tallen5431/Temperature_Sensor_V2/flash/README.md

# Browser-based flashing (ESP Web Tools)

This folder is a self-contained web page that flashes the **Setpoint** firmware
onto an **ESP32-C3** straight from a desktop browser — no Arduino IDE, no toolchain.
It's the **lowest-friction on-ramp for hobbyists / kit buyers**: they open a link,
click one button, and the probe is ready to set up.

```
flash/
├── index.html                    the flashing page (ESP Web Tools install button)
├── manifest.json                 firmware descriptor ESP Web Tools reads (chipFamily: ESP32-C3)
├── build_merged_bin.sh           builds the single merged .bin the page flashes
└── setpoint-esp32c3.merged.bin (generated — NOT committed, .gitignored)
```

> **Different board?** `manifest.json` targets the **ESP32-C3** we ship on. To
> support another chip, build its merged image and add a second entry to the
> `builds` array with the matching `chipFamily` (e.g. `"ESP32"`, `"ESP32-S3"`);
> ESP Web Tools auto-selects the build matching the connected chip.

> **"No OTA" is fine for browser flashing.** The firmware is built with the *No OTA
> (2MB APP / 2MB SPIFFS)* partition scheme because it's too large for the default
> layout. That does **not** affect web flashing: ESP Web Tools writes the entire
> image over USB serial, so an over-the-air update slot is irrelevant. The build
> script compiles with that exact scheme so the flashed layout matches your units.

## How it works

`index.html` loads the [ESP Web Tools](https://esphome.github.io/esp-web-tools/)
web component, which uses the browser's **Web Serial** API to talk to the ESP32
over USB. `manifest.json` tells it which binary to flash (a single merged image at
offset `0x0`).

**Browser support:** Web Serial works in **Chrome, Edge, and Opera on desktop**,
over **HTTPS** (or `http://localhost`). Safari, Firefox, and mobile browsers can't
flash — the page shows a note and points those users to manual flashing.

## Publishing it (one-time)

1. **Generate the firmware binary** (you need `arduino-cli` + the esp32 core, and
   `esptool`):
   ```bash
   arduino-cli core install esp32:esp32
   pip install esptool
   ./flash/build_merged_bin.sh          # writes flash/setpoint-esp32c3.merged.bin
   ```
   Bump `manifest.json`'s `version` **and** the `firmware v…` on `index.html`
   to match `FW_VERSION` (`esp32_temp_probe/esp32_temp_probe.ino`).
   `tests/test_version_sync.py` fails if you forget — this drifted twice while
   it was only a note here, and a stale `version` tells ESP Web Tools a probe
   on old firmware is already current.

2. **Host the `flash/` folder over HTTPS.** The easiest free option is **GitHub
   Pages**: enable Pages for this repo (Settings → Pages → deploy from the default
   branch), then the page is served at
   `https://<you>.github.io/<repo>/flash/`. Because the binary is `.gitignored`,
   either commit it to the Pages branch specifically or publish it as a release
   asset and point `manifest.json` at that URL.

3. **Link it** from your product listing, the unit label/QR, and the README.

> Like every firmware step here, the produced binary **must be validated on real
> ESP32-C3 hardware** (build → flash → QC per [`../docs/QC_CHECKLIST.md`](../docs/QC_CHECKLIST.md))
> before you ship it. Nothing in `flash/` has been run on hardware.

## Manual flashing (fallback / power users)

Anyone who can't (or would rather not) use the browser can flash with
`arduino-cli`/`esptool` directly — see [`../firmware/README.md`](../firmware/README.md).
The maker's assembly-line path stays [`../firmware/factory_flash.py`](../firmware/factory_flash.py).
