tallen5431/Temperature_Sensor_V2/PROTOCOL.md

# Setpoint ⇄ Setpoint Protocol

**Protocol version: `proto = 1`**
Product: **Setpoint** (hub) / **Setpoint** (probe). This contract is versioned by
`proto` (above), currently `1`; component software versions are tracked separately
(hub: `core/version.py` → `HUB_VERSION`; firmware: `FW_VERSION`) and are not pinned here.

This is the authoritative, versioned contract between Setpoint firmware and the
Setpoint appliance. It is the single source of truth for the wire format: identity,
discovery, provisioning, and ingest. Firmware and hub MUST both conform to this
document. Where this file and code disagree, that is a bug in one of them — fix it,
don't silently diverge.

Setpoint is a **local-first, no-cloud** appliance. All traffic in this document is
LAN-only (probe ⇄ hub, same subnet). There is no outbound telemetry and no account.

---

## 1. Terminology & versioning

| Term | Meaning |
|---|---|
| **Hub** | Setpoint — Python/Flask+Dash app served by waitress on the `PORT` env var: **8088** natively (`Start.sh`/`app.py` default), **8080** in the Docker image. |
| **Probe** | Setpoint — ESP32 firmware, HTTP server on TCP **80**. |
| **`proto`** | Integer protocol version. This document defines `proto = 1`. |
| **Device token** | One shared secret per hub. Authenticates mutating hub endpoints **and** is provisioned onto probes, which echo it back as `X-Token`. |
| **Provision secret** | **Reserved — not implemented in `proto = 1`.** A per-unit secret, intended to guard the probe's `/provision` endpoint in a future revision. No shipping firmware stores or checks one; see §4.1 and §12. Distinct from the device token. |

**Compatibility rule:** the hub **warns, it does not crash**, on an unknown or
mismatched `proto`. A probe advertising `proto` other than `1` is still listed and
its data still ingested on a best-effort basis; the hub logs a warning so the
mismatch is diagnosable. Firmware must therefore never assume a hub will reject it
purely for a version skew. Breaking wire changes require bumping `proto` to `2` and a
new revision of this document.

---

## 2. Probe identity

The probe identity is derived once, deterministically, from silicon and is the single
source of truth used everywhere (mDNS TXT, HTTP headers, `/whoami`).

```
suffix    = last 3 bytes of the ESP32 eFuse (base) MAC, uppercase hex (6 chars)
probe_id  = "Setpoint-" + suffix          e.g.  Setpoint-9A3F2C
hostname  = probe_id + ".local."          e.g.  Setpoint-9A3F2C.local.
```

- `probe_id` is stable for the life of the hardware.
- `probe_id` MUST match `^[A-Za-z0-9_-]{1,32}$`. The hub does **not** reject a
  value that fails it — a bad label is never a reason to lose a good temperature
  — it sanitizes to that charset and files the reading anyway (see §6.4).
- The **same** `probe_id` string appears in the mDNS TXT `id` key, in the
  `X-Probe-ID` ingest header, and in `/whoami`. These MUST be byte-for-byte equal.

---

## 3. mDNS discovery

The probe **advertises**; the hub **browses** (zeroconf).

| Field | Value |
|---|---|
| Service type | `_temps-probe._tcp.local.` |
| Transport / port | TCP **80** |
| Server (host) | `Setpoint-<HEX6>.local.` (== `probe_id`, verbatim) |

### TXT record keys

| Key | Value | Notes |
|-----|---|---|
| `id` | `<probe_id>` | e.g. `Setpoint-9A3F2C`. **Invariant:** this MUST equal the `X-Probe-ID` header the probe later sends on ingest. |
| `name` | friendly name, else `<probe_id>` | Human label; falls back to `probe_id`. |
| `fw` | firmware semver | e.g. `2.0.0`. |
| `proto` | `1` | Protocol version this firmware speaks. |

**`id == X-Probe-ID` invariant.** The hub keys and reconciles probes on this equality.
On ingest, if both the `X-Probe-ID` header and a body `probe_id` are present and they
disagree, the hub logs a warning (`probe_id mismatch: header=… body=…`) and proceeds
using the header value — it does not reject the reading.

> The hub also advertises *itself* over mDNS as an `_http._tcp.local.` service so a
> browser can find the dashboard. That is a convenience for humans and is **not** part
> of this probe protocol; probes never need to browse for the hub — they are told the
> ingest URL during provisioning (§5).

---

## 4. Probe HTTP endpoints (firmware serves, port 80)

### 4.1 `POST /provision`

Configures the probe with the hub's ingest URL, the device token, and the post
interval. Persisted to NVS so it survives reboots.

**Request headers**

| Header | Required | Value |
|---|---|---|
| `Content-Type` | yes | `application/json` |
| `X-Provision-Secret` | no — **reserved** | Reserved header name for a future per-unit secret. **Not implemented in `proto = 1`:** the shipping firmware accepts `/provision` from any host on the LAN, which is what makes zero-touch auto-provisioning work. A probe MUST NOT reject a request for lacking this header. See §12. |

**Request body**

```json
{
  "server_url": "http://192.168.1.50:8088/api/ingest",
  "token": "s3cr3t-device-token",
  "interval_ms": 5000,
  "resolution_bits": 11,
  "alert_min_c": 1.0,
  "alert_max_c": 5.0,
  "sample_ms": 60000
}
```

- `resolution_bits` is **optional** (DS18B20 resolution, `9`..`12`; 9=0.5 °C/~94 ms,
  10=0.25 °C, 11=0.125 °C/~375 ms default, 12=0.0625 °C/~750 ms). Omitting it leaves
  the probe's current resolution unchanged, so a hub that doesn't manage it (or an
  older one) is unaffected; an older probe simply ignores the unknown field. Note
  that 12-bit's 750 ms conversion exceeds a 500 ms interval and caps the sample rate.
- `alert_min_c`, `alert_max_c`, `sample_ms` are the **threshold watch** (hub ≥ 2.6.2,
  firmware ≥ 2.9.0), and are sent as a set or not at all. They let a probe on a long
  `interval_ms` notice an excursion between reports instead of sitting on it: it wakes
  every `sample_ms`, reads the sensor with the radio **off**, buffers the reading, and
  transmits early only when a reading crosses a limit. See §5.3.
  - The two limits are sent **including explicit `null`s**. A null CLEARS a limit the
    probe is holding — omitting the key instead would leave a probe watching a
    threshold the hub has deleted, waking every `sample_ms` for nobody.
  - A probe MUST ignore `sample_ms` unless it holds at least one limit **and**
    `sample_ms` is shorter than `interval_ms`; below a 5000 ms floor it MUST ignore it
    too. Sampling no faster than you report gains nothing and costs wakes.

**Response** `200 OK`

```json
{ "id": "Setpoint-9A3F2C", "name": "Garage Fridge", "fw": "2.0.0", "accepted": true }
```

The probe persists `server_url`, `token`, `interval_ms`, `resolution_bits` and the
three watch fields to NVS and begins posting (§5). It echoes `resolution_bits` in
`/whoami` and `/status`, and `watch_armed` / `sample_ms` / the limits in `/status`, so
the hub can confirm what was applied — a probe that was asleep when a limit changed
keeps the old one, and that drift is otherwise invisible from both ends.

> **Hub implementation note.** Setpoint's built-in auto-provisioner and the
> `POST /api/provision` endpoint push
> `{server_url, token, interval_ms, resolution_bits, alert_min_c, alert_max_c, sample_ms}`
> to the probe's `/provision` (trying the probe IP first, then its `.local` hostname).
> No provision secret is sent or required — no firmware revision enforces one (§4.1).
> Anything on the LAN that can reach the probe can provision it.

### 4.2 `GET /whoami`

```json
{ "id": "Setpoint-9A3F2C", "name": "Garage Fridge", "fw": "2.0.0", "mac": "24:6F:28:9A:3F:2C" }
```

`id` MUST equal the mDNS TXT `id` and the `X-Probe-ID` ingest header.

### 4.3 `GET /status`

```json
{
  "id": "Setpoint-9A3F2C",
  "wifi_rssi": -57,
  "uptime_s": 43120,
  "last_post_ok": true,
  "last_post_code": 200,
  "server_url": "http://192.168.1.50:8088/api/ingest",
  "temperature_c": 4.2,
  "sensor_ok": true
}
```

`sensor_ok` is `false` when the sensor reports a fault (see §8); in that state the
probe skips posting.

A probe running the threshold watch (§5.3) also reports what it is **actually
holding**, which is not always what the hub last decided — a probe asleep when a
limit changed keeps the old one, and without this the drift is invisible from both
ends. A hub SHOULD compare these before re-provisioning, or it either re-pushes
every cycle or never notices a stale limit:

```json
{ "…": "…", "watch_armed": true, "sample_ms": 60000,
  "alert_min_c": 1.0, "alert_max_c": 5.0, "in_breach": false }
```

`sample_ms`, `watch_armed` and `in_breach` are always present on firmware ≥ 2.9.0;
each limit appears only while it is set, so an absent key means "no limit", matching
the `null` the hub sends to clear one. Firmware that predates the watch omits all of
them, and a hub MUST treat that as "nothing to compare" rather than as a mismatch.

On the humidity build variant (firmware built with `-D SENSOR_SHT4x`, see §8) the
response carries one extra field, `humidity_pct` (0–100):

```json
{ "…": "…", "temperature_c": 24.1, "humidity_pct": 58.3, "sensor_ok": true }
```

Temperature-only builds (DS18B20 / MAX31855) omit `humidity_pct` entirely.

---

## 5. Ingest — probe → hub

Every `interval_ms`, the probe POSTs the latest good reading to the provisioned
`server_url` (which is the hub's `POST /api/ingest`).

**Request headers**

| Header | Required | Value |
|---|---|---|
| `Content-Type` | yes | `application/json` |
| `X-Probe-ID` | yes | `<probe_id>` — MUST equal the mDNS TXT `id`. |
| `X-Token` | yes* | The device token received during provisioning. *Required whenever the hub has a token set (the shipped product always does — see §7). |

**Request body**

```json
{
  "temperature_c": 4.2,
  "probe_id": "Setpoint-9A3F2C",
  "timestamp": "2026-07-06T14:03:11"
}
```

- Send **`temperature_c`** (preferred) **or** `temperature_f`; the hub derives the
  other. (For robustness the hub also accepts the aliases `temp_c`/`t_c`/`c` and
  `temp_f`/`t_f`/`f`, but firmware SHOULD emit `temperature_c`.)
- `probe_id` in the body is optional but SHOULD be sent and MUST match `X-Probe-ID`.
- `timestamp` is optional ISO-8601, and **may carry millisecond precision**
  (`2026-07-06T14:03:11.500Z`), which the hub preserves so a high-rate cadence
  (down to the 500 ms floor) stays distinguishable instead of collapsing onto one
  whole-second stamp. The hub holds the authoritative clock, so if the field is
  omitted **or not a valid ISO datetime** the hub stamps its own receipt time. A
  probe with a synced clock (NTP, or an RTC restored across deep sleep) SHOULD
  send it — the current firmware does, to ms precision. (Alias `ts` also accepted.)
- **`humidity_pct`** is **optional** (0–100 %RH). Only the SHT4x build variant emits
  it; temperature-only probes omit it. The hub validates it (finite, 0–100) and
  silently ignores anything invalid. (Aliases `humidity`/`rh`/`h` also accepted.)
  A reading *with* humidity looks like:

```json
{
  "temperature_c": 24.1,
  "humidity_pct": 58.3,
  "probe_id": "Setpoint-9A3F2C",
  "timestamp": "2026-07-06T14:03:11"
}
```

- **`battery_pct`** is **optional** (0–100 %): a battery-powered probe MAY report its
  remaining charge. Mains-powered probes simply omit it.
- **`battery_v`** is **optional** (volts): as an alternative to `battery_pct`, a probe
  may report its raw single-cell LiPo pack voltage and let the hub do the conversion —
  the hub maps it linearly **3.0 V → 0 %, 4.2 V → 100 %** and clamps to that range. A
  voltage outside the plausible cell band (2.5–5.0 V) is sensor junk, not a nearly
  full/empty cell, and is treated as "no battery reading". When `battery_pct` is
  present it takes precedence and `battery_v` is not consulted.
- **`site`** is **optional** and is sent as the **`X-Site` header**, not a body field —
  it labels a whole batch, not a row. It exists for multi-site roll-up: a store hub
  forwarding its readings to an aggregating hub tags them with its own site name so
  head office can tell six stores apart. A probe posting directly never sends it, and
  every reading on a single-site hub therefore carries `site = ''`. Sanitised to
  `[A-Za-z0-9_-]`, 32 chars, like `probe_id`. Rows that carry a site are **not**
  forwarded onward, which is what stops two hubs pointed at each other from looping.
  See [`docs/MULTI_SITE.md`](docs/MULTI_SITE.md).
- Both battery fields are **ignored when absent or invalid** — like humidity, battery
  is never a reason to reject a good temperature (see §6). The derived percentage is
  stored per reading and surfaced in the hub UI and readings API; adding these
  backward-compatible optional fields required **no `proto` change**.

#### Humidity & VPD

The probe only ever reports **temperature** and (on the SHT4x variant) **humidity**.
**VPD (vapour pressure deficit) is not part of the wire protocol** — the probe never
sends it. The **hub computes VPD** from the temperature + humidity of each reading
using the **Tetens** saturation-vapour-pressure formula, optionally applying a
leaf-temperature offset from hub config `settings.vpd_leaf_offset_c` (default `0.0`;
growers commonly use `~2.0` to model leaf-below-air temperature). VPD is derived,
stored, and displayed entirely hub-side, so adding it required **no `proto` change**:
`humidity_pct` is a backward-compatible optional field and this document remains
`proto = 1`.

**Success** `200 OK`

```json
{
  "ok": true,
  "config": {
    "interval_ms": 300000,
    "resolution_bits": 11,
    "alert_min_c": 1.0,
    "alert_max_c": 5.0,
    "sample_ms": 60000
  }
}
```

**`config` — settings delivery back to the probe (hub ≥ 2.6.2, firmware ≥ 2.8.1).**
The hub returns the settings it wants this probe (identified by `X-Probe-ID` or the
body's `probe_id`) to be running. A probe SHOULD apply them and persist them, and
MUST tolerate the key being absent — an older hub simply omits it.

This exists because pushing to the probe's `POST /provision` (§4.1) is unreliable
for a deep-sleeping probe: it serves its HTTP window for only a few seconds every
Nth wake, so on a long interval the hub can rarely catch it awake and a settings
change may never be delivered. The probe's own ingest POST happens every wake and
always succeeds, so config rides home on the reply at no extra radio cost. The two
paths derive the value from the same source, so they cannot disagree.

Carries the same fields as the `/provision` push (§4.1) **except** `server_url` and
`token`, which remain push-only so a hub reply can never re-point a probe at a
different server: `interval_ms`, `resolution_bits`, and the three threshold-watch
fields `alert_min_c` / `alert_max_c` / `sample_ms`. The limits are sent as explicit
`null`s when the hub holds none, which is what disarms a probe still watching a
deleted threshold.

A probe MUST ignore an `interval_ms` below its own 500 ms floor, a `resolution_bits`
outside 9..12, and a `sample_ms` that is below 5000 ms or not shorter than
`interval_ms` (§4.1).

> The set of fields here is not a judgement call to be re-made per endpoint — both
> paths derive it from one function on the hub, and `tests/test_protocol_doc.py`
> fails if this list and that function disagree. This paragraph read "deliberately
> limited to `interval_ms` and `resolution_bits`" for two releases after the watch
> shipped, which would have led anyone writing a second firmware to drop the three
> fields that make it work.

**Errors**

| Status | Body | Cause |
|---|---|---|
| `400` | `{"ok": false, "error": "<reason>"}` | No temperature value, non-finite, or out of range (§6). |
| `401` | `{"ok": false, "error": "unauthorized"}` | Missing/wrong token when the hub requires one. |
| `413` | `{"ok": false, "error": "payload too large"}` | Body exceeds 64 KiB. |
| `405` | `{"ok": false, "error": "method not allowed; use POST"}` | `GET /api/ingest` — ingest is **POST-only**. |
| `500` | `{"ok": false, "error": "<reason>"}` | Persist failure on the hub. |

### 5.1 Bulk backlog drain — `POST /api/ingest_csv`

Live readings use `POST /api/ingest` (one reading per request). But a probe that
was offline (weak Wi-Fi, hub down) buffers readings to flash and, on reconnect,
must drain a backlog that can be thousands of rows. Sending those one-per-POST is
slow and — on a battery probe — burns radio time. `POST /api/ingest_csv` uploads
a **chunk of buffered readings in a single request**, written to the log in one
transaction.

Same auth (`X-Token`) and the same 64 KiB body cap as `/api/ingest`; **≤ 1000
rows per request**.

**Both limits bind, and the byte one usually binds first.** 1000 rows is not
reachable in practice: 500 temperature-only readings already encode to ~62 KB of
the 64 KB budget, and 500 from a probe reporting humidity and battery encode to
~85 KB and are refused. A sender must size its batch by the encoded body, not by
a row count — see `core.forwarder.fit_batch`, which trims to a prefix that fits
(a prefix, so a sender's cursor can never advance past a record that was not
actually accepted).

Two body formats are accepted:

- **`Content-Type: text/csv`** (preferred; the probe's on-flash buffer format) —
  one reading per line, `timestamp,temperature_c,temperature_f,probe_id`:

  ```
  2026-07-24T10:00:00,4.0,39.2,Setpoint-9A3F2C
  2026-07-24T10:00:05,4.1,39.4,Setpoint-9A3F2C
  ```

- **`Content-Type: application/json`** — `{ "readings": [ {…}, … ] }` or a bare
  array, each element the same object shape as a single `/api/ingest` body.

  The object form may also carry an optional **`events`** array — alert-lifecycle
  records (`{"timestamp", "kind", "probe_id", "temperature_c", "limit_c", "epoch"}`)
  from a **forwarding hub**, never from a probe. Probes have no event log, which
  is why this is JSON-only and absent from the CSV form. See §5.2.

Each reading is validated exactly like `/api/ingest` (§6: finite, `-60..150 °C`,
timestamp normalisation, per-probe calibration). Invalid rows are skipped, not
fatal — one corrupt line never rejects the rest of the chunk.

**Response** `200`: `{ "ok": true, "accepted": <int>, "rejected": <int>, "restamped": <int>, "events": <int> }`.
Errors mirror `/api/ingest` (`401` unauthorized, `413` too large / > 1000 rows,
`400` unparseable body, `503` storage error).

- `accepted` — rows **newly stored**. For rows that CARRY A TIMESTAMP, ingest is
  idempotent (`UNIQUE(probe_id, epoch, site)` + `INSERT OR IGNORE`): a re-sent
  chunk after a dropped ACK is deduped and legitimately reports `accepted: 0`.
  **A probe MUST advance its buffer checkpoint on the `200` itself, not on
  `accepted`** — treating `accepted: 0` as failure would re-send the same chunk
  forever and never drain the backlog.

  > **Replay is only free for stamped rows.** A row with no timestamp is
  > receipt-stamped by the hub on arrival (§6.2), so a replay of it gets *new*
  > stamps, new epochs, and stores as duplicates. Measured on a live hub: five
  > stamped rows sent three times store five; five unstamped rows sent three
  > times store **eight** — partly deduped only where receipt stamps happened to
  > collide, so the surplus is not even predictable.
  >
  > This is reachable in one configuration: firmware ≥ 2.8.2 buffers a reading
  > whose clock has never synced with an empty timestamp field (deliberately —
  > before that the reading was dropped outright, which was worse), and that is
  > the local-first, no-internet deployment where NTP never arrives. It needs the
  > ACK specifically to be lost, so it is narrow, but it is real and it is not
  > what the paragraph above used to promise.
  >
  > Closing it properly needs a stable per-row ordinal in the buffer format —
  > a wire change on both sides, so it is recorded here rather than half-done.
  > Hashing the chunk body is **not** a fix: a freezer holding steady produces
  > byte-identical consecutive chunks legitimately, and suppressing those would
  > discard real readings.
- `rejected` — rows the hub refused: outside the §6 range band, non-finite, or
  structurally unusable (a JSON element that is not an object, a CSV line with
  fewer than four fields — the shape a buffer truncated mid-append leaves
  behind). These will never be accepted, so they must not block the checkpoint
  either. Blank lines are padding, not rows, and are not counted.
- `restamped` — rows whose own timestamp was implausibly far in the future (a
  probe whose clock drifted during the very outage that filled its buffer) and
  which the hub therefore receipt-stamped on arrival, spread 1 ms apart. A
  non-zero value means that chunk's chronology is drain-time, not
  measurement-time — check the probe's clock. The spreading is what stops such a
  chunk collapsing onto a single epoch and being discarded by the unique index.

### 5.2 Forwarded alert events (hub → hub only)

A hub aggregating other hubs receives two records, not one. Readings say what a
sensor measured; **events** say what that store's own alert engine *decided*
about it, against that store's own thresholds. Head office re-evaluating the same
readings against its own limits gives a different answer, and it is the store's
answer that belongs in its audit trail — so the event log travels with the
readings.

Events ride the optional `events` array of a JSON `/api/ingest_csv` body, with
the same `X-Token` and `X-Site` headers as the readings beside them:

```json
{
  "readings": [ … ],
  "events": [
    {"timestamp": "2026-08-04T10:00:00", "epoch": 1785837600, "kind": "high",
     "probe_id": "walkin", "temperature_c": 15.0, "limit_c": 8.0}
  ]
}
```

`kind` is one of `high low recovery offline online rate`; `temperature_c`,
`limit_c` and `epoch` are optional. Rows are stamped with the batch's `X-Site`,
so an event's site names the hub that **recorded** it — `''` for the receiving
hub's own.

**`epoch`** is the POSIX instant the sending hub recorded the event at, and it is
**hub-to-hub only** — nothing else sends events, so nothing else needs it. It
exists because `timestamp` on this array is the sending hub's LOCAL wall clock
with no zone marker, and a receiver in a different timezone re-reading it as its
own shifts a store's audit trail by the offset between them. When `epoch` is
present the receiver uses it verbatim and renders `timestamp` from it in its own
wall clock; when it is absent the stamp is resolved exactly as before, so a
sender that does not know this field is unaffected.

Readings, by contrast, carry their instant IN the timestamp — a forwarding hub
sends them as UTC with a trailing `Z`, which §6's normalisation already
converts and `absolute_epoch` already recovers.

A malformed event is skipped, never fatal: an event must not cost a reading. The
`events` count in the response is informational for the same reason `accepted`
is — a forwarding hub advances its event cursor on the `200`, not on the count.

**Idempotency for events is partial by design.** Event epochs are whole seconds
(readings carry milliseconds), so the unique key
`(kind, probe_id, epoch, site) WHERE site != ''` constrains **forwarded rows
only**. Applying it to locally-recorded events would treat two genuinely distinct
same-second events as a replay and silently drop one; a replay can only arise
from a re-sent batch anyway.

### 5.3 Threshold watch — sample often, transmit rarely

A probe on a long `interval_ms` can sit on a thawing freezer until its next
scheduled POST. The watch decouples **reading** from **reporting**, exploiting the
asymmetry between them: reading the sensor is a conversion and some CPU; associating
and POSTing is seconds of radio at ~100 mA.

While armed — at least one limit held, `sample_ms` ≥ 5000 and `sample_ms` <
`interval_ms` (§4.1) — a probe:

1. wakes every `sample_ms` and reads the sensor **without powering the radio**;
2. appends the reading to a local buffer and sleeps again;
3. transmits immediately when a reading CROSSES a limit — entering a breach is
   judged against the bare limit, leaving it must beat the limit by a deadband, so a
   probe parked exactly on its threshold does not transmit an enter/clear pair every
   sample and flatten its battery;
4. transmits on the `interval_ms` deadline regardless, and flushes the buffer with
   it (§5.1), so the hub also receives the finer history at no extra radio cost.

Sleep duration is `min(sample_ms, time_until_next_report)` — never past the report,
or the report lands late by up to a whole sample gap. A probe MAY report up to half a
sample gap EARLY, taking the last sample before the deadline as the report rather
than spending an extra wake to be punctual; it MUST NOT report late.

The hub decides `sample_ms` per probe, so cadence can differ across a fleet: a
mains-powered walk-in can afford to look every 10 s where a battery probe in a remote
freezer should not. None of this changes the ingest payload — a buffered reading is
an ordinary reading with its own timestamp — so the watch required no `proto` change.

---

## 6. Hub validation rules (`POST /api/ingest`)

The hub validates every reading before it touches the log:

1. **Temperature present:** at least one of the celsius/fahrenheit keys must be
   present and non-empty, else `400`.
2. **Finite:** the resolved celsius value must be a finite number (no `NaN`/`inf`),
   else `400`.
3. **Range:** celsius must satisfy `-60.0 ≤ t_c ≤ 150.0`, else `400`. This band
   rejects the `-127` disconnected fault code and anything else out of band, so it
   cannot poison dashboard statistics or the auto-scaled axis. The `85.0` power-on
   value is **in band and is deliberately accepted here** — it is a physically
   plausible temperature, and a hub that dropped it would silently lose real
   readings from an oven or a steam line. It is suppressed at the probe instead
   (§8), which is the only place that can tell the fault code from the reading.
4. **probe_id:** sanitized against `^[A-Za-z0-9_-]{1,32}$` — disallowed characters
   are stripped and the result truncated to 32. The reading is never rejected for
   its id. If nothing valid remains (or none was sent at all), it is filed under
   the reserved id **`unidentified`**, which appears on the dashboard and the
   Devices page like any other probe, so a sender that is not identifying itself
   is visible rather than silently invisible. It can be renamed or removed there.
   *(Earlier hubs stored such a reading under the empty string, which every UI
   surface skips and "remove device" cannot touch — the row existed, counted
   toward the readings total and appeared in the CSV export, and no screen ever
   showed it. Rows already stored that way are left alone; only new ingest is
   affected.)*
5. **Method:** `GET /api/ingest` returns `405`; only `POST` mutates the log. (A prior
   version accepted `GET`, letting a drive-by `<img>` poison the CSV — closed.)
6. **Size:** bodies over **64 KiB** are rejected `413`.
7. **Humidity (optional):** if `humidity_pct` is present it must be finite and within
   `0 ≤ rh ≤ 100`, else it is dropped (the reading is still accepted — humidity is
   never a reason to reject a good temperature). When a valid humidity is present the
   hub derives **VPD** from it (see §5, *Humidity & VPD*).
8. **Battery (optional):** if `battery_pct` is present it must be finite and within
   `0 ≤ pct ≤ 100`, else it is dropped. Failing that, a present `battery_v` must be
   finite and within `2.5 ≤ v ≤ 5.0`; it is mapped linearly `3.0 V → 0 %`,
   `4.2 V → 100 %` and clamped. An absent or invalid battery value never rejects the
   reading (see §5).

Accepted readings are persisted to the CSV log with columns:

```
timestamp,temperature_c,temperature_f,humidity_pct,vpd_kpa,probe_id
```

`humidity_pct` and `vpd_kpa` are blank for temperature-only probes; older logs are
auto-upgraded to this header on load. Per-probe calibration (`gain` then `offset_c`,
from hub config) is applied to temperature before logging, and fahrenheit is recomputed
from the calibrated celsius.

---

## 7. Token flow (single device token)

There is exactly **one** device token per hub. It authenticates mutating hub endpoints
and is the value probes echo on ingest.

```
        ┌── SERVER_TOKEN env  ─┐
        │   config token       │   (precedence, first non-empty wins)
        │   freshly generated  │   (secrets.token_urlsafe; saved to config.json)
        └──────────┬───────────┘
                   │  held in hub config as  provision_token
                   ▼
   hub  ──POST /provision {server_url, token, interval_ms}──►  probe   (token persisted to NVS)
                   ▲                                                │
                   │                                                │  every interval_ms
                   └──────  POST /api/ingest  X-Token: <token> ◄────┘
```

- **Resolution order at startup:** `SERVER_TOKEN` env → existing config
  `provision_token` → freshly generated (persisted to `config.json`, printed
  once at startup). The shipped product therefore always has a non-empty token and is
  **secure-by-default** while remaining plug-and-play, because the same token is pushed
  to every discovered probe by the auto-provisioner.
- **How the hub reads a token on a request:** `X-Token` header → `?token=` query param
  → JSON body `token` field, compared for equality against the device token.
- **Empty token = open mode.** If the token is empty (tests / air-gapped dev) the hub
  accepts unauthenticated requests. The shipped appliance never runs this way.
- The token is a secret: `GET /api/config` redacts it (and `smtp_password`) to
  `"***set***"`. It is never written to the downloadable CSV.

### Hub REST endpoints (prefix `/api`)

| Endpoint | Auth | Purpose |
|---|---|---|
| `GET /api/health` | none | `{ok, version, protocol, probes, base, time, rows_written, ingest_rejected, write_failures, last_write_age_sec, workers, workers_down, healthy}` |

`workers` is `{name: alive}` for the hub's background threads; `workers_down` lists
only those whose death stops the hub doing its job (currently just `alert_monitor`),
and any entry there forces `healthy: false`. Readings are written on the request
thread, so a dead alert monitor leaves every other field in this payload looking
correct while no alarm can ever be raised — which is why it gets its own term
rather than being inferred. `setpoint_worker_up{worker="…"}` carries the same
per-worker state on `/metrics`.
| `GET /api/config` | token | Redacted config. |
| `POST /api/config` | token | Update config. |
| `GET /api/probes` | none | `[{host, ip, port, name, probe_id, last_seen}]` |
| `POST /api/provision` | token | Hub pushes ingest URL + token to probe `/provision`. |
| `POST /api/ingest` | token | Ingest one reading (§5, §6). |
| `GET  /api/ingest` | — | `405`, POST-only. |
| `POST /api/ingest_csv` | token | Bulk backlog drain (§5.1, ≤ 1000 rows/request). |

`GET /download/temperature_log.csv` is the **only** downloadable file.

---

## 8. Sensor faults

Sensor: **DS18B20** on a GPIO with a 4.7 kΩ pull-up (thermocouple **MAX31855** or
temp+humidity **SHT4x** optional at build time — see firmware `build_flags`
`-D SENSOR_MAX31855` / `-D SENSOR_SHT4x`). Known fault readings — `85.0 °C` (power-on
default), `-127 °C` / `NaN` (disconnected) — MUST cause the probe to set
`sensor_ok = false` and **skip posting** that cycle.

As defence in depth the hub's §6 checks catch `-127` and `NaN` if they reach it
anyway. They do **not** catch `85.0`, which is inside the accepted range and has
to be: it is a real temperature. Suppression at the probe is therefore the sole
defence against the power-on value, which is why it is a MUST above and not a
recommendation.

---

## 9. SoftAP setup flow

A probe with no saved Wi-Fi credentials brings up onboarding:

1. Probe starts an **open SoftAP** (no password) with SSID `Setpoint-<hex>`.
2. The operator joins that AP; a **captive portal** at `http://192.168.4.1` lists
   nearby networks.
3. Operator selects the home SSID and enters its password; the probe **persists the
   credentials to NVS**, leaves AP mode, and joins the home network.
4. On the home network the probe advertises over mDNS (§3) and awaits provisioning
   (§5). No cloud, no account — configuration never leaves the LAN.

---

## 10. Threat model (LAN-scoped)

Setpoint is designed for a trusted home/small-business LAN, not a hostile network. The
protocol nonetheless hardens against realistic local threats:

| Threat | Mitigation |
|---|---|
| Rogue host poisoning the log | Mutating endpoints require the device token (`X-Token`); ingest is POST-only, so a drive-by `GET`/`<img>` cannot write. |
| Sensor faults / bad data corrupting stats | Finite + `-60..150 °C` range validation (§6); firmware also suppresses fault codes at source (§8). |
| Disk-fill / DoS | 64 KiB body cap (`413`); bulk CSV capped at 1000 rows/request. |
| Unauthorized probe reconfiguration | **Not mitigated in `proto = 1`.** `/provision` is deliberately unauthenticated so zero-touch provisioning works, so any LAN host can repoint a probe's ingest URL. Same trust boundary as discovery itself. Keep probes on a trusted LAN; see `SECURITY.md`. |
| Spreadsheet formula injection via CSV export | Fields beginning with `= + - @` etc. are neutralized on write. |
| Secret leakage | Token and SMTP password redacted in `GET /api/config`; the token is never in the CSV; the download route serves **only** `temperature_log.csv`. |
| Identity spoofing / mix-ups | Deterministic MAC-derived `probe_id`; `id == X-Probe-ID` invariant reconciled at the hub. |

**Out of scope for `proto = 1`:** transport encryption (plain HTTP on the LAN),
per-probe mutual auth beyond the shared device token, and defense against an attacker
who already controls the local network. These are documented limits, not oversights,
for a local-first appliance.

---

*This document defines `proto = 1`. Any incompatible change bumps the version and this
file is revised alongside it.*
