tallen5431/Temperature_Sensor_V2/docs/PILOT_OFFER.md

# Cold-Storage Monitoring — 30-Day Pilot Offer

> **Keep this in step with `site/pilot.html`** — the public page carries the same offer and
> the same caveats, and a customer may well read both.
>
> **Maker note (delete before sending):** This is a one-page offer to hand or email a
> restaurant contact to validate demand **before** you spend on FCC or inventory. Fill in the remaining
> per-send fields (`[Restaurant / contact name]`, `[date]`, `[phone]`), keep it to one page, and treat these first units as **loaner /
> evaluation** units (not a sale) so you stay clean on FCC until your SDoC is done. Positioning
> is **loss prevention**, never HACCP/health-code compliance.
>
> **Install the Fixed (USB) version** for pilots (see [`VERSIONS.md`](VERSIONS.md)): a walk-in has power,
> so drop the battery — you get always-on live readings and instant alerts with **no lithium liability**
> and nothing to swap. The battery (Portable) version is for portable/homelab use, not fixed installs.
>
> **Before you leave the install** (Settings → Reliability & access, then Alerts):
> 1. **Login on** — a restaurant's Wi-Fi is shared with staff and often guests.
> 2. **Outside check-in on** (healthchecks.io), alerting *you* as well as the owner — if the
>    back-office PC is switched off or restarts overnight, this is the only thing that notices.
> 3. **Keep-awake on** (default), Windows auto-start ticked, and laptop lid set to *Do nothing*.
> 4. **Alerts to the owner's phone** via ntfy (`USER_MANUAL.md` §11), then press **Send test** with
>    them standing there.

---

## Setpoint, by Datum Labs — free 30-day walk-in & freezer monitoring pilot

**For:** [Restaurant / contact name]
**From:** Thomas Allen, Datum Laboratories LLC — thomas.allen@datumlaboratories.com · [phone]
**Date:** [date]

### The problem we're solving

A walk-in or freezer that fails overnight isn't found until the morning shift opens the door —
and by then the load is gone. A single failure can spoil **$2,000–$10,000+** of product, plus the
lost prep and the scramble to re-stock. Most kitchens still check temps by hand on a clipboard,
which means nobody is watching the hours when failures actually happen.

### What we'll install (monitoring free for the 30 days)

- A small **monitoring hub** (free software) on a back-office computer you already keep on.
- **[N] wireless temperature probes** — one in each unit you want covered (walk-in cooler,
  walk-in freezer, reach-ins, prep line).
- Each unit gets its own **safe high/low range**, pre-set for cooler vs. freezer.

### What you get

- **Alerts in minutes** — email and/or text (via your team's phone or Slack) the moment a unit
  drifts out of range, day or night. A cracked door, a dying compressor, an iced coil — you hear
  about it while the food is still good.
- **One screen** showing every cooler's live temperature and history.
- **A silent-sensor alert** — if a probe loses power or Wi-Fi, that silence is itself an alarm, so
  a dark freezer never passes as "fine."
- **An automatic temperature log** you can export to a spreadsheet any time — less clipboard time
  for your staff.

### What this is — and isn't (so there are no surprises)

- It's an **operational monitoring and loss-prevention tool**. It is **not** a certified,
  NIST-traceable, or HACCP/health-code compliance instrument, and it does **not** replace your
  required manual checks or official records — you and your food-safety plan stay responsible for those.
- Everything runs on power: a **full power outage** stops monitoring (the coolers are off too). We
  can put the hub and router on a small battery backup if that matters to you.
- Alerts that leave the building (**text / email / Slack**) ride your **internet**; if the WAN drops,
  the on-screen dashboard alarm still shows but those remote alerts pause until it's back. Keep the
  alert phone on cellular so a simultaneous internet + cooler failure still reaches someone.

### What we need from you

- A spot for the hub PC (or we bring a small mini-PC) on your Wi-Fi, and access to place probes.
- **~30 minutes** for setup, and a name/number for who should get alerts.
- **Your honest feedback** at the end — did it catch anything, was it easy, what would you pay for it.

### The terms

- **30 days of monitoring, free, no obligation.** No contract. If it's not useful, we pull it out
  and that's that, and you owe nothing for the trial.
- The probes are **loaner equipment on evaluation** — they stay our property for the 30 days and are
  not sold to you. (This is also what keeps the arrangement clean while FCC authorisation for the
  assembled unit is in progress.)
- **Quoted separately, up front, and only if you want them:** a dedicated mini-PC if you'd rather
  not use your own machine, and the install itself if you want the cable routing and probe
  placement done for you rather than doing it yourselves.
- **At the end the probes come back.** They are loaner equipment throughout, and assembled units are
  **not offered for sale** until FCC authorisation is complete — so there is no price to quote you
  yet, and quoting one would undercut the very thing that keeps this arrangement clean. Say the word
  and you'll hear the day that changes; the DIY kit is available now if you'd rather not wait. When
  assembled units do become available the model is **buy once** — no subscription, no monthly fee,
  and the software stays free either way.

### Next step

Reply to **thomas.allen@datumlaboratories.com** or call **[phone]** and we'll schedule a 30-minute install this week.

_— Thomas Allen, Datum Laboratories LLC_
