tallen5431/Temperature_Sensor_V2/docs/EULA.md

# Setpoint End-User License Agreement

_Last updated: 2026_

This End-User License Agreement ("Agreement") is a plain-language summary of the
terms under which you may use the Setpoint hub software (the "Software") that
ships with your Setpoint temperature-monitoring hardware. By installing or
running the Software, you agree to these terms.

## 1. Your right to run the Software

You bought a Setpoint appliance, and the Software that runs it is yours to use.
We grant you a perpetual, non-exclusive right to install and run the Software on
computers you own or control, for as many probes as you like, for your own
monitoring purposes. You may make backup copies. It is always yours to self-host:
it runs on your machine, and nothing we do can take it away from you.

The hub Software itself is **proprietary** — we license it to you under this
agreement rather than releasing it (see the `LICENSE` file). **The probe firmware
is different: it is open source under the MIT License** (`esp32_temp_probe/LICENSE`),
so you are free to read it, build it, modify it, and reflash your probes. That is
the part that guarantees your hardware can never be bricked by us.

## 2. Local-first, no cloud

Setpoint runs entirely on your own computer. Temperature readings, probe names,
and configuration stay on that machine (for example in `temperature_log.db`,
`config.json`). There is no account to create,
no cloud service, and no usage telemetry is sent to us. What you do with your
data is up to you.

## 3. Warranty

The Software is provided **"as is," without any warranty**. Your only warranty is
the **hardware warranty** that came with your Setpoint probes and hub hardware;
nothing in this Agreement adds to or extends that warranty. We do not promise the
Software is error-free or that it will meet every requirement — you are
responsible for validating it for any use where a missed or wrong reading could
cause loss.

## 4. Limitation of liability

To the maximum extent permitted by law, our total liability arising out of or
related to the Software is limited to the amount you paid for the Setpoint
hardware. We are not liable for indirect, incidental, or consequential damages —
including spoiled goods, lost product, downtime, or lost data — even if we were
told such damages were possible. Some jurisdictions do not allow certain
limitations, so parts of this section may not apply to you.

## 5. Third-party components

The Software bundles open-source components, each under its own license. See
`THIRD-PARTY-LICENSES.md` for the list and licenses (generated by
`packaging/gen_third_party_licenses.py` at release time).

## 6. General

If any part of this Agreement is unenforceable, the rest stays in effect. This
Agreement is the entire agreement between you and us regarding the Software and
supersedes any prior understanding on that subject.

**Questions?** Contact **support@datumlaboratories.com**. The Software and the Setpoint
hardware it ships with are supplied by **Datum Laboratories LLC**, 1304 Cottonwood Court Northwest,
Kennesaw, GA 30152, USA.
