tallen5431/Temperature_Sensor_V2/docs/STARTUP_CHECKLIST.md

# Datum Labs / Setpoint — Startup Checklist (LLC · Insurance · FCC · Costs · Order of Operations)

> **Not legal, tax, or financial advice.** A practitioner's checklist with rough 2026 US costs to
> turn hand-built boards into a business you can sell from. Confirm specifics with an accountant,
> an insurance broker, and an FCC test lab. Deep detail on certification lives in
> [`COMPLIANCE.md`](COMPLIANCE.md); market strategy in [`GO_TO_MARKET.md`](GO_TO_MARKET.md).

---

## ⚠️ Read this first — the FCC gotcha that changes everything

**Confirmed for the board you're using** (ESP32-C3 SuperMini, Amazon `B0DFWG87JS`): it's a **bare
`ESP32-C3FH4` chip with a PCB trace antenna — NOT a pre-certified radio module.** That puts you on
the **expensive** FCC path as-is:

- A **pre-certified module** (its own **FCC ID** printed on it, e.g. `ESP32-C3-WROOM-02`,
  FCC ID `2AC7Z-ESPC3WROOM02`) carries the intentional-radiator approval, so you'd only need the cheap
  **Part 15B SDoC** (~$300–1,500).
- A **bare chip + trace antenna** (what the SuperMini is) does **NOT** inherit that approval. Selling
  assembled units would owe **full intentional-radiator FCC testing** (like a full FCC ID:
  **~$5,000–15,000+**) — a non-starter for a small batch.

**Status: DONE.** Rev 2 is built and bench-verified on the shipping firmware. What follows
is kept as the rationale for *why* it was necessary, and as the spec if a future board is laid
out. The remaining gate is the Part 15B SDoC, not the respin.

**Action (completed) — respin rev 2 around a pre-certified module.** The board as built carries the
`ESP32-C3-WROOM-02`. Same
ESP32-C3 chip, **zero firmware change**, and you get the cheap SDoC path **plus** a real
"Contains FCC ID: 2AC7Z-ESPC3WROOM02" label. Note the module is a **surface-mount castellated part**,
not a header-pluggable board — so this is a genuine board redesign (solder the module down instead of
socketing the SuperMini), the biggest change left in your hardware.

**Your current 50 boards still have a job:** they're fine for **loaner pilots, dev, and DIY kits**
(kits sidestep finished-product FCC). They're just not the SKU you sell *assembled* at volume.

---

## The costs, at a glance (rough US ranges)

| Item | When | Rough cost | Notes |
|---|---|---|---|
| **LLC formation** | ✅ Filed 2026-08-03 | **$100** | Georgia Articles of Organization, online. ($110 by mail.) ~7 business days; expedited tiers exist and are not worth it. |
| **Annual registration** | Jan 1 – Apr 1, every year | **$50/yr** | Georgia. Miss it and the LLC is *administratively dissolved*, retroactively voiding the shield. Calendar it. |
| **Registered agent** | ✅ Self | **$0** | Must be a street address **in Georgia** — no PO boxes. Own address = public record; a commercial agent (~$50–150/yr) buys privacy. |
| **EIN (tax ID)** | Now | **Free** | Direct from IRS.gov — never pay a third party for this. |
| **Business bank account** | Now | **$0–15/mo** | Keeps personal/business money separate (protects the LLC shield). |
| **Product-liability insurance** (CGL $1M/occ, $2M agg + products) | Before selling | **~$400–1,200/yr** | Get broker quotes. B2B buyers ask for a Certificate of Insurance (COI). |
| **W-9** | Before B2B sales | **Free** | Restaurants/procurement will request one. |
| **FCC Part 15B SDoC** (finished unit, **assuming a pre-certified module**) | Before selling assembled units | **~$300–1,500** | Simple single-radio build; 2–4 weeks at an accredited lab. See the gotcha above. |
| **FCC labeling** | Before selling assembled units | **~$0** | "Contains FCC ID: [module]" + §15.19(a)(3) statement on each unit. |
| **Per-unit calibration option** (food-service upsell) | Optional / later | **~$140/unit** | Outsourced 3-point accredited cert; only when a buyer asks. |
| **PCB (you've done this)** | — | **~$1/board @ 50** | Bare boards; you hand-solder the 5 parts. |
| **Per-unit material (BOM)** | Per unit | **~$16–22** | Per [`BOM.md`](BOM.md); drops at 10+ qty. |

**Bottom line to get legally sellable (assembled):** roughly **$1,000–3,500 all-in** for LLC +
insurance + FCC SDoC — *if* you're on a pre-certified module. **$0** to start with loaner pilots and
DIY kits.

---

## Order of operations (walk it top to bottom)

### Phase 0 — Set up the shell (this week, ~$100–700, no FCC needed)
- [x] **Form the LLC** — **`Datum Laboratories LLC`**, Georgia, filed **2026-08-03**, certificate pending.
      The house company that umbrellas Setpoint (and future products), and the FCC "US responsible party."
      Trades as **Datum Labs**; invoicing under the short name would need a Cobb County trade-name filing,
      so invoice under the full legal name instead. **This exact string must match the SDoC, the product
      label, the insurance policy and the W-9 character for character.**
- [ ] **Get an EIN** free from IRS.gov — the day the certificate lands, not before (a rejected name would
      leave an EIN attached to an entity that does not exist). Online, Mon–Fri 7am–10pm ET.
- [ ] **Open a business bank account**; run all business money through it (don't pierce the LLC shield).
      Then move the **Tindie payout details and W-9 onto the LLC + EIN** so kit revenue stops landing
      against your SSN.
- [ ] **Get product-liability insurance quotes** (CGL $1M/$2M + products). You may not bind it until
      you sell, but have the number and a COI ready — procurement asks.
- [ ] Keep your warranty's **liability cap** ([`WARRANTY.md`](WARRANTY.md)) intact — LLC + insurance +
      liability cap are your three shields when selling into food service.

### Phase 1 — Validate for ~$0 (loaner pilots, pre-FCC)
- [ ] Hand-build 2–3 units from your first PCB batch; flash + QC with `firmware/factory_flash.py`
      and [`QC_CHECKLIST.md`](QC_CHECKLIST.md).
- [ ] Run **loaner / evaluation pilots** with your restaurant contacts using
      [`PILOT_OFFER.md`](PILOT_OFFER.md). These are evaluations, **not sales** — that keeps you clean
      on FCC while you learn whether they'll pay.
- [ ] In parallel, list a **DIY kit** (bag of parts) on Tindie and post build-in-public to r/homelab
      / Home Assistant forums — kits sidestep finished-product FCC and cost ~$0 to try.
- [ ] **Decision gate:** do pilots convert to "yes, I'd buy this"? Do you have deposits or signed
      intent from a few restaurants? If yes → Phase 2. If no → fix the pitch before spending on FCC.

### Phase 2 — Clear the gate, then sell assembled (once demand is real)
- [x] **Resolve the module question** (see gotcha) — rev 2 respun to the pre-certified
      `ESP32-C3-WROOM-02` (FCC ID `2AC7Z-ESPC3WROOM02`) and bench-verified.
- [ ] **Part 15B SDoC** on the finished rev-2 unit *in its enclosure* — the remaining gate before
      assembled units may be sold. Freeze the case first; the test covers the product as shipped.
- [ ] **FCC Part 15B SDoC** on the finished unit at an accredited lab; keep the signed report.
- [ ] **Label** each unit: "Contains FCC ID: [module ID]" + the §15.19(a)(3) statement.
- [ ] Sell **assembled** units — direct/B2B to restaurants (full margin), homelab assembled on Tindie.
- [ ] Ship with per-unit serial + the audit trail you already have (both help B2B procurement).

### Phase 3 — Scale (only after ~10+ real sales)
- [ ] Larger PCB + parts batch (per-unit cost drops).
- [ ] Add the **calibration option** (~$140/unit) for food-service buyers who ask.
- [ ] Consider **MSP/VAR** channels (recurring monitoring — strong fit for the no-cloud angle).
- [ ] Only now consider a **loan** — for *inventory*, not for certification (which revenue should
      cover by this point). EU/UK is a separate, later decision ([`COMPLIANCE.md`](COMPLIANCE.md) §3).

---

## On taking a loan — sequence it right

- **Do NOT borrow to fund certification before you've validated demand.** The FCC SDoC is small
  ($300–1,500 on the right module); revenue or modest savings should cover it after pilots convert.
- **A loan's job is inventory scaling** once orders are real — an SBA microloan or a business line of
  credit fits then. Borrowing pre-validation is the classic way to end up in debt with a garage full
  of unsold boards.
- The honest sequence is **validate → certify → sell → then finance growth**, not the reverse.
