tallen5431/Temperature_Sensor_V2/docs/TINDIE_LISTING.md

# Tindie Listing — Setpoint (ready to paste)

> _**Maker note (delete before publishing):** Tindie field-by-field copy for the **DIY Kit launch**.
> Brand — product **Setpoint**, store **Datum Labs**. Photos are ready (hero + kit flat-lay +
> dashboard, §7), and the **DIY kit needs no FCC**, so this can go live now: set the **$39** price,
> a **shipping** profile, and your **support link**, then publish. The Assembled option is drafted
> here too, but it needs an **FCC SDoC** first — add it later._

Tindie listing fields, in order:

---

## 1. Product name

```
Setpoint — Local Wi-Fi Temperature Monitor for Homelabs & Server Rooms (No Cloud · Prometheus / Home Assistant)
```

## 2. Summary (one line, keep it under ~140 chars)

```
Wi-Fi temp sensor that reports to a free app on YOUR own PC — no cloud, no account. Prometheus, Home Assistant & MQTT ready.
```

## 3. Category & tags

- **Category:** Electronics → Sensors (or "Internet of Things").
- **Tags** (for search — use as many as apply): `esp32`, `temperature`, `sensor`, `wifi`,
  `homelab`, `home-assistant`, `mqtt`, `prometheus`, `grafana`, `self-hosted`, `no-cloud`,
  `ds18b20`, `server-room`, `iot`.

## 4. Price & options

The **hub software is free**; the probe is the paid item. The DIY kit's landed cost is **≈ $10**
(true ~$10.03; $8.98 tracked — with the bundled data cable, see the *DIY kit COGS* table in
[`BOM.md`](BOM.md)). **Launch at $39**
to seed your first reviews, then raise toward $44–49 once you have traction. Suggested starting points:

| Option (Tindie "product option") | What it is | Suggested price |
|---|---|---|
| **DIY Kit** | Bag of parts + cable + card/QR to the browser-flash page; buyer solders & flashes | **$39 launch** (→ $44–49) |
| **Assembled & Tested** | Pre-built, pre-flashed, QC'd unit (needs FCC SDoC — see below) | **~$69** |
| **4-Probe Pack (Assembled)** | Four units for a whole rack/closet | **~$189** |

> Start with the **DIY Kit** option only if you haven't cleared FCC yet — kits sidestep the
> finished-product rules and get you live fastest. Add the Assembled options once your SDoC is done.

## 5. Description (Tindie supports Markdown — paste this)

```markdown
**Know the instant your rack, closet, or NAS gets too hot — without handing your data to somebody
else's cloud.** Setpoint reports to a small, free app you run on **your own** PC, mini-PC, or NAS,
so your readings never leave the building and your alerts keep working even when the internet doesn't.

### Why it's different
- 🔒 **It can't be shut down.** The probe reports to a hub app you run yourself, and the firmware is
  open. No vendor account to close, no server to sunset — cloud thermometers have bricked overnight
  when their servers went dark. This one won't.
- 🏠 **Your data stays on-prem.** Readings live in a local SQLite database on your machine, exportable
  to CSV anytime. No account, no telemetry, nothing phoning home.
- 🧩 **Drops into the stack you already run:** Prometheus `/metrics`, Home Assistant + MQTT
  auto-discovery, Docker/headless on a NAS, one-click CSV / Excel export.
- 🖥️ **Flash it from your browser.** No Arduino, no drivers, no toolchain — plug in USB-C, click once
  on the web flasher (Chrome/Edge), and it's running the latest firmware. (Assembled units arrive pre-flashed.)
- 🌡️ **One hub, many probes.** Add probes and they self-discover on your LAN — pay for sensors, not a
  per-sensor gateway.
- 🛎️ **Alerts that reach you.** Per-probe high/low thresholds → email or webhook, evaluated on the hub
  so they fire even with no dashboard open.

### Honest specs
| Spec | Setpoint |
|---|---|
| Sensor | Maxim **DS18B20**, waterproof stainless probe (1 m lead) |
| Accuracy | **±0.5 °C typical from −10 °C to +85 °C, uncalibrated; ±2 °C below −10 °C (includes a typical −18 °C freezer)** (add a per-probe offset in the app). Resolution 0.0625 °C is *not* accuracy. |
| Connectivity | **2.4 GHz** Wi-Fi (no 5 GHz) |
| Power | **Portable:** rechargeable 18650 via TP4056 charge/protect, deep-sleeps between reads (**cell not included**). **Fixed:** USB 5 V always-on, no battery. |
| Probes per hub | Dozens — one hub covers a whole rack/site |
| Data | Local SQLite on your PC, one-click CSV / Excel export |
| Hub software | **Free.** Windows 10/11 or Linux; runs headless / in Docker |
| Integrations | Prometheus, MQTT + Home Assistant, CSV, email/webhook alerts |
| Firmware | Open source; on-device Wi-Fi setup |

⚠️ **Needs an always-on computer** (PC, mini-PC, NAS, or home server) on the same network to run the
free hub. If you don't already leave a machine on 24/7, this isn't the right pick.

### What's in the box

**DIY Kit (you solder + flash it):**
- Carrier PCB + **ESP32-C3 SuperMini**, waterproof **DS18B20 probe (JST-PH pre-terminated — no crimping)**,
  4.7 kΩ pull-up, **TP4056** charge/protect board, on/off switch, 18650 holder, and headers
- **USB-C data cable** (for flashing & charging — a real data cable, not charge-only)
- Printed **quick-start card** with the browser-flash QR + link to the full user manual + setup QR
- **Just add a battery:** one reputable **18650** — ~2500–3500 mAh, flat-top or protected (the TP4056
  handles protection); avoid "ultra-high-mAh" counterfeits. Not included (lithium shipping rules), and
  it's the *only* part you supply. (Also no enclosure — this is an open-board kit.)

**Assembled & Tested:** the same build, pre-built, pre-flashed, and QC'd — just add Wi-Fi.

*(The hub app is a free download — no account, and nothing to install on the probe beyond the one-click flash.)*

### FAQ
- **Needs internet/an account?** No — LAN only. Internet is only used if you want email alerts to leave your network.
- **Accuracy?** ±0.5 °C typical from −10 to +85 °C; ±2 °C below that, including a typical freezer. Uncalibrated. Great for "is my rack within range and trending safe," and enough to tell you a freezer failed. Not a certified/NIST/medical instrument.
- **Wi-Fi?** 2.4 GHz only. Setup is on-device (join the probe's temporary network, pick yours) — no phone app.
- **Battery?** Runs on one **18650** (not included — lithium shipping rules). Add any reputable ~2500–3500 mAh flat-top or protected cell; the on-board TP4056 recharges it over USB-C. Or run it always-on from USB with no cell at all.
- **Power loss?** Local alerts keep firing during a *WAN* outage, but nothing survives a full power loss — put your router/hub on a UPS if that's your risk.
- **Open firmware?** Yes — read it, build it, reflash it. You're never locked in.
```

## 6. Shipping

The kit is small and light — PCBs, probe, holder, cable in a 7×5×2 in box, **~5 oz (~0.35 lb)
packed**. Tindie only lets you set a *flat* rate per carrier (no zone pricing), so pick a service
sized to that parcel and set the rate to cover the far-zone case.

**Recommended shipping rate (DIY Kit):**

| Field | Value | Why |
|---|---|---|
| **Shipping Company** | **USPS Ground Advantage** | Cheapest *tracked* option for a small parcel under ~1 lb (replaced First-Class Package); 2–5 days. Priority Mail and UPS/FedEx Ground are overkill for 8 oz. If not in the dropdown, pick generic **USPS** and name the rate "USPS Ground Advantage." |
| **Base rate** | **$6.00** | One order, first unit. An 8 oz Ground Advantage parcel runs ~$5–7 depending on zone; $6 covers most zones near break-even (this is *not* a profit center). |
| **Additional-item (addon) rate** | **$2.00** | A 2nd kit ships in the same box, so it adds a little weight, not another full base rate. |
| **Ships to** | **United States (domestic-only)** | Skips customs forms and — critically — the international **lithium-cell** air-shipping restrictions if you bundle an 18650. Add international later once you've done a few US orders. |
| **Includes Tracking Code** | ☑ **checked** | Ground Advantage includes tracking free; buyers expect it and it protects you in "never arrived" disputes. |
| **Assign to** | **Setpoint DIY Kit** | Attaches the rate to the listing. The 4-pack, if listed, weighs more — give it its own rate. |

> **Measured: ~5 oz / ~0.35 lb packed** (7×5×2 box + foam + parts + cable + card, no cell) — well
> under 8 oz, so **$6 holds**. Put **0.4 lb** in Tindie's weight field (informational under a flat
> rate). Buy the label online (Tindie/Pirate Ship) for commercial Ground Advantage (~$4.50–6). See the
> full packing SOP in [`ASSEMBLY.md`](ASSEMBLY.md#for-the-maker--kit-packing--shipping).
>
> **Alternative — "free shipping":** set base rate to **$0** and raise the price to ~$44. Free
> shipping converts better; for a launch either approach is fine.

- Set a realistic **handling time** (e.g. 3–5 business days for a hand-built batch).

## 7. Photos (upload in this order — first image is the thumbnail)

**Ready now** — from `docs/images/assembly/`:
1. **Hero / thumbnail** — `08-finished-unit.jpg` (probe + board + 18650). *Optional upgrade: reshoot on a dark surface for more pop.*
2. **What's-in-the-kit flat-lay** — `12-kit-contents.jpg`. Lay the USB-C cable in when it arrives, then re-shoot.
3. **Dashboard screenshot** — `11-dashboard.jpg` (live chart).

**Add before/after launch** (worth shooting, not blockers):
4. **In context** — probe tip in a fridge / rack, unit alongside.
5. **Scale shot** — unit in hand.
6. **Macro** — the stainless probe tip.
7. **Label close-up** — serial ID + setup QR (signals traceability).
8. **Multi-probe** — 3–4 units (only if you list a multi-pack).

> **Three good photos (hero + flat-lay + dashboard) is enough to launch** — add the rest as you go.
> A short setup GIF (join probe Wi-Fi → pick network → it appears on the dashboard) converts well if
> Tindie's media supports it.

---

## Before you publish — checklist

- [x] **Real photos of a real unit** — hero (`08-finished-unit`), kit flat-lay (`12-kit-contents`),
      and dashboard (`11-dashboard`) are ready. Enough to launch; add the extras from §7 over time.
- [ ] **Support link** set in Tindie's field (use `support@datumlaboratories.com`). Store name = **Datum Labs**.
- [x] **Prices** set from real costs — **$39 launch** (`docs/BOM.md` DIY-kit COGS ≈ $10 landed).
- [x] **Shipping rate** decided — **USPS Ground Advantage, $6 base / $2 addon, domestic-only, tracking
      on**, assigned to the DIY Kit (see §6). Weigh the packed kit to confirm the flat rate.
- [ ] **Inventory count** from your first batch.
- [ ] **Payout set up** — Tindie revamped payouts in mid-2026; confirm the current method at signup.
- [ ] **Exclusivity:** a product active on Tindie **can't be listed elsewhere on the web** at the same
      time. Use Tindie as your one paid channel for the probe; keep your own site for the *free
      software*, waitlist, and build-in-public — not a competing listing of the same SKU.
- [ ] **FCC:** the **DIY Kit** option sidesteps finished-product rules and can go live now; the
      **Assembled** options legally want an **FCC Part 15B SDoC** first (`docs/COMPLIANCE.md`).
- [ ] Keep the **"honest specs"** framing (accuracy vs resolution; not a certified instrument) — it
      prevents returns and builds trust with technical buyers.

Store approval is typically **under 48 hours** after you submit the listing. Tindie fee is **5% of the
order total**; listing is free.
