tallen5431/Temperature_Sensor_V2/docs/ETSY_EBAY_LISTINGS.md

# Marketplace listing drafts — Etsy & eBay

Ready-to-paste copy for selling custom / replacement 3D-printed parts as **made-to-order**
(no inventory needed — you print each job after it's ordered). Keep prices here in sync with
the `replacement-parts.html` pricing tiers; marketplace prices should run ~10–15 % above the
direct-site prices to cover fees.

> **Etsy fees, precisely** (they are charged on the item **plus** shipping, which is the part most
> calculators miss): $0.20 listing + 6.5 % transaction + 3 % + $0.25 processing — about **12 %** of a
> $39 order shipped at $6. **Offsite Ads** adds **15 %** (dropping to 12 % once your shop passes
> $10k in a 365-day window) but *only* on orders that arrive from an offsite ad click, taking those
> to roughly **27 %**. Below $10k/yr you can opt out of Offsite Ads entirely; at $10k enrolment
> becomes permanent. **eBay** is ≈ 13 % (final value fee + fixed per-order charge).

> **You still need photos.** A listing can't be image-less. Use capability shots: sample
> prints, the printer, close-ups of finished parts, and a before/after of a demo part
> (the wrench + calibration-marker + printed replacement). The same shots seed the site's
> capability-demo section.

---

## Etsy

**Settings:** Who made it → *I did* · When made → *Made to order* · What is it → *A finished
product* · Type → *Physical* · Processing time → *3–7 business days* · Materials → *PLA, PETG,
carbon-fiber PETG*. For custom quotes, have buyers **Message** first, then create a private
custom listing at the agreed price.

**Title** (≤140 chars):

```
Custom 3D Printed Replacement Part From Your Photo, Discontinued Knob Clip Gear Bracket, Reverse-Engineered Obsolete Plastic Part
```

**Tags** (13):

```
replacement part, 3d printed part, discontinued part, obsolete part, custom 3d print, replacement knob, reverse engineer, appliance part, broken clip, spare part, made to order, custom part, repair part
```

**Description:**

```
Broken, cracked, or discontinued? Send a photo — I'll make you a new one.

I'm a hardware engineer who reverse-engineers and 3D prints replacement parts you
can't buy anymore: knobs, clips, gears, brackets, housings, bezels, spacers, and
other small plastic parts. If the original was injection-molded plastic and the
maker stopped selling it, I can probably remake it.

HOW IT WORKS
1. Message me a clear photo of the broken part (a ruler or coin beside it helps).
   Add the equipment make/model and old part number if you have them.
2. I reply with a fixed price and a ship date — usually within one business day.
   Quotes are free.
3. You approve, I model and print it. If the first fit isn't right, I revise and
   reprint.

MATERIALS: durable PLA, PETG, or carbon-fiber PETG depending on heat/strength needs.
TURNAROUND: most parts ship 3–7 business days after you approve the quote.
ALREADY HAVE A 3D FILE? I do print-only pricing too — just send the STL.

What I can't do: load-bearing metal, gas/pressure-holding, or food/skin-contact
parts — I'll tell you honestly when printing isn't the right answer.

Ready to start, or not sure if it's doable? Message me a photo and I'll tell you.
```

---

## eBay

**Category:** Specialty Services → Other Specialty Services (or the 3D Printing Services
category if offered). **Format:** Fixed price + *Best Offer*. **Handling time:** 5 business days.

**Item specifics:** Type → *Replacement Part* · Material → *PLA / PETG* · Brand → *Unbranded* ·
Custom Bundle → *Yes* · MPN → *Does Not Apply* · Country/Region of Manufacture → *United States*.

**Title** (≤80 chars):

```
Custom 3D Printed Replacement Part Made to Order From Your Photo, Obsolete Part
```

**Description:** same body as the Etsy description above (eBay accepts the same text).

---

## Selling made-to-order without inventory — how the mechanics work

- **Etsy:** list a base made-to-order product, or take a **custom order** — the buyer messages,
  you agree a price, and you create a private listing for them. Etsy requires the item to be
  made/designed by you; printed parts you produce qualify.
- **eBay:** list a fixed-price base with **Best Offer**, or send a buyer a **custom offer** after
  they message. There's a dedicated 3D-printing/custom-manufacturing services area.
- Both let you set an honest **handling/processing time** since nothing ships from stock.

## Where to also drive demand (free, high-intent)

- Reddit: r/functionalprint, r/fixit, r/3Dprinting, plus hobby subs — answer "can anyone print
  this?" posts (follow each sub's self-promo rules).
- Facebook groups for vintage appliances, specific car/motorcycle models, RVs, boats.
- Print-job marketplaces: Xometry / Protolabs Network, Craftcloud, Treatstock — inbound RFQs.
- Everything points back to `datumlaboratories.com/replacement-parts` for the quote form.
