tallen5431/Temperature_Sensor_V2/docs/COMMUNITY_POSTS.md

# Community posts — Reddit & Facebook groups

Non-spammy ways to seed demand where "the part is discontinued" is a daily pain. The
highest-converting, lowest-risk move is **replying to existing "can someone make/print this?"
threads** — not blasting promos. Read each community's self-promotion rules first (many subs
require a helpful-comment ratio, a specific flair, or a designated day).

Keep prices in sync with the `replacement-parts.html` tiers and the other go-to-market docs
(see "Keep in sync by hand" in `site/README.md`).

## Where to be

- **Reddit:** r/functionalprint, r/fixit, r/3Dprinting, r/appliancerepair, r/Justrolledintotheshop
  (adjacent), brand/vehicle subs, r/vintageaudio, hobby subs.
- **Facebook:** brand/model owner groups (vintage appliances, classic cars, motorcycles, RVs,
  boats), local repair/maker groups, "3D printing requests" groups.

## 1. Reply template — for "can anyone print/make this?" threads (best channel)

```
I do this — I reverse-engineer and 3D print discontinued plastic parts (I'm a
hardware engineer). Share a clear photo with something for scale (a coin or ruler)
and I'll tell you if it's doable and roughly what it'd cost. Simple parts like this
often run $29–60. Happy to take a look — details / quote form:
datumlaboratories.com/replacement-parts
```

Lead with "I can tell you if it's doable," not a hard sell.

## 2. Service-intro post — only where self-promo is allowed

**Title:** `I remake discontinued plastic parts (knobs, clips, gears) — send a photo`

```
Hardware engineer here. If a repair's stuck because a plastic part is discontinued,
I can usually reverse-engineer and 3D print a replacement — knobs, clips, gears,
brackets, housings, bezels. Send a photo (with a coin/ruler for scale) and I'll
reply with a fixed price and a ship date, usually within a day. Simple parts start
around $29, and the first simple one is free so you can judge the quality. Got your
own 3D file? I print those too.

Quote form / examples: datumlaboratories.com/replacement-parts
```

## 3. Facebook-group intro (friendly, community tone)

```
Hi all — I make replacement parts for exactly the kind of discontinued bits that
come up here. I'm a hardware engineer and I reverse-engineer + 3D print obsolete
plastic parts (knobs, clips, brackets, trim). If you've got something you can't
source anymore, drop a photo with a coin for scale and I'll tell you if it's doable
and what it'd cost. Not here to spam — happy to just answer questions.
```

## Rules of the road

- Follow each community's self-promo policy; when unsure, **help first** and mention the service
  only if asked or clearly allowed.
- Lead with usefulness ("here's whether it's doable") over the link.
- Don't paste identical text everywhere — tailor the first line to the community.
- The link always goes to `datumlaboratories.com/replacement-parts` (the quote form).
