tallen5431/Temperature_Sensor_V2/site/og-image.jpg

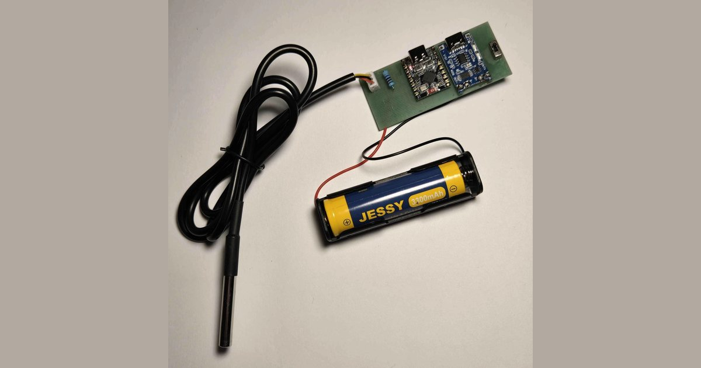
site/og-image.jpg
