tallen5431/Temperature_Sensor_V2/site/product-kit.jpg

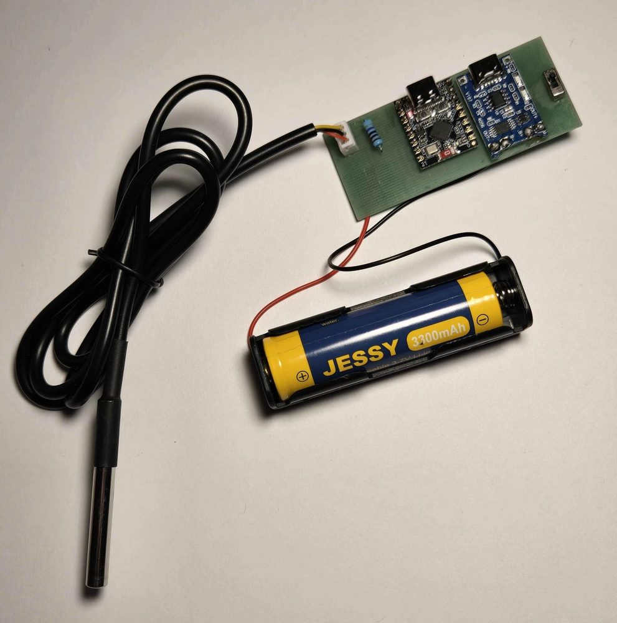
site/product-kit.jpg
