tallen5431/Temperature_Sensor_V2/site/parts/Carabiner-Replica-CAD.jpg

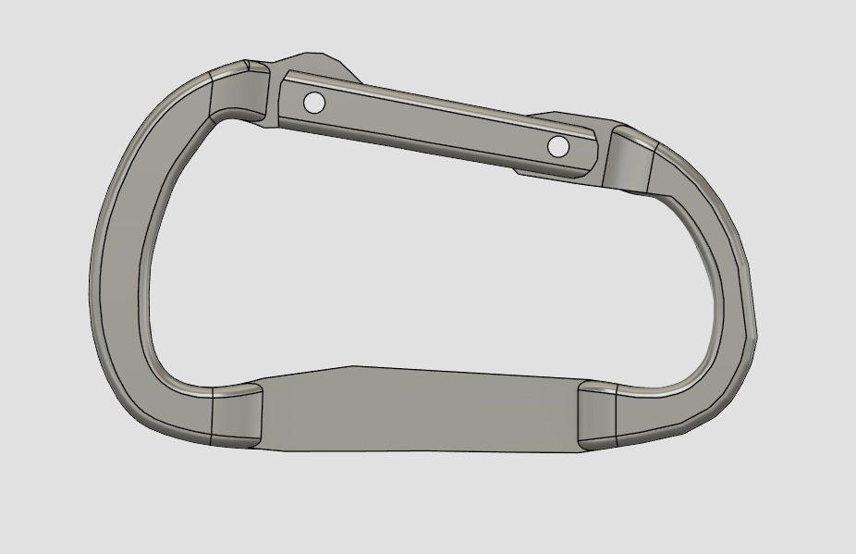
site/parts/Carabiner-Replica-CAD.jpg
