tallen5431/Temperature_Sensor_V2/site/parts/Carabiner-Scan.jpg

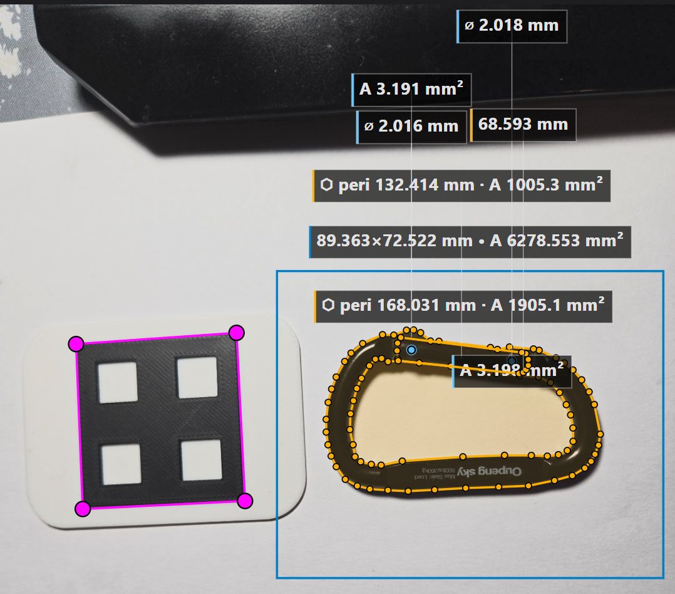
site/parts/Carabiner-Scan.jpg
