tallen5431/Temperature_Sensor_V2/docs/images/assembly/README.md

# Assembly-guide images

These are the photos [ASSEMBLY.md](../../ASSEMBLY.md) embeds. **All committed — the
guide is fully illustrated.** ✅

| File | Step | Shows |
|---|---|---|
| `12-kit-contents.jpg` | intro | Kit-contents flat-lay (USB-C cable not pictured) — also a listing candidate |
| `01-esp32c3-solder.jpg` | 1 | ESP32-C3 header pins soldered (trace side) |
| `02-switch-resistor-probe.jpg` | 2 | Switch + 4.7 kΩ + DS18B20 connector soldered — trace side complete |
| `03-tp4056-solder.jpg` | 3 | TP4056 mounted and soldered on top |
| `04-battery-wires.jpg` | 4 | 18650 holder wires passed through the back |
| `05-complete-module.jpg` | 4 | Completed module — all soldering done, holder wired |
| `06-flash-port-picker.jpg` | 6 | Browser serial-port picker ("USB JTAG/serial debug unit") |
| `07-flash-complete.jpg` | 6 | "Installation complete!" |
| `08-finished-unit.jpg` | 7 | Finished unit: probe + board + 18650 (also a listing hero) |
| `09-wifimanager.jpg` | 8 | WiFiManager page at `192.168.4.1` |
| `10-blue-led-tx.jpg` | 9 | Blue LED flashing on upload |
| `11-dashboard.jpg` | 9 | Live data on the Temperature History dashboard |

> Step 5 ("Verify before you power it" — the multimeter checks) is text-only; the
> `05-complete-module.jpg` shot closes out Step 4 right before it.

Re-crops/replacements: just overwrite the file with the same name and commit.
