tallen5431/Temperature_Sensor_V2/docs/MATERIALS_AND_NEXT_STEPS.md

# Setpoint — Materials, Readiness & What to Consider Next

This is the companion to [docs/ACTION_PLAN.md](ACTION_PLAN.md). The plan says **what to do** and in what order; this page says **what to buy**, **what must be true before money moves or a box ships**, and **what you might be missing**. It does not restate the strategy — for the revenue sequencing, margin math, and FCC gating, go to the plan. Sized for the first batch of **~13 units (10 DIY kits + 3 restaurant loaners)** plus spares, grounded in [BOM.md](BOM.md), [DIY_KIT.md](DIY_KIT.md), [QC_CHECKLIST.md](QC_CHECKLIST.md), [LABEL_TEMPLATE.md](LABEL_TEMPLATE.md), [PILOT_OFFER.md](PILOT_OFFER.md), [REV2_SCHEMATIC.md](REV2_SCHEMATIC.md), [WARRANTY.md](WARRANTY.md), and [STARTUP_CHECKLIST.md](STARTUP_CHECKLIST.md).

> **Heads-up before you order:** [BOM.md](BOM.md) was stale (it named an *ESP32-WROOM-32E DevKitC*) and is **now correct** — item 1 is the **ESP32-C3 SuperMini** (Amazon `B0DFWG87JS`), USB-C native, **4.7 kΩ pull-up on IO5**, **LED active-low on IO8**, firmware target `esp32:esp32:esp32c3`. Trust it. The distinction still matters strategically: a WROOM-32E *is* a pre-certified FCC module, so the old BOM would have contradicted the "rev-1 is a bare chip, can't sell assembled" premise the whole plan rests on — that premise holds because the SuperMini carries a bare `ESP32-C3FH4`.

---

## Do-next, in order

Since this list was written, four of its items are done: the **LLC is filed** (Georgia, 2026-08-03,
certificate pending), **rev-2 is built and bench-verified**, the **warranty and every shipped legal
doc now name Datum Laboratories LLC**, and **BOM.md is corrected to the ESP32-C3 SuperMini**. What is
left, in critical-path order for *this* doc's concerns (buying, gates, repo fixes):

1. ~~**Stand up the `support@datumlaboratories.com` alias.**~~ **DONE 2026-08-03** — added as a Zoho
   Mail alias on the existing mailbox, so the six shipped documents, the label spec and the root
   `LICENSE` all point at a live address. *(Keep it a Zoho alias; Cloudflare Email Routing would seize
   MX and break `thomas.allen@`.)* **Next:** send one test message from an outside address to confirm
   delivery, then set `support@` in Tindie's support field.
2. **Place the slow overseas order today** — DS18B20 probes + TP4056 boards are the 2–4 wk long-lead items. Add a small fast Amazon backup 5-pk of each so a slow shipment never blocks your first build.
3. **Compile the firmware now — no board needed.** Run the full `arduino-cli` install + `arduino-cli compile --fqbn esp32:esp32:esp32c3` on `esp32_temp_probe/`. The FQBN/partition in `factory_flash.py` are documented-not-verified; a clean compile de-risks ~80% of the launch-day "toolchain gate" while boards are still in transit.
4. **Run a free USPTO knockout search** on "Setpoint" (Class 9) and "Datum Labs" before printing brand stock (Consider #3).
5. **Design and freeze the enclosure.** This is now the critical path to assembled sales: the Part 15B SDoC certifies the product *as it ships*, so the case must exist before the lab test ([`PRODUCT_ROADMAP.md`](PRODUCT_ROADMAP.md) Phase 2).
6. **EIN → business bank account** the day the LLC certificate lands, then move the Tindie payout and W-9 onto the LLC/EIN.
7. Then buy the materials below.

---

## Materials & tools to buy now

The **boards are NOT on this list** — the rev-1 carriers + ESP32-C3 SuperMinis are inbound. Confirm the packing slip has **≥15 SuperMinis and ≥15 carriers** (10 kits + 3 loaners + 2 spares); if tight, add spare SuperMinis (`B0DFWG87JS`, ~$3.50 ea). **Check what you already own first** — a solo maker with an R&D background very likely already has an iron, multimeter, cutters, tweezers, IPA, and an always-on PC/Pi.

### 1 · Kit BOM consumables

| Item | Qty | ~Line | Note |
|---|---|---|---|
| DS18B20 waterproof probe (1 m, stainless, 3-wire) | 20 | **$56** | ⚠️ **ORDER FIRST.** #1 return is a dead probe — buy heavy spares; QC every one before bagging. Prefer a reputable distributor (see Consider #9) |
| TP4056 charge/protect board (USB-C, **protected** variant) | 15 | **$15** | ⚠️ **ORDER FIRST.** Kits only — loaners run USB-always-on, no battery |
| Resistor assortment (incl 4.7 kΩ, 330 Ω, 100 Ω, 1/4 W) | 1 box | **$12** | Covers the mandatory 4.7 kΩ IO5 pull-up, LED 330 Ω, and 100 Ω DQ series R for pilots |
| Slide switches (SPDT, 2.54 mm) | 20-pk | **$7** | Kits' on/off; loaners omit |
| 18650 holder (or JST-PH LiPo pigtail) | 15 | **$11** | Ships in the kit; **cell NOT included** (lithium shipping rules) |
| Screw terminals (3-pin, 3.5 mm) | 25-pk | **$8** | Plug-Together tier + loaners (no-iron probe hookup) |
| Female headers (2.54 mm, snap-apart) | 10 strips | **$7** | Plug-Together: pre-soldered so buyer just seats the module |
| Male pin headers (2.54 mm) | 10 strips | **$6** | Maker tier + test rig |
| JST-PH connector kit | 1 kit | **$9** | Only if you offer the LiPo variant |
| 22 AWG hookup wire (solid, 6 colors) | 1 set | **$14** | Probe leads / internal jumps |
| Heatshrink assortment | 1 pk | **$9** | Strain-relief + a premium-feel touch per bag |
| | | **≈ $154** | |

### 2 · Flashing + bench

| Item | Qty | ~Line | Note |
|---|---|---|---|
| USB-C **data** cables (not charge-only) | 5 | **$18** | SuperMini flashes over native USB-C; a charge-only cable is a classic "won't flash" time-sink — test each |
| USB-UART adapter (CP2102/CH340, 3.3/5 V) | 3 | **$24** | Not needed for C3 kits, but required for the rev-2 UART header — buy now |
| Powered USB hub (7-port, per-port power, ≥60 W) | 1 | **$35** | Flash several boards without brownout |
| 2.4 GHz test AP / travel router | 1 | **$30** | QC needs a 2.4 GHz-only SSID (GL.iNet Mango/Beryl) |
| Bench hub (Raspberry Pi 5 8 GB) | 1 | **$110** | Runs the dashboard on `:8088`. **Skip if you already have an always-on PC/Pi** |
| Breadboard + Dupont jumper set | 1 | **$12** | Test rig / probe bring-up |
| Protected 18650 cells + charger (bench only) | 2–4 + 1 | **$22** | Observe deep-sleep wake at QC; cells never ship in kits |
| | | **≈ $251** (**$141** if you already have a Pi/PC) | |

### 3 · Assembly tools — buy only the gaps

| Item | ~Cost | Note |
|---|---|---|
| Temp-controlled soldering station | $40–110 | **Likely own.** Pinecil V2 (~$40) plenty for headers |
| Solder (63/37 rosin, 0.7 mm) | $12 | Leaded flows easiest for hand headers |
| No-clean flux pen/paste | $8 | |
| Helping hands / PCB vise + magnifier | $18 | Real time-saver for batch header soldering |
| ESD wrist strap + mat | $18 | C3 is ESD-sensitive — cheap insurance against mystery dead boards |
| Flush cutters | $10 | **Likely own** (Hakko CHP-170) |
| Multimeter (continuity + DC V) | $25 | **Likely own** — verify 3V3 rail + pull-up continuity |
| ESD fine-tip tweezers | $8 | **May own** |
| Headband magnifier / USB microscope | $25 | Solder-joint inspection at QC |
| IPA + brush + wick + sucker | $14 | **May own** — flux cleanup + rework |
| | **$178 buy-all / ~$85 incremental** | |

### 4 · Packaging + shipping

| Item | Qty | ~Line | Note |
|---|---|---|---|
| Anti-static bags (3×5 / 4×6) | 100-pk | **$11** | Board + SuperMini; premium touch |
| Small parts zip baggies (assorted) | 200+ | **$10** | Labeled baggies = perceived value at $39 |
| Kit boxes / bubble mailers (~4×6×2) | 25–50 | **$22** | |
| Thermal shipping label printer (4×6) | 1 | **$130** | One-time; serves every future batch (Rollo/Munbyn) |
| 4×6 thermal labels | 500–1000 | **$18** | Direct-thermal, no ink |
| Unit label stock (50×25 mm) | 1 roll/pk | **$15** | The `Setpoint-XXXXXX` + QR label; laser Avery sheets work if you skip a 2nd printer |
| Kraft paper / void fill | 1 roll | **$15** | |
| Digital shipping scale (~50 lb) | 1 | **$20** | Accurate postage |
| Brand/"Fragile" stickers (Setpoint by Datum Labs) | 1 run | **$30** | Doubles as the kit sticker nice-touch |
| | | **≈ $271** | |

### 5 · Restaurant pilot loaner gear

Loaners are the **hardened walk-in build**: mains USB power (no battery), DQ line protection, sealed box mounted *outside* the cold zone with only the stainless tip inside.

| Item | Qty | ~Line | Note |
|---|---|---|---|
| Sealed IP-rated box + PG7 cable gland | 5 | **$35** | Strain-relief the probe lead at the gland — the #1 field failure |
| 5 V USB mains adapter + USB-C cable | 5 | **$35** | Loaners run USB-always-on (battery dropped) |
| TVS/ESD diode for DQ (SMAJ5.0A or PESD) | 20-pk | **$8** | DQ→GND at the connector; 100 Ω series R comes from the cat-1 assortment |
| Mounting kit (neodymium magnets + 3M VHB + zip ties) | assorted | **$20** | Box mounts outside, probe routed through the door seal |
| **Mini-PC hub** ($150–250 class, N100) | 2 | **$360** | **Resale inventory, not sunk** — sell at $129–149 install fee (your cost $80–120). Buy 2 for 2–3 pilots |
| Food-safe glycol / buffer + vials | 1 | **$14** | Damp the tip so a 6-min defrost spike doesn't false-alarm |
| Small UPS (hub + router backup) — *optional* | 1 | **$55** | Offered in PILOT_OFFER; optional |
| | | **≈ $527** (**$472** w/o UPS; **$360 recoverable**) | |

### 6 · Photography — the #1 Tindie blocker

DIY_KIT: *"Photos win Tindie."* Cheapest lever with the biggest conversion impact (see Consider #13).

| Item | ~Cost | Note |
|---|---|---|
| Foldable LED lightbox/softbox (~16") | $45 | Flat-lay, hero unit, probe-in-fridge |
| Plain white + grey backdrop | $15 | Clean, honest product shots |
| Phone tripod + BT remote | $18 | Sharp, repeatable framing |
| | **≈ $78** | |

### Rough total to be "build-ready" (10 kits + 3 loaners)

| Category | Buy-all | Realistic (own core tools/PC) |
|---|---|---|
| 1 · Kit consumables | $154 | $154 |
| 2 · Flashing + bench | $251 | $141 *(use your PC, skip Pi)* |
| 3 · Assembly tools | $178 | $85 *(own iron/meter/cutters)* |
| 4 · Packaging + shipping | $271 | $271 |
| 5 · Pilot loaner gear | $527 | $472 *(skip UPS)* |
| 6 · Photography | $78 | $78 |
| **TOTAL** | **≈ $1,459** | **≈ $1,201** |

**How to read the number:** ~$360 is **resale inventory** (2 mini-PCs), recovered on the first paid install. ~$450–500 is **one-time equipment** (label printer, test router, lightbox, iron) that serves every future batch. True per-batch consumable cost is only **~$150–200** — batch two onward is cheap. Net "sunk" to be build-ready is **~$850–1,100**, comfortably inside week-one pre-order/pilot-deposit revenue.

---

## Readiness gates — before you take money / before you ship

> **Not legal, tax, or financial advice** (full one-liner at the bottom). Ordered as a gate ladder — do not skip a gate to move faster; each is cheap and load-bearing. Kits and loaner pilots need **no FCC gate** (see the plan's [legal/FCC gate table](ACTION_PLAN.md#legal--fcc-gate-table)); this is everything *else* that gates money and shipping.

| Gate | Must be true before you… | Blocking items |
|---|---|---|
| **0 — Legal shell** | …collect money into the business | LLC filed · EIN · business bank · processor paying out to that bank |
| **1 — Honest checkout** | …publish a pre-order / deposit link | FTC ship window + refund terms on the page · Returns/Warranty linked · home-state sales tax decided |
| **2 — Box readiness** | …ship a paid kit | Warranty (cap intact) + Returns in every box · serial log started · QC gate validated · handling time posted · packing slip + replacement path ready |
| **3 — Kitchen readiness** | …put hardware in a commercial kitchen | **Product-liability insurance BOUND** · W-9 + COI ready · loaner-not-sale framing · written liability limits handed over |

### Gate 0 — Legal shell (no money into the business before this)

- [x] Form the **Datum Laboratories LLC** — liability shield *and* future FCC responsible party. Georgia
      Articles of Organization filed **2026-08-03**, $100, awaiting the certificate. **Next:** free EIN at
      IRS.gov the day it lands, then the business bank account.
- [ ] Get the **EIN free at IRS.gov** — never pay a third party. Needed before the bank account and processor.
- [ ] Open a **business bank account**; run every dollar through it (mixing funds pierces the shield).
- [ ] Create the **Stripe/Gumroad account** under the LLC + EIN, payouts pointed at the business bank. (You can *collect* into a Stripe balance sooner, but can't withdraw without the bank account.)

### Gate 1 — Honest checkout (pre-order / deposit)

**Lead with a refundable deposit, not full pre-pay** — boards are inbound and the toolchain is documented-not-verified, so a deposit de-risks both sides and keeps you FTC-clean if the build slips. It also lowers **processor-freeze risk** (see Consider #6).

| Model | Price | Use | FTC exposure |
|---|---|---|---|
| **Refundable deposit** ⭐ | $10–25 | Founding batch, before QC is validated | Lower; refund any time before ship |
| Full pre-pay | $39 | Only for buyers happy to wait the honest window | Full FTC 30-day obligation attaches |

- [ ] **Stripe Payment Link:** honest name (`Setpoint Maker Kit — Founding Batch (pre-order, ships ~4 weeks)`), deposit $10–25, **cap payments at 25**, collect email + shipping address, custom field "how many probes (1/2/4)", quantity capped so one buyer can't clear the batch.
- [ ] **Description + thank-you page restate:** the ~4-week window, "deposit fully refundable until your kit ships; if we can't ship in the window we'll notify you and you can cancel for a full refund," and what it is/isn't (kit you assemble · cell not included · ±0.5 °C typical from −10 to +85 °C, ±2 °C outside that band, uncalibrated · 2.4 GHz Wi-Fi only · needs an always-on PC · loss-prevention aid, **NOT** a certified/NIST/HACCP instrument · monitoring stops in a power outage).
- [ ] **FTC Mail-Order Rule:** state an honest window (or the law defaults to 30 days); if you'll miss it, **notify + offer cancel for full refund**; refund promptly to the original method. *(Verify the exact refund wording with a small-business attorney before publishing.)*
- [ ] **Who you are:** Datum Laboratories LLC + `support@datumlaboratories.com`; link the **real** Returns and Warranty (both now carry the entity and address).
- [ ] **Sales tax:** enable Stripe Tax for your home state or track manually. **Tindie remits for you; direct Stripe/Gumroad/in-person sales are yours** — you likely owe only your home state to start.
- [ ] **Landing/waitlist page** separate from the Tindie listing: "Reserve a kit" → deposit link, plus a plain email-capture for the not-ready. **Log every reservation** (email + probe count + deposit y/n) into a CSV.

### Gate 2 — Box readiness (before any paid kit ships)

- [x] **Edit [WARRANTY.md](WARRANTY.md) and [RETURNS.md](RETURNS.md):** ~~insert **Datum Laboratories LLC + address**, swap `https://example.com/support` for the real URL~~ **DONE** — both now name the entity, the Kennesaw address and `support@datumlaboratories.com`. **Still confirm before shipping:** the **liability cap is intact** (total liability limited to hardware price, excludes consequential/spoiled-inventory damages, "monitoring aid, not a certified/HACCP/life-safety device"), and confirm the 30-day return window + who-pays-return-shipping. Ship both in **every kit and every pilot**.
- [ ] **Start the batch serial-log CSV** with the exact [LABEL_TEMPLATE.md](LABEL_TEMPLATE.md) header: `serial,build_date,operator,mac,probe_id,ap_ssid,fw_version,test_wifi_ssid,temperature_c,ingest_ok,qc_result,notes`. One row per unit; `probe_id` unique in the file (a collision = duplicate ROM → quarantine both). **Keep it in a synced/versioned folder** (see Consider #5).
- [ ] **Validate the QC gate:** flash + full [QC_CHECKLIST.md](QC_CHECKLIST.md) on **one** board end-to-end, and flash a **second** from the browser page, **before** unlocking batch mode. Then every unit runs the gate; **any FAIL stops the unit** (note the failing step, fix, re-run).
- [ ] **Test every DS18B20 before bagging** — flash with that kit's probe connected; a dead probe reads **−127 / 85.0 / NaN**. Bag the tested probe **with its board** as a matched set.
- [ ] **Post an honest 3–5 business day handling time** on Tindie and direct checkout.
- [ ] **Packing slip per box:** order # · buyer · probe_id(s) in the box · what's included · "cell not included — use any protected 18650" · real support URL · quick-start card (`docs/kit-quickstart-card.html`) + the edited Warranty & Returns.
- [ ] **Replacement path:** DOA/defective within 30 days → you cover return shipping (prepaid label) + refund/replace, **return authorization first**; after 30 days → the 1-year limited warranty; require proof of purchase + probe_id (maps to the serial-log row).

### Gate 3 — Kitchen readiness (before hardware enters a commercial kitchen)

- [ ] **BIND product-liability insurance** (CGL **$1M/occ, $2M agg, with products-completed-operations**, ~$400–1,200/yr) — a free loaner still puts your device in a food business. Pull 2–3 broker quotes now so you have the number + a COI template.
- [ ] **W-9 ready** (LLC name + EIN) — procurement asks before B2B payment.
- [ ] **Frame the pilot as a loaner/evaluation, not a sale** ([PILOT_OFFER.md](PILOT_OFFER.md) — fill the `[BRACKETED]` fields); hand over the written liability limits.

---

## Things to consider (gaps & risks)

The strategy docs are strong on FCC sequencing, margin, and the loaner motion. These are the things that will actually bite — cheap papercuts that compound, plus a few genuine repo contradictions that would cause a wrong parts order or an indefensible claim. Ranked by "bites soonest."

**Tier 1 — bites this week / before the first box**

1. **~~BOM + firmware targeted the wrong board~~ — FIXED.** The firmware now auto-selects the
   **ESP32-C3 SuperMini** pin map when built for the C3 (status LED **GPIO8, active-low**, kept
   boot-safe; WROOM GPIO2/active-high fallback retained), and [BOM.md](BOM.md) + [VERSIONS.md](VERSIONS.md)
   match. The `#if` branch, pin value, and active-low drive levels were verified for both targets.
   → **Remaining action:** just do one **end-to-end flash of a real board** (FQBN `esp32:esp32:esp32c3`)
   as your launch-day toolchain gate and confirm the on-board LED blinks.
2. **~~Every shipped legal doc still points at `example.com/support`~~ — FIXED.** `datumlaboratories.com`
   is live, the LLC is filed, and WARRANTY, RETURNS, SUPPORT, PRIVACY, SECURITY and the EULA now carry
   **Datum Laboratories LLC**, the Kennesaw address and `support@datumlaboratories.com`.
   `support@datumlaboratories.com` was added as a **Zoho Mail alias** on 2026-08-03, so the address
   resolves. *(Keep it a Zoho alias — Cloudflare Email Routing would seize the domain's MX and break
   `thomas.allen@`.)* → **Remaining action:** set it in **Tindie's support field**, which was left
   pointing at the Ask-a-Question flow while the alias did not exist.
3. **No trademark clearance on "Setpoint"** — a dictionary word almost certainly crowded in USPTO Class 9 (measuring/monitoring instruments). → **First action:** run a free USPTO knockout search on "Setpoint" (Class 9) + "Datum Labs" this week; if crowded, rename before printing brand stock.
4. **The launch is gated on a toolchain never even compiled — and compiling needs no board.** The FQBN/partition are documented-not-verified. → **First action:** run `arduino-cli compile --fqbn esp32:esp32:esp32c3` on `esp32_temp_probe/` today; only the upload step then needs hardware.
5. **The batch serial-log CSV — your entire traceability/warranty spine — is a single unbacked file.** → **First action:** keep it in a git/cloud-synced folder and save after every build session.
6. **A new processor can freeze funds on pre-orders for undelivered hardware.** "$490 frozen 90–180 days" right when you need it for parts. → **First action:** default to small refundable deposits ($10–25) and email Stripe a one-line heads-up describing the pre-order model.

**Tier 2 — bites during the first pilots / first month**

7. **~~PILOT_OFFER omitted the internet-outage caveat~~ — DONE.** Added to [PILOT_OFFER.md](PILOT_OFFER.md):
   remote text/email/Slack alerts ride the building's internet and pause on a WAN drop (the on-screen
   alarm still shows); keep the alert phone on cellular.
8. **~~No per-unit verification SOP for "±0.5 °C, verified"~~ — DONE.** [QC_CHECKLIST.md](QC_CHECKLIST.md)
   now has **step 5.3**: an ice-water slush dip that must read 0 °C ± 0.5 °C, recorded as `ice_c`. Only a
   unit that passes may be advertised "verified at 0 °C to within ±0.5 °C." → **Remaining:** add the
   `ice_c` column to the serial-log header in [LABEL_TEMPLATE.md](LABEL_TEMPLATE.md).
9. **Counterfeit/clone DS18B20s threaten both the accuracy claim and the identity scheme** (fakes are out-of-spec and sometimes share/fake ROM codes, which your `probe_id` derives from). → **First action:** source the first/"verified" batch from Adafruit/DigiKey/Mouser, not the cheapest marketplace listing; the ice-bath step becomes your incoming clone screen.
10. **~~Loaner-hub reliability had no runbook~~ — DONE.** [HUB_RELIABILITY.md](HUB_RELIABILITY.md) is the
    one-page uptime SOP: auto-start per OS (Windows service via NSSM / systemd / launchd / Docker
    `restart: unless-stopped`), firewall + DHCP reservation, weekly export, and a **prove-it** step
    (reboot the PC, confirm it comes back unattended and the offline alert fires) before you leave.
11. **The "inconsistent power stories" are now formalized as two versions** — **Portable** (battery,
    deep-sleep) and **Fixed** (USB, always-on), defined in [VERSIONS.md](VERSIONS.md) (same board + probe
    + firmware; only power + reporting interval differ). → **Remaining action:** add the reachability caveat to
    SUPPORT and QC — *"a Portable (deep-sleep) probe answers its local URL only for a few seconds at each
    wake; tap reset to wake it on demand. A Fixed (USB) probe answers continuously."*

**Tier 3 — erodes focus, margin, and credibility over weeks**

12. **No time budget for a solo founder**, and the separate solar side-project is an unmodeled focus risk — the "this week" list is really a quarter. → **First action:** commit this week to only the revenue-critical chain (parts ordered → toolchain compiled → first pilot booked); park rev-2 KiCad and the solar project on a "not until first dollar" list.
13. **Photography is the #1 Tindie blocker with no plan** — bad phone-on-a-desk photos are why good listings underperform. → **First action:** buy a $15–25 pop-up lightbox (cat 6) and shoot on a phone in daylight. *(The "setup Wi-Fi name & password" listing bug is now fixed — both listings say **open** setup Wi-Fi, no password.)*
14. **~~No reorder point or true-COGS discipline~~ — DONE.** [DIY_KIT.md](DIY_KIT.md) ops now sets a
    reorder trigger (~5 kits of stock, with a fast Amazon backup) and a true-per-kit-cost line
    (packaging + label + card + fees + returns allowance on top of parts).
15. **~~Security posture unaddressed for on-prem B2B~~ — DONE (noted).** [GO_TO_MARKET.md](GO_TO_MARKET.md)
    §6 risks now states the LAN-trust model honestly (open setup AP + unauthenticated LAN provision) and
    puts a **per-unit provision secret / setup-AP password** on the near-term firmware roadmap. Building
    that firmware option remains a future feature, not a doc fix.
16. **~~Review-seeding under-planned~~ — DONE.** [DIY_KIT.md](DIY_KIT.md) adds a "leave a review" card
    (QR to the review page) to the kit contents, with a note to ask your first 3–5 warm buyers first.
    Competitor moat framing (can't-be-bricked / on-prem, not price) is already in GO_TO_MARKET positioning.

> **Cross-cutting:** #1, #7, and #11 are the same disease — doc-drift across partly-inconsistent product definitions. Designate **one** source-of-truth doc (BOM.md, once corrected to the C3) and reconcile DIY_KIT, TINDIE_LISTING, SUPPORT, and PILOT_OFFER to it in one pass, before anything is printed or shipped.

---

## Not legal/tax/insurance advice

This is a practitioner's checklist, not legal, tax, financial, or insurance advice — confirm the FTC refund wording, insurance timing, trademark, and sales-tax specifics with a small-business attorney, an accountant, and an insurance broker before you go live.
