tallen5431/Temperature_Sensor_V2/site/parts/Carabiner_3D_Print_Comparison.jpg

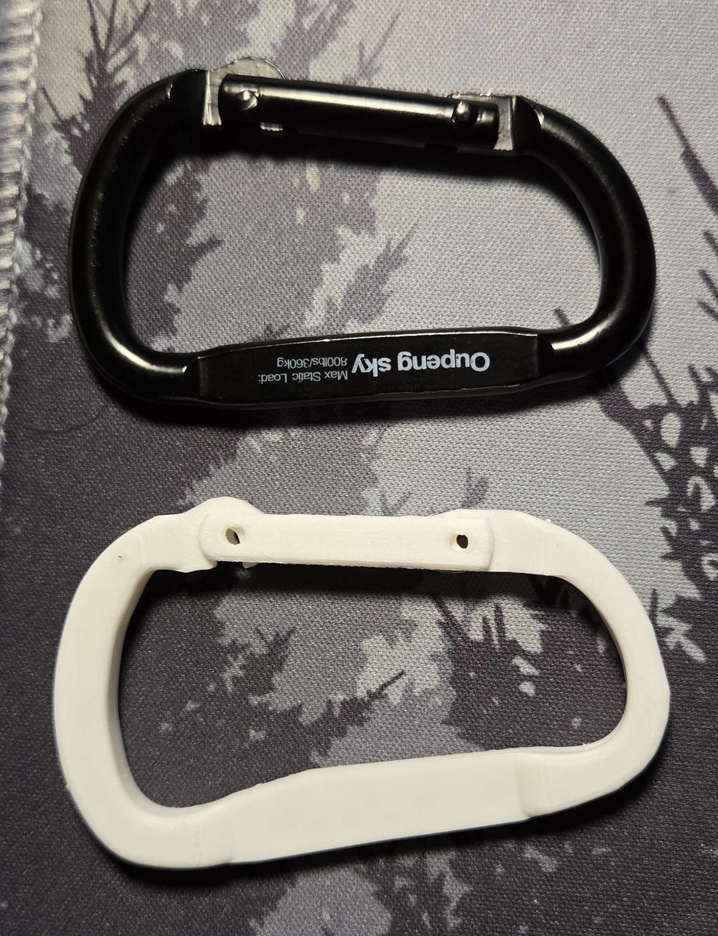
site/parts/Carabiner_3D_Print_Comparison.jpg
