tallen5431/Temperature_Sensor_V2/esp32_temp_probe/esp32_temp_probe.ino

// ESP32 + DS18B20 + WiFiManager + mDNS + OTA + WebServer
// v2.9.5 — JSON buffer sizing, MEASURED this time rather than reasoned about.
//           Compiling the real documents against ArduinoJson 6.21.6 showed
//           /whoami needed 349 B against its declared 320 with the 128-char
//           server_url the captive portal accepts — so it was silently DROPPING
//           members, and /whoami is what the QC checklist has the factory read
//           fw_version from before a unit ships. Raised to 512.
//           applyHubConfig parsed into 320 B while its caller admits replies up
//           to 512; today's five-field config needs 184 B, but an eight-field
//           one would need 327 and be rejected as NoMemory, silently, since the
//           caller discards the bool. Raised to 512.
//           The 2.9.4 sizes for /provision (512) and /status (640) are
//           confirmed adequate: 385 B and 474 B at the same worst case. The
//           comments that justified them cited hand arithmetic that was wrong
//           in both directions, and now cite the measurement.
//           ArduinoJson is pinned to 6.x in CI and in firmware/README: under v7
//           StaticJsonDocument ignores its size parameter, so a v7 build hides
//           exactly the mistakes a v6 build ships.
// v2.9.4 — four fixes, all of them silent.
//           POST /provision parsed four fields and DROPPED the three
//           threshold-watch ones PROTOCOL.md §4.1 requires it to persist, so
//           the hub's push path reported the watch as delivered and only the
//           pull path (the /api/ingest reply) ever armed it. Its parse buffer
//           was also 256 bytes against a ~260-byte body, so under ArduinoJson
//           v6 the whole push could come back "bad json" and the probe would
//           not be provisioned at all. 512 now, and the watch fields are
//           honoured with applyHubConfig's explicit-null-clears semantics.
//           The captive portal shrank its own fields: setValue(v, length)
//           takes the BUFFER size, and three call sites passed the current
//           VALUE's length — so on an unprovisioned probe the Server URL input
//           rendered maxlength="0" and silently discarded whatever the
//           customer typed, on the one screen every customer passes through.
//           Two exits from loop() ignored the threshold watch and slept a full
//           reporting interval: the DS18B20 fault path and the wake after a
//           disturbance burst. On a 15-minute probe that is a quarter of an
//           hour of not watching a freezer, straight after the two events most
//           likely to matter. Both now share one nextSleepMs().
//           And /status could silently omit members — ArduinoJson v6 drops
//           them rather than erroring — once server_url passed 38 characters.
// v2.9.3 — the Wi-Fi setup portal's "Read interval (ms)" field is now
//           "Reporting interval (ms)". It sets cfg_interval, which is how often
//           the probe TRANSMITS; with the threshold watch armed it reads far
//           more often than that. This is the one screen every customer passes
//           through, and it disagreed with the dashboard field it mirrors.
//           Behaviour is unchanged — the bump exists because the flasher
//           rebuilds this source on every push and copies manifest.json
//           verbatim, so leaving the version still would have let 2.9.2 name
//           two different binaries.
// v2.9.2 — deep-sleep clock: the pre-sleep instant is now checkpointed LAST,
//           immediately before the wake timer is armed. It was taken at the top
//           of enterDeepSleep(), so the Serial flush, HTTP/mDNS teardown,
//           WiFi.disconnect() and its 20 ms settle all elapsed after the
//           recorded instant and before the timer started — time the wake-side
//           reconstruction never added back. The clock ran slow by that
//           shutdown tail on every wake, in one direction, so it accumulated.
//           An NTP resync bounds it while the probe is ONLINE; a resync needs a
//           connected wake, so through a router or hub outage — exactly when
//           readings are being buffered and their stamps are the only record of
//           when they were taken — it free-ran. A second uncounted interval
//           remains (the bootloader runs before millis() starts) and is
//           documented at the restore site: measuring it needs the RTC tick
//           counter and belongs on a bench with a reference clock.
// v2.9.1 — threshold-watch sleep: a report is no longer delayed by a short
//           remainder. The sleep clamps the sample gap to whatever is left
//           before the next report, then a guard meant for "the report just
//           fired" (untilReport == 0) tested `gap < WATCH_SAMPLE_MIN_MS`
//           instead — which also fired for any remainder of 1..4999 ms and
//           undid the clamp immediately above it. The probe then slept a whole
//           cfg_sample_ms rather than the short remainder, landing the report
//           up to one sample gap late (60 s on a 60 s sample cadence), on every
//           cycle where cfg_interval %% cfg_sample_ms fell in that band. The
//           sleep arithmetic now has host-side coverage alongside the watch
//           predicates (tests/firmware/watch_logic_test.cpp) -- it decides both
//           battery life and report punctuality and had none.
// v2.9.0 — threshold watch: sample often, transmit rarely. Reading the sensor
//           costs a conversion; associating and POSTing costs seconds of radio,
//           so the two are now decoupled. Given limits by the hub (from
//           alert_thresholds, over the existing provision + ingest-reply
//           channel) plus a sample cadence shorter than the report interval, a
//           deep-sleeping probe wakes every cfg_sample_ms with the RADIO OFF,
//           reads, and buffers — powering the radio only when the report is due
//           or the reading just crossed a limit. A probe reporting every 15
//           minutes therefore notices a thawing freezer within a minute instead
//           of up to fifteen, and because every sample is buffered and flushed
//           on the next report the hub gets the finer history at no extra radio
//           cost. Only the TRANSITIONS transmit early (in and out of the
//           excursion); sitting in breach reports on the normal interval, and
//           WATCH_HYSTERESIS_C stops a probe parked on its limit chattering.
//           This is what the v2.5.0 disturbance burst could not do: that fires
//           on a sudden CHANGE, and a slow thaw has none — and above
//           BURST_MAX_INTERVAL_MS it is off entirely, which is exactly the long
//           interval where a silent excursion costs most. OFF unless the hub
//           sends limits AND a shorter sample cadence, so a probe told nothing
//           behaves exactly as it did in 2.8.2. State reported in /status
//           (watch_armed, alert_min_c, alert_max_c, sample_ms, in_breach) so the
//           probe's copy of the limits can be checked against the hub's.
// v2.8.2 — offline buffering no longer requires a synced clock. A probe whose
//           NTP has never landed (a LAN with no internet — the local-first
//           deployment this product is sold for) previously DROPPED every
//           reading it could not stamp, so the offline buffer never engaged and
//           the data was lost outright. Such readings are now buffered with an
//           empty stamp and receipt-stamped by the hub on drain: the values
//           survive, though that backlog carries drain-time chronology rather
//           than measurement-time. A probe that HAS a clock is unaffected (the
//           RTC checkpoint keeps stamping through an outage as before).
// v2.8.1 — reliability + bulk drain: (a) the offline buffer now drains to the
//           hub in bulk via POST /api/ingest_csv — one HTTP round-trip per
//           ~FLUSH_CHUNK_ROWS readings instead of one per reading — so a
//           several-hundred-KB cold-soak backlog uploads in seconds and the
//           radio spends far less time on. Falls back transparently to the
//           per-reading path on an older hub (404/405) or a non-standard server
//           URL. The hub dedupes by (probe_id, timestamp), so a re-sent chunk
//           (dropped ACK) is ignored — for STAMPED lines. Unstamped ones, which
//           2.8.2 later introduced, are receipt-stamped by the hub and therefore
//           duplicate on replay; see bufferFlush(). (b) cold-boot rejoin —
//           a probe with saved credentials retries its network for a 60 s grace
//           and then continues OFFLINE instead of flipping to its own setup AP
//           on a brief miss (the recharge-hosts-an-AP bug); after
//           COLD_FAIL_PORTAL_AFTER consecutive failed cold boots (a permanent
//           network change, not a passing outage) it opens the setup portal once
//           so the probe can be re-pointed without a USB re-flash.
// v2.7.0 — reliability: (a) power-outage lockout fix — the captive portal now
//           times out after PORTAL_TIMEOUT_S (180 s) instead of blocking
//           forever, so a probe whose router reboots slower than it does after
//           an outage continues into normal operation OFFLINE on its saved
//           credentials (readings buffered, Wi-Fi retried periodically / next
//           wake); a probe with NO saved credentials re-opens the portal in a
//           loop instead of hard-blocking. (b) buffer-flush hardening — the
//           buf_pos checkpoint is zeroed BEFORE the buffer file is deleted
//           (a crash between the two used to leave a stale offset that
//           silently skipped the start of the NEXT buffer file), and a
//           checkpoint beyond EOF is treated as corrupt: flush restarts from 0
//           instead of deleting unsent data. (c) /provision recomputes the
//           deep-sleep/always-on mode live, so an always-on probe provisioned
//           to a >=10 s interval starts deep-sleeping without a power cycle.
//           (d) a disturbance burst is followed by a FULL cfg_interval sleep,
//           not the collapsed 100 ms floor. (e) non-blocking NTP — configTime()
//           starts async SNTP; only a cold boot waits (bounded, <=3 s) and
//           loop() polls validity with a 60 s -> 5 min backoff, so a LAN
//           without internet NTP no longer freezes the loop 8 s per attempt.
//           (f) clock-drift fix — the pre-sleep instant is checkpointed to
//           MILLISECOND precision and restored ms-exact on wake (before the
//           Wi-Fi block), and the drift resync is driven by a wakes-since-
//           successful-sync counter instead of bootCount % 30. (g) flush
//           budget — buf_pos checkpoints every 10 uploaded lines (and always
//           on stop/completion), and a deep-sleep wake caps its flush at
//           ~20 s, resuming the backlog next wake.
// v2.6.0 — provisionable sensor resolution: the DS18B20 resolution (9..12 bit,
//           0.5..0.0625 °C) is now set per-probe from the hub's Devices page,
//           delivered via /provision, persisted to NVS, and applied live. The
//           conversion-wait tracks the resolution automatically (see g_convMs /
//           applyResolution). Reported in /whoami and /status as resolution_bits.
// v2.5.1 — battery: (a) per-wake Wi-Fi reconnect budget cut 15 s -> 8 s with a
//           backoff — after repeated failures a probe that can't associate (deep
//           in a freezer, hub down) only attempts a connect every Nth wake, radio
//           off on the others, instead of burning 15 s every wake; (b) the 3 s
//           HTTP provisioning window is served on the first few wakes and then
//           periodically, not on every wake; (c) the disturbance burst is capped
//           at BURST_MAX_CONSECUTIVE back-to-back fires so a repeatedly-opened
//           door can't hold the probe awake and flatten the battery.
// v2.5.0 — (a) millisecond timestamps: readings are stamped to ms precision so a
//           high-rate cadence (e.g. 0.5 s while a freezer door is open) stays
//           distinguishable instead of collapsing onto one whole-second stamp.
//           (b) disturbance burst: in deep-sleep mode a wake reading that jumps
//           more than BURST_DELTA_C from the previous one (a freezer door
//           opening, a compressor kick) makes the probe stay awake, keep Wi-Fi
//           up, sample fast and flush the offline buffer hard for a short window
//           before sleeping again — so a brief event and the connectivity window
//           it opens aren't slept through. (True wake-on-temperature would need
//           an analog sensor + comparator on a wake pin — a hardware revision.)
// v1.6.0 — stable probe identity: the probe id is derived once (DS18B20 ROM,
//           with retry, else the chip id) and persisted to NVS, so a later
//           failed sensor read can no longer flip the identity and make the hub
//           list a single probe as two devices.
// v1.5.0 — battery sleep: when the read interval is >= DEEP_SLEEP_MIN_MS
//           (default 10 s) the device enters deep sleep between readings,
//           cutting idle current from ~100 mA to <1 mA.  For shorter
//           intervals WiFi modem sleep is used instead, keeping the web
//           server fully responsive.
//
// Requires (Library Manager):
//   - WiFiManager by tzapu
//   - ArduinoJson  (v6 or v7)
//   - DallasTemperature + OneWire
//   - LittleFS (bundled with ESP32 Arduino core ≥ 2.0)
//
// Partition scheme (Arduino IDE → Tools → Partition Scheme):
//   Recommended: "No OTA (2MB APP/2MB SPIFFS)"
//   2 MB LittleFS → ~38 000 readings (~26 h at 2 s, ~65 h at 5 s).

#include <WiFi.h>
#include <HTTPClient.h>
#include <WiFiManager.h>
#include <WebServer.h>
#include <ArduinoJson.h>
#include <Preferences.h>
#include <ESPmDNS.h>
#include <OneWire.h>
#include <DallasTemperature.h>
#include <LittleFS.h>
#include <time.h>
#include <esp_sntp.h>
#include <esp_sleep.h>

// ---------------- Pins & LED ------------------------------------------------
#define ONE_WIRE_BUS 5

// Status LED — auto-selected by build target so one firmware image fits both boards:
//   * ESP32-C3 SuperMini (the rev-1 board): onboard LED on GPIO8, wired ACTIVE-LOW
//     (drive LOW = lit). GPIO8 is also a boot strapping pin and must be HIGH at reset;
//     the SuperMini's onboard pull-up holds it high at boot, and ledInit() drives it
//     HIGH (LED off) once the app is running, so using it as the status LED is boot-safe.
//   * ESP32-WROOM-32/-32E (fallback): onboard LED on GPIO2, ACTIVE-HIGH.
#if defined(CONFIG_IDF_TARGET_ESP32C3)
  #ifndef PIN_STATUS_LED
    #define PIN_STATUS_LED 8
  #endif
  static const bool LED_ACTIVE_LOW = true;
#else
  #ifndef LED_BUILTIN
    #define LED_BUILTIN 2
  #endif
  #define PIN_STATUS_LED LED_BUILTIN
  static const bool LED_ACTIVE_LOW = false;
#endif
static const bool LED_ENABLED    = (PIN_STATUS_LED != ONE_WIRE_BUS);

inline void ledInit()  { if (LED_ENABLED) { pinMode(PIN_STATUS_LED, OUTPUT); digitalWrite(PIN_STATUS_LED, LED_ACTIVE_LOW ? HIGH : LOW); } }
inline void ledOn()    { if (LED_ENABLED) digitalWrite(PIN_STATUS_LED, LED_ACTIVE_LOW ? LOW  : HIGH); }
inline void ledOff()   { if (LED_ENABLED) digitalWrite(PIN_STATUS_LED, LED_ACTIVE_LOW ? HIGH : LOW);  }
inline void ledBlink(uint8_t n, uint16_t onMs = 60, uint16_t offMs = 120) {
  if (!LED_ENABLED) return;
  while (n--) { ledOn(); delay(onMs); ledOff(); delay(offMs); }
}

// ---------------- Identity --------------------------------------------------
static const char* SENSOR_NAME = "Setpoint";
static const char* FW_VERSION  = "2.9.5";

// The setup SoftAP is intentionally OPEN (no password): it only exists during
// first-time Wi-Fi setup and is torn down once the probe joins the home network,
// so an open AP keeps setup one-tap simple. (A per-unit WPA2 key can be
// reintroduced for higher-security deployments — see git history / SECURITY.md.)

// ---------------- Sleep configuration --------------------------------------
// Set DEEP_SLEEP_ENABLED to false to revert to always-on behaviour (the web
// server and mDNS remain continuously reachable, at the cost of higher idle
// current).
//
// DEEP_SLEEP_MIN_MS: deep sleep is only used when the configured interval is
// at or above this threshold.  Below it the WiFi-reconnect overhead (~1–3 s)
// would consume more energy than it saves, so WiFi modem sleep is used
// instead.
//
// WEBSERVER_WINDOW_MS: how long the HTTP server stays alive after each wake
// before the device goes back to sleep.  The hub's auto-provision request
// and any browser visit must arrive within this window.  Increase it if you
// need more time to reach /provision after a config change.
//
// NTP_RESYNC_INTERVAL: once this many deep-sleep wakes have passed since the
// last SUCCESSFUL NTP sync, an async resync is kicked on the next CONNECTED
// wake to correct accumulated RTC drift (see rtc_wakesSinceSync / ntpService).
#define DEEP_SLEEP_ENABLED true
static const uint32_t DEEP_SLEEP_MIN_MS   = 10000UL;  // 10 s
static const uint32_t WEBSERVER_WINDOW_MS =  3000UL;  //  3 s
static const uint32_t NTP_RESYNC_INTERVAL =    30UL;  // wakes since last successful sync
// ...or this much elapsed time, whichever comes first (see ntpResyncDue). The
// wake count alone means a slow interval resyncs almost never — exactly when
// RTC drift is largest. 6 h bounds drift without adding meaningful radio time.
static const uint32_t NTP_RESYNC_MAX_AGE_S = 6UL * 3600UL;

// ---------------- Disturbance burst (freezer door / rapid change) -----------
// In deep-sleep mode the probe is asleep between wakes, so a brief event (a
// freezer door opening) and the short connectivity window it opens can be slept
// through. When a wake reading differs from the previous one by more than
// BURST_DELTA_C, the probe treats it as a disturbance: it stays awake, keeps
// Wi-Fi up, samples every BURST_SAMPLE_MS and flushes the offline buffer hard
// for BURST_WINDOW_MS before returning to deep sleep — so the event and any
// backlog reach the hub while they can. This only CATCHES an event if a
// scheduled wake lands during it, so it helps most at short/moderate intervals;
// true wake-on-temperature needs an analog sensor + comparator on a wake pin
// (a hardware revision — the DS18B20 has no interrupt output). Set to false to
// disable and keep the plain fixed-interval deep-sleep behaviour.
#define BURST_ON_DISTURBANCE  true
static const float    BURST_DELTA_C   = 1.0f;     // °C change vs last wake that counts as a disturbance
// BURST_DELTA_C is calibrated against CLOSE-TOGETHER wakes: at a few seconds
// apart a 1 °C jump really is a door opening. The comparison is against the
// PREVIOUS WAKE, so its meaning drifts as the interval grows — at 15 minutes a
// fridge's normal compressor cycle swings well past 1 °C, and every one of those
// would fire a 20 s radio-on burst, burning battery on routine operation. So
// scale the threshold with the wake spacing, and above BURST_MAX_INTERVAL_MS
// stop bursting altogether: at that cadence the probe has already conceded
// event resolution, and a burst can no longer catch the event that caused it.
static const uint32_t BURST_BASELINE_MS    =   5000UL;  // spacing BURST_DELTA_C assumes
static const uint32_t BURST_MAX_INTERVAL_MS = 300000UL;  // 5 min — above this, burst is off
static const float    BURST_DELTA_MAX_C    =   4.0f;    // never demand more than this
static const uint32_t BURST_WINDOW_MS = 20000UL;  // stay awake/flushing this long after one
static const uint32_t BURST_SAMPLE_MS =  1000UL;  // sample cadence during the burst
// Battery guard: cap back-to-back bursts so a repeatedly-opened door (or a slow
// thaw drifting past the threshold every wake) can't hold the probe awake and
// flatten the battery. After this many bursts in a row the burst is suppressed
// until a settled (non-disturbed) wake re-arms it — normal fixed-interval
// logging continues throughout; only the aggressive stay-awake flush is paused.
static const uint32_t BURST_MAX_CONSECUTIVE = 3;

// ---------------- Threshold watch (sample often, transmit rarely) -----------
// The burst above reacts to a sudden CHANGE. It cannot catch the failure that
// matters most: a freezer thawing slowly. Hours of small per-wake deltas never
// reach BURST_DELTA_C, and above BURST_MAX_INTERVAL_MS bursting is off entirely
// — which is exactly the long-interval configuration where a silent excursion
// costs the most. So watch the ABSOLUTE limits too.
//
// The asymmetry this exploits: reading the sensor is cheap (CPU + a conversion,
// no radio), associating and POSTing is expensive (seconds of radio at ~100 mA).
// So decouple the two. Wake every `cfg_sample_ms` and read; keep the radio OFF
// and buffer the reading unless the report interval is due OR the reading just
// crossed a limit. A probe on a 15-minute report interval can then notice a
// breach within a minute, and — because every sample is buffered and flushed on
// the next report — the hub receives the finer history too, at no extra radio
// cost. Limits come from the hub (alert_thresholds) over the existing
// provision/ingest-reply channel, so the probe never invents them.
//
// OFF unless the hub supplies limits AND a sample interval shorter than the
// report interval: with either unset this file behaves exactly as it did.
static const float    WATCH_UNSET_C       = -999.0f;  // sentinel: no limit configured
// Clearing needs to beat the limit by this much before it counts as recovered,
// so a probe parked exactly on its limit doesn't transmit an enter/clear pair
// every sample and flatten its battery.
static const float    WATCH_HYSTERESIS_C  = 0.5f;
static const uint32_t WATCH_SAMPLE_MIN_MS = 5000UL;   // floor on the sample cadence

// ---------------- Wake-time / radio budget (battery) ------------------------
// A freezer is an RF box, so a probe that can't associate must not hold its
// radio on for the old 15 s every wake. The per-wake reconnect budget is 8 s,
// and after WIFI_FAIL_BACKOFF_AFTER consecutive failures the probe only ATTEMPTS
// a connect every WIFI_FAIL_BACKOFF_EVERY-th wake (radio stays off on the
// others; readings are still taken and buffered). A disturbance burst always
// retries regardless — that's when connectivity is most likely to have returned.
static const uint32_t WIFI_CONNECT_MS         = 8000UL;
static const uint32_t WIFI_FAIL_BACKOFF_AFTER = 3;
static const uint32_t WIFI_FAIL_BACKOFF_EVERY = 4;
// Cold-boot (power-on / recharge) grace to rejoin the SAVED network before the
// probe gives up and continues offline. Longer than a deep-sleep wake attempt:
// after a shared power outage the router is often still booting, and a probe
// that flips to its own setup AP on a brief miss looks broken. Tunable.
static const uint32_t WIFI_COLD_RECONNECT_MS  = 60000UL;

// Captive-portal timeout (power-outage lockout guard). A cold boot whose saved
// Wi-Fi is unreachable (e.g. after a power outage the router reboots slower
// than the probe) used to block in the portal FOREVER (portal timeout 0),
// taking no readings until a human power-cycled it. The portal now gives up
// after PORTAL_TIMEOUT_S: with saved credentials the probe continues into
// normal operation OFFLINE (readings buffered, Wi-Fi retried periodically in
// loop() / on the next wake); with NO saved credentials the portal is simply
// re-opened in a loop — there is nothing useful to run without them.
static const uint32_t PORTAL_TIMEOUT_S = 180;

// Field-recovery escape hatch. Continuing OFFLINE on a saved-network miss is
// right for a transient outage (router still booting), but a PERMANENT change —
// a new router, a changed SSID/password, or moving the probe to another house —
// would otherwise strand it offline forever with no way to re-point it short of
// a USB re-flash. So count consecutive cold boots whose saved network stayed
// unreachable through the full grace window; after this many (a deliberate,
// persistent condition — a healthy network reconnects and clears the count on
// the first cold boot), open the setup portal ONCE so the user can reconfigure.
// A single recharge or brief outage never reaches it, so the probe still won't
// flip to its own AP on a passing miss. Recovery gesture, for the docs: power-
// cycle the probe this many times to force setup mode.
static const uint32_t COLD_FAIL_PORTAL_AFTER = 3;

// The hub's auto-provisioner only needs to reach the probe occasionally, so the
// 3 s HTTP window isn't held on every deep-sleep wake: it's served for the first
// WEBSERVER_WARMUP_WAKES (initial provisioning) and then every
// WEBSERVER_WINDOW_EVERY-th wake, reclaiming awake-time on all the others.
static const uint32_t WEBSERVER_WARMUP_WAKES = 5;
static const uint32_t WEBSERVER_WINDOW_EVERY = 6;

// ---------------- DS18B20 ---------------------------------------------------
OneWire           oneWire(ONE_WIRE_BUS);
DallasTemperature sensors(&oneWire);

// 11-bit resolution → 0.125 °C steps, ~375 ms conversion. This is 4x finer than
// 9-bit (which quantised gradual changes into visible 0.5 °C stair-steps) while
// STILL fitting the 500 ms minimum interval — 12-bit's 750 ms conversion would
// exceed it and silently cap the fastest sample rate. Resolution changes the
// quantisation step, not the sensor's ±0.5 °C absolute accuracy (worse below
// -10 °C); use the per-probe calibration offset for absolute correction.
// setWaitForConversion(false) means requestTemperatures() returns instantly and
// the loop never blocks; g_convMs (set by applyResolution) is how long Phase 2
// waits before reading. 11-bit is the DEFAULT; the resolution is provisionable
// per-probe (9..12) from the hub's Devices page and persisted to NVS.
static const uint8_t  DS_RESOLUTION_DEFAULT_BITS = 11;
// Retry a failed (DEVICE_DISCONNECTED_C) read this many times within the wake
// before treating it as a real fault, so a transient 1-Wire glitch (marginal
// pull-up, long lead, EMI) doesn't punch a gap in the log.
static const uint8_t  DS_READ_RETRIES    = 2;

// ---------------- Config (NVS) ----------------------------------------------
Preferences prefs;   // namespace: "tscfg"
String   cfg_server_url = "";
String   cfg_token      = "";
uint32_t cfg_interval   = 5000;   // ms between readings (= how often we REPORT)
uint8_t  cfg_res_bits   = DS_RESOLUTION_DEFAULT_BITS;  // DS18B20 resolution (9..12), provisionable
// Threshold watch, all hub-supplied. cfg_sample_ms is how often to READ; it is
// only honoured when shorter than cfg_interval and at least one limit is set.
float    cfg_alert_min_c = WATCH_UNSET_C;
float    cfg_alert_max_c = WATCH_UNSET_C;
uint32_t cfg_sample_ms   = 0;     // 0 = no separate sample cadence (read == report)

// ---------------- WiFiManager parameters ------------------------------------
WiFiManager wm;
// BUFFER lengths, not value lengths. WiFiManagerParameter::setValue(v, length)
// takes the parameter's buffer size -- it reallocs to `length`, strncpy's into
// it, renders it as the input's maxlength=, and truncates the SUBMITTED value
// to it on save. Passing the current value's length instead (which two call
// sites did) shrinks the field: an unprovisioned probe has an empty
// server_url, so the portal rendered maxlength="0" and silently discarded
// whatever the customer typed -- on the one screen every customer passes
// through. Named here so the declarations and the three setValue call sites
// cannot drift apart again.
static const int P_SERVER_LEN   = 128;
static const int P_TOKEN_LEN    = 64;
static const int P_INTERVAL_LEN = 10;    // max uint32 is 4294967295 -> 10 digits
WiFiManagerParameter p_server  ("server",   "Server URL",             "",     P_SERVER_LEN);
WiFiManagerParameter p_token   ("token",    "Ingest token (optional)","",      P_TOKEN_LEN);
// "Read interval" was the wrong name: this sets cfg_interval, which is how often
// the probe TRANSMITS. With the threshold watch armed it reads far more often than
// this. The dashboard field it mirrors is called "Reporting Interval", and a
// customer who reads one screen and then the other has to see the same words --
// this is the captive portal, the one screen every customer passes through.
WiFiManagerParameter p_interval("interval", "Reporting interval (ms)", "5000",  P_INTERVAL_LEN);

// ---------------- HTTP server -----------------------------------------------
WebServer http(80);

// ---------------- Cached identity (computed once per boot) ------------------
static String g_chipId;
static String g_romHex;
static String g_probeId;
static String g_instanceName;

// ---------------- Offline buffer (LittleFS) ---------------------------------
// Each line in the buffer file: "TIMESTAMP,TEMP_C,TEMP_F,PROBE_ID\n"
// ~50 bytes/line.
static const char*    BUFFER_FILE      = "/buf.csv";
static const uint32_t BUFFER_MAX_BYTES = 1900UL * 1024UL;  // 1.9 MB cap
static const uint32_t BUFFER_MIN_FREE  =    8UL * 1024UL;  // 8 KB FS headroom
static const char*    BUF_POS_KEY = "buf_pos";
// Consecutive cold boots whose saved Wi-Fi stayed unreachable (see
// COLD_FAIL_PORTAL_AFTER). NVS-backed, not RTC, so it survives the full power
// loss of a dead battery / recharge — the exact event this guards.
static const char*    COLD_FAIL_KEY = "coldfail";
// Flush checkpoint/budget: persist buf_pos every N successful uploads (plus
// always when a flush stops or completes) instead of after every line — the
// same resume guarantee at ~1/10th the NVS write wear. In deep-sleep mode one
// wake spends at most FLUSH_BUDGET_MS flushing backlog and resumes from the
// checkpoint on the next wake, so a large backlog can't pin the probe awake
// for minutes; always-on mode has no cap (it can afford to finish the job).
static const uint16_t FLUSH_CHECKPOINT_EVERY = 10;
static const uint32_t FLUSH_BUDGET_MS        = 20000UL;
// Readings per POST /api/ingest_csv chunk when draining the backlog in bulk
// (one HTTP round-trip per chunk instead of one per reading). 100 lines is
// ~5 KB — well under the hub's 64 KB body cap and its <=1000-row limit.
static const uint16_t FLUSH_CHUNK_ROWS       = 100;

// ---------------- RTC memory (survives deep sleep) --------------------------
// These variables live in the ESP32 RTC slow-memory SRAM and retain their
// values across deep-sleep cycles.  They are reset only on a power-cycle or
// hard chip reset.
RTC_DATA_ATTR static uint32_t rtc_bootCount    = 0;    // wake counter
RTC_DATA_ATTR static bool     rtc_timeValid    = false; // true once NTP has synced
RTC_DATA_ATTR static int64_t  rtc_epochMsAtSleep = 0;  // unix epoch in MILLISECONDS saved before sleep
RTC_DATA_ATTR static uint32_t rtc_sleepMs      = 0;    // intended sleep duration
RTC_DATA_ATTR static uint32_t rtc_wakesSinceSync = 0;  // deep-sleep wakes since last SUCCESSFUL NTP sync
RTC_DATA_ATTR static float    rtc_lastReadingC   = -999.0f; // last temp (across sleep) for disturbance detection; -999 = unset
RTC_DATA_ATTR static uint32_t rtc_burstStreak    = 0;       // consecutive wakes that fired a burst (cap guard)
RTC_DATA_ATTR static uint32_t rtc_wifiFailStreak = 0;       // consecutive deep-sleep reconnect failures (backoff)
// Threshold watch, carried across deep sleep.
RTC_DATA_ATTR static uint32_t rtc_msSinceReport  = 0;       // ms slept+worked since the last successful report
RTC_DATA_ATTR static bool     rtc_inBreach       = false;   // was the last evaluated reading outside its limits?

// ---------------- State -----------------------------------------------------
static bool          g_timeValid     = false;
static unsigned long g_lastSend      = 0;
static unsigned long g_convReqAt     = 0;
static bool          g_convPending   = false;
static float         g_lastC         = NAN;
static unsigned long g_lastAtMs      = 0;
static bool          g_wasConnected  = false;
static unsigned long g_lastFlushAt   = 0;
static unsigned long g_wakeStart     = 0;   // millis() at top of setup()
static bool          g_deepSleepMode = false;
// Set in setup(): this wake exists only to read the sensor, so the radio was
// never powered. loop() may still power it up if the reading crossed a limit.
static bool          g_sampleOnlyWake = false;
static uint16_t      g_convMs        = 375;  // DS18B20 conversion wait; tracks cfg_res_bits (applyResolution)

// ============================================================================
// Time helpers
// ============================================================================

// SNTP is used ASYNCHRONOUSLY: configTime() only starts the background query
// and returns immediately. Only a cold boot waits for the first sync — briefly
// and bounded (NTP_COLDBOOT_WAIT_MS) — so first-boot readings can carry real
// stamps when NTP answers quickly. Everywhere else validity is polled
// opportunistically from ntpService() with a growing backoff, so a LAN without
// internet NTP can never freeze the loop (the old syncTime() blocked 8 s per
// attempt, retried every 60 s, forever).
static const time_t   NTP_SANE_EPOCH       = 1672531200;  // 2023-01-01 — clock is "set" past this
static const uint32_t NTP_COLDBOOT_WAIT_MS = 3000UL;      // bounded first-sync wait, cold boot only
static const uint32_t NTP_BACKOFF_MIN_MS   = 60000UL;     // first async retry after 60 s...
static const uint32_t NTP_BACKOFF_MAX_MS   = 300000UL;    // ...doubling up to a 5 min cap

static bool          g_sntpStarted   = false;
static uint32_t      g_ntpBackoffMs  = NTP_BACKOFF_MIN_MS;
static unsigned long g_ntpLastKickAt = 0;

// True once the system clock holds real time — set by SNTP in the background,
// or restored from the RTC after deep sleep.
bool clockLooksValid() { return time(nullptr) >= NTP_SANE_EPOCH; }

// Start (or restart) the asynchronous SNTP query. Returns immediately; lwip
// sets the system clock in the background whenever a server answers.
void ntpKick() {
  configTime(0, 0, "pool.ntp.org", "time.nist.gov");
  g_sntpStarted   = true;
  g_ntpLastKickAt = millis();
}

// Returns current UTC time as an ISO 8601 string WITH milliseconds
// ("2026-07-21T00:42:04.500Z"), or "" if time is unknown. Sub-second precision
// keeps a high-rate cadence (down to the 500 ms floor) distinguishable instead
// of collapsing multiple readings onto one whole-second stamp. Seconds and
// milliseconds are taken from the same gettimeofday() call so they can't skew.
String nowIso() {
  if (!g_timeValid) return "";
  struct timeval tv;
  if (gettimeofday(&tv, nullptr) != 0 || tv.tv_sec < 1000000000L) return "";
  struct tm ti;
  gmtime_r(&tv.tv_sec, &ti);  // configTime(0,0,...) runs the clock in UTC
  char buf[32];
  size_t n = strftime(buf, sizeof(buf), "%Y-%m-%dT%H:%M:%S", &ti);
  snprintf(buf + n, sizeof(buf) - n, ".%03ldZ", (long)(tv.tv_usec / 1000));
  return String(buf);
}

// Non-blocking NTP service — safe to call every loop() iteration; never blocks.
//  1. Promotes g_timeValid (and the RTC copy) once the async SNTP query lands,
//     zeroing the drift-resync wake counter.
//  2. While the clock is still unset and Wi-Fi is up, re-kicks the query with
//     a growing backoff (60 s doubling to a 5 min cap), so a LAN with no
//     internet NTP costs a cheap periodic retry instead of a frozen loop.
void ntpService(bool connected) {
  // A completed SNTP round — initial sync OR a drift resync of an already-valid
  // clock — resets the wakes-since-sync counter. (sntp_get_sync_status()
  // returns COMPLETED once per finished round, then resets itself.)
  if (g_sntpStarted && sntp_get_sync_status() == SNTP_SYNC_STATUS_COMPLETED) {
    bool first = !g_timeValid;
    g_timeValid = rtc_timeValid = true;
    rtc_wakesSinceSync = 0;
    Serial.printf("[NTP] %s: %s\n", first ? "Synced" : "Drift resync done",
                  nowIso().c_str());
    return;
  }
  // The clock can also turn valid without us catching COMPLETED (status already
  // consumed elsewhere) — a sane epoch is proof enough to start stamping and
  // buffering readings.
  if (!g_timeValid && clockLooksValid()) {
    g_timeValid = rtc_timeValid = true;
    rtc_wakesSinceSync = 0;
    Serial.printf("[NTP] Clock valid: %s\n", nowIso().c_str());
    return;
  }
  // Still no clock: retry the async query with backoff while connected.
  if (!g_timeValid && connected &&
      (!g_sntpStarted || millis() - g_ntpLastKickAt >= g_ntpBackoffMs)) {
    Serial.printf("[NTP] Async retry (next in %lus).\n",
                  (unsigned long)(g_ntpBackoffMs / 1000UL));
    ntpKick();
    g_ntpBackoffMs = (g_ntpBackoffMs >= NTP_BACKOFF_MAX_MS / 2)
                     ? NTP_BACKOFF_MAX_MS : g_ntpBackoffMs * 2;
  }
}

// ============================================================================
// NVS helpers
// ============================================================================
void loadConfig() {
  if (!prefs.begin("tscfg", true)) return;
  cfg_server_url = prefs.getString("server_url", cfg_server_url);
  cfg_token      = prefs.getString("token",      cfg_token);
  cfg_interval   = prefs.getUInt  ("interval",   cfg_interval);
  cfg_res_bits   = prefs.getUChar ("res_bits",   cfg_res_bits);
  cfg_alert_min_c = prefs.getFloat("al_min",     cfg_alert_min_c);
  cfg_alert_max_c = prefs.getFloat("al_max",     cfg_alert_max_c);
  cfg_sample_ms   = prefs.getUInt ("sample_ms",  cfg_sample_ms);
  prefs.end();
}

// ---------------- Threshold watch helpers -----------------------------------

// True when the hub has given this probe at least one limit AND a sample
// cadence shorter than its report interval. Everything the watch does is gated
// on this, so a probe the hub has said nothing to behaves exactly as before.
static bool watchArmed();

// How long to deep-sleep at the end of a wake, given how long this wake took.
//
// One definition, because there are three exits from the loop that need it and
// two of them used to answer `cfg_interval` unconditionally -- so with the watch
// armed, a transient sensor fault or a disturbance burst blinded the probe for a
// whole REPORT interval when it should have been back in cfg_sample_ms. On a
// 15-minute reporting probe watching a freezer that is a quarter of an hour of
// not looking, immediately after the two events most likely to matter.
//
// `floorMs` is the shortest sleep this exit may take. 100 ms is the generic
// anti-reboot floor for a wake that merely overran its own deadline; a caller
// that has just spent twenty seconds with the radio on needs a real one.
// `reportCadenceWhenOverdue` is for the exit that cannot report at all -- see
// the untilReport == 0 branch.
static uint32_t nextSleepMs(unsigned long elapsed, uint32_t floorMs,
                            bool reportCadenceWhenOverdue) {
  if (watchArmed()) {
    // To the next SAMPLE, not the next report -- but never past the report
    // itself, so a report is not delayed by up to one sample gap.
    uint32_t untilReport = rtc_msSinceReport < cfg_interval
                           ? cfg_interval - rtc_msSinceReport : 0UL;
    uint32_t gap = cfg_sample_ms < untilReport ? cfg_sample_ms : untilReport;
    if (untilReport == 0UL) {
      // The report deadline has passed. Normally that means one just fired and
      // the next sample is the right target -- but rtc_msSinceReport is only
      // reset by a SUCCESSFUL post, so on a persistent sensor fault it sits
      // past cfg_interval forever. Every wake then looks report-due, which
      // means the radio comes up for a full association, every sample gap, on
      // a probe whose DS18B20 is simply dead. The fault exit asks for the
      // report cadence here instead; a dead sensor costs one wake per
      // reporting interval, exactly as it did before the watch was involved.
      if (reportCadenceWhenOverdue) {
        return cfg_interval > (uint32_t)elapsed
               ? (uint32_t)(cfg_interval - elapsed) : floorMs;
      }
      gap = cfg_sample_ms;                          // report just fired
    }
    // Only when the report is ALREADY DUE. This used to read
    // `gap < WATCH_SAMPLE_MIN_MS`, which also fired for any remainder of
    // 1..4999 ms -- undoing the clamp on the line above, which exists precisely
    // so a report is not delayed. The probe then slept a whole sample gap
    // instead of the short remainder and the report landed up to cfg_sample_ms
    // late, every cycle, whenever cfg_interval % cfg_sample_ms fell in that band.
    return gap > (uint32_t)elapsed ? (uint32_t)(gap - elapsed) : floorMs;
  }
  // Unsigned arithmetic: if elapsed > cfg_interval, sleep a 100 ms minimum
  // rather than wrapping into a tight reboot loop.
  return cfg_interval > (uint32_t)elapsed
         ? (uint32_t)(cfg_interval - elapsed) : 100UL;
}

static bool watchArmed() {
  bool haveLimit = (cfg_alert_min_c > WATCH_UNSET_C) || (cfg_alert_max_c > WATCH_UNSET_C);
  return haveLimit && cfg_sample_ms >= WATCH_SAMPLE_MIN_MS && cfg_sample_ms < cfg_interval;
}

// Is this reading outside its limits? Hysteresis is applied only on the way
// OUT: entering breach is judged against the bare limit (report the excursion
// the moment it happens), leaving it must beat the limit by WATCH_HYSTERESIS_C.
static bool outsideLimits(float tC) {
  const float slack = rtc_inBreach ? WATCH_HYSTERESIS_C : 0.0f;
  if (cfg_alert_max_c > WATCH_UNSET_C && tC > cfg_alert_max_c - slack) return true;
  if (cfg_alert_min_c > WATCH_UNSET_C && tC < cfg_alert_min_c + slack) return true;
  return false;
}

void saveConfig() {
  if (!prefs.begin("tscfg", false)) return;
  prefs.putString("server_url", cfg_server_url);
  prefs.putString("token",      cfg_token);
  prefs.putUInt  ("interval",   cfg_interval);
  prefs.putUChar ("res_bits",   cfg_res_bits);
  prefs.putFloat ("al_min",     cfg_alert_min_c);
  prefs.putFloat ("al_max",     cfg_alert_max_c);
  prefs.putUInt  ("sample_ms",  cfg_sample_ms);
  prefs.end();
}

// DS18B20 conversion time doubles per resolution bit: 12b≈750, 11≈375, 10≈188,
// 9≈94 ms. applyResolution() sets the sensor AND the matching Phase-2 wait in one
// place so they can never drift apart (a too-short wait reads a stale value).
static uint16_t convMsFor(uint8_t bits) {
  if (bits < 9)  bits = 9;
  if (bits > 12) bits = 12;
  return (uint16_t)(750UL >> (12 - bits));
}
void applyResolution(uint8_t bits) {
  if (bits < 9)  bits = 9;
  if (bits > 12) bits = 12;
  cfg_res_bits = bits;
  sensors.setResolution(bits);
  g_convMs = convMsFor(bits);
}

// True when an NTP drift resync should be kicked on this connected wake.
//
// Counting WAKES alone scales exactly the wrong way: at a 5 s interval 30 wakes
// is 2.5 minutes, but at 15 minutes it is 7.5 hours and at an hourly interval
// 30 hours — so the longer we sleep (and the more the RTC drifts, especially on
// a board with no 32.768 kHz crystal running its RC oscillator cold in a
// freezer) the LESS often we would correct it. Trigger on whichever comes
// first: the wake count, or roughly NTP_RESYNC_MAX_AGE_S of elapsed time,
// derived from wakes x interval so it needs no extra RTC state.
bool ntpResyncDue() {
  if (rtc_wakesSinceSync >= NTP_RESYNC_INTERVAL) return true;
  uint64_t elapsedMs = (uint64_t)rtc_wakesSinceSync * (uint64_t)cfg_interval;
  return elapsedMs >= (uint64_t)NTP_RESYNC_MAX_AGE_S * 1000ULL;
}

// The disturbance threshold for the CURRENT wake spacing, or -1 when bursting is
// disabled at this interval (see BURST_MAX_INTERVAL_MS). BURST_DELTA_C assumes
// wakes ~BURST_BASELINE_MS apart; the further apart they are, the more the
// temperature legitimately moves between them, so the bar rises with the square
// root of the spacing (drift grows sub-linearly) and is capped so it stays
// reachable by a real event.
float burstDeltaC() {
  if (cfg_interval > BURST_MAX_INTERVAL_MS) return -1.0f;      // off at long sleeps
  float scale = sqrtf((float)cfg_interval / (float)BURST_BASELINE_MS);
  if (scale < 1.0f) scale = 1.0f;
  float d = BURST_DELTA_C * scale;
  return d > BURST_DELTA_MAX_C ? BURST_DELTA_MAX_C : d;
}

uint32_t loadBufPos() {
  if (!prefs.begin("tscfg", true)) return 0;
  uint32_t pos = prefs.getUInt(BUF_POS_KEY, 0);
  prefs.end();
  return pos;
}

void saveBufPos(uint32_t pos) {
  if (!prefs.begin("tscfg", false)) return;
  prefs.putUInt(BUF_POS_KEY, pos);
  prefs.end();
}

uint32_t loadColdFail() {
  if (!prefs.begin("tscfg", true)) return 0;
  uint32_t n = prefs.getUInt(COLD_FAIL_KEY, 0);
  prefs.end();
  return n;
}

void saveColdFail(uint32_t n) {
  if (!prefs.begin("tscfg", false)) return;
  prefs.putUInt(COLD_FAIL_KEY, n);
  prefs.end();
}

// ============================================================================
// Offline buffer
// ============================================================================

// ``ts`` MAY be empty. A probe whose clock has never synced (nowIso() returns ""
// until g_timeValid) used to have its reading DROPPED here — which meant that on
// a LAN with no internet access, where NTP never lands, the offline buffer never
// engaged at all and every reading taken while the hub was unreachable was lost.
// That is precisely the local-first / no-cloud deployment this product is sold
// for, so it is the worst place to lose data.
//
// An empty stamp is written through as an empty leading CSV field; the hub
// receipt-stamps such rows on arrival (spread 1 ms apart, exactly as it already
// does for timestamp-less live posts), so the readings survive. The trade-off is
// that a backlog drained this way carries DRAIN-time chronology rather than
// measurement-time — values are correct, spacing is not. Preserving the values
// beats discarding them; carrying a relative uptime offset so the spacing
// survives too would need a buffer-format change on both sides.
void bufferAppend(const String& ts, float tC, float tF) {

  if (LittleFS.exists(BUFFER_FILE)) {
    File f = LittleFS.open(BUFFER_FILE, "r");
    uint32_t sz = f ? f.size() : 0;
    if (f) f.close();
    if (sz >= BUFFER_MAX_BYTES) {
      Serial.printf("[Buffer] Cap reached (%u KB) — reading dropped."
                    " Connect to hub to flush.\n", sz / 1024);
      return;
    }
  }

  uint32_t freeBytes = LittleFS.totalBytes() - LittleFS.usedBytes();
  if (freeBytes < BUFFER_MIN_FREE) {
    Serial.printf("[Buffer] Filesystem full (%u bytes free) — reading dropped."
                  " Connect to hub to flush.\n", freeBytes);
    return;
  }

  File f = LittleFS.open(BUFFER_FILE, "a");
  if (!f) { Serial.println("[Buffer] Could not open buffer file."); return; }
  f.printf("%s,%.3f,%.3f,%s\n", ts.c_str(), tC, tF, g_probeId.c_str());
  f.close();
  Serial.printf("[Buffer] Saved (ts=%s tC=%.2f)  free=%u KB\n",
                ts.c_str(), tC, freeBytes / 1024);
}

// Apply the hub's desired settings carried on an /api/ingest reply
// (``{"ok":true,"config":{"interval_ms":…,"resolution_bits":…}}``).
//
// This is the PULL half of config delivery. The hub also pushes to our
// /provision, but that only works if it catches us awake — and a deep-sleeping
// probe serves HTTP for ~3 s every Nth wake, so on a long interval the push
// almost never lands and a dashboard change would sit undelivered. Our own
// ingest POST happens every wake and always succeeds, so we take the settings
// from its reply instead. Deliberately limited to interval and resolution: the
// server URL and token stay push-only, so a hub reply can never re-point a probe
// at a different server.
//
// Only writes NVS when a value actually changes (flash wear), and re-evaluates
// the deep-sleep mode with the same expression setup() uses so a probe switched
// across the DEEP_SLEEP_MIN_MS boundary starts sleeping without a power cycle.
bool applyHubConfig(const String& payload) {
  // 512, to agree with the caller's own guard. postReading only calls this for
  // a reply under 512 bytes, but the pool was sized at 320 -- and a pool needs
  // MORE than the body it parses, not less (a slot per member plus a copy of
  // every key and string value). Measured against ArduinoJson 6.21.6: today's
  // five-field config reply needs 184 B, but the eight-field one a hub would
  // send if desired_probe_config ever carried server_url/token needs 327 B and
  // would have been rejected here as NoMemory -- silently, since the caller
  // discards the bool. See tests/test_firmware_json_capacity.py.
  StaticJsonDocument<512> doc;
  if (deserializeJson(doc, payload)) return false;
  JsonVariantConst c = doc["config"];
  if (c.isNull()) return false;          // older hub — nothing to apply

  bool changed = false;

  uint32_t wantInterval = (uint32_t)(c["interval_ms"] | 0UL);
  if (wantInterval >= 500UL && wantInterval != cfg_interval) {
    cfg_interval = wantInterval;
    changed = true;
  }

  uint8_t wantRes = (uint8_t)(c["resolution_bits"] | 0);
  if (wantRes >= 9 && wantRes <= 12 && wantRes != cfg_res_bits) {
    cfg_res_bits = wantRes;
    applyResolution(cfg_res_bits);       // sensor + matching conversion wait
    changed = true;
  }

  // Threshold watch. Limits arrive as JSON null when the hub has none for this
  // probe, which must CLEAR a previously-set limit rather than be ignored —
  // otherwise deleting a threshold on the dashboard leaves the probe still
  // waking every minute to check a limit nobody holds any more. `| WATCH_UNSET_C`
  // supplies exactly that: an absent or null key reads back as unset.
  if (c.containsKey("alert_min_c")) {
    float v = c["alert_min_c"] | WATCH_UNSET_C;
    if (v != cfg_alert_min_c) { cfg_alert_min_c = v; changed = true; }
  }
  if (c.containsKey("alert_max_c")) {
    float v = c["alert_max_c"] | WATCH_UNSET_C;
    if (v != cfg_alert_max_c) { cfg_alert_max_c = v; changed = true; }
  }
  if (c.containsKey("sample_ms")) {
    uint32_t v = (uint32_t)(c["sample_ms"] | 0UL);
    if (v != cfg_sample_ms) { cfg_sample_ms = v; changed = true; }
  }

  if (changed) {
    saveConfig();
    g_deepSleepMode = DEEP_SLEEP_ENABLED && (cfg_interval >= DEEP_SLEEP_MIN_MS);
    Serial.printf("[Config] Applied from hub: interval=%lu ms, resolution=%u-bit, sleep=%s\n",
                  (unsigned long)cfg_interval, cfg_res_bits,
                  g_deepSleepMode ? "deep" : "modem");
    if (watchArmed()) {
      Serial.printf("[Watch] Armed: limits %.1f..%.1f C, sampling every %lu ms "
                    "(reporting every %lu ms).\n",
                    cfg_alert_min_c, cfg_alert_max_c,
                    (unsigned long)cfg_sample_ms, (unsigned long)cfg_interval);
    } else {
      Serial.println("[Watch] Off (no limits, or sample interval not shorter than report interval).");
    }
  }
  return changed;
}

// POST a single reading with an explicit timestamp.  Returns true on HTTP 2xx.
bool postWithTimestamp(const String& ts, float tC, float tF,
                       const String& pid) {
  if (WiFi.status() != WL_CONNECTED || cfg_server_url.length() == 0)
    return false;

  StaticJsonDocument<256> doc;
  if (ts.length()) doc["timestamp"]     = ts;
  doc["temperature_c"] = tC;
  doc["temperature_f"] = tF;
  doc["probe_id"]      = pid;

  String body;
  serializeJson(doc, body);

  HTTPClient httpc;
  httpc.begin(cfg_server_url);
  httpc.setTimeout(3000);
  httpc.addHeader("Content-Type", "application/json");
  if (cfg_token.length()) httpc.addHeader("X-Token",    cfg_token);
  httpc.addHeader("X-Probe-ID", pid);

  int code = httpc.POST((uint8_t*)body.c_str(), body.length());
  bool ok = (code >= 200 && code < 300);
  // Pull any config the hub wants us to run BEFORE closing the connection.
  // This is the reliable direction: the hub's push to our /provision only lands
  // if it catches us awake, and in deep sleep we serve HTTP for ~3 s every Nth
  // wake — so on a long interval a settings change could never reach us. This
  // reply arrives on every successful post, at no extra radio cost.
  if (ok) {
    String reply = httpc.getString();
    httpc.end();
    if (reply.length() && reply.length() < 512) applyHubConfig(reply);
    return true;
  }
  httpc.end();
  return false;
}

// The bulk-ingest URL derived from the single-reading server URL, or "" when it
// can't be (a non-standard URL → the caller uses the per-reading path). The
// hub's bulk route is the ingest URL + "_csv" (PROTOCOL.md §5.1).
String batchUrl() {
  return cfg_server_url.endsWith("ingest") ? cfg_server_url + "_csv" : String("");
}

// POST a chunk of raw buffer CSV lines ("ts,tC,tF,pid\n" each) to
// /api/ingest_csv. Returns +1 on HTTP 2xx (chunk stored), -1 when the endpoint
// is missing (404/405 — an older hub; the caller falls back to per-reading), and
// 0 on any other/transient failure (leave the offset put and retry later).
int postChunk(const String& url, const String& body) {
  if (WiFi.status() != WL_CONNECTED || url.length() == 0) return 0;
  HTTPClient httpc;
  httpc.begin(url);
  httpc.setTimeout(6000);
  httpc.addHeader("Content-Type", "text/csv");
  if (cfg_token.length())  httpc.addHeader("X-Token",    cfg_token);
  if (g_probeId.length())  httpc.addHeader("X-Probe-ID", g_probeId);
  int code = httpc.POST((uint8_t*)body.c_str(), body.length());
  httpc.end();
  if (code == 404 || code == 405) return -1;
  return (code >= 200 && code < 300) ? 1 : 0;
}

// Upload every reading stored in the buffer file, then delete it.
// Byte-offset of the next line is persisted in NVS on the batch path once per
// chunk (~FLUSH_CHUNK_ROWS readings) and on the per-reading fallback every
// FLUSH_CHECKPOINT_EVERY POSTs — and ALWAYS when the flush stops or completes —
// so a mid-flush drop resumes from the last checkpoint. A resume may re-send the
// last un-checkpointed chunk (a dropped ACK, or power lost before the checkpoint
// commits).
//
// Whether that replay is free depends on whether the line carries a stamp:
//
//   * STAMPED lines dedupe exactly. The hub's UNIQUE(probe_id, epoch, site) plus
//     INSERT OR IGNORE means a re-sent chunk stores nothing the second time.
//     Measured: five rows sent three times store five.
//   * UNSTAMPED lines DO NOT. Since v2.8.2 bufferAppend deliberately writes a
//     reading whose clock never synced with an empty leading field, and the hub
//     receipt-stamps such rows on arrival — so a replay gets NEW stamps, new
//     epochs, and lands as duplicate rows. Measured: five rows sent three times
//     stored eight (partly deduped only by receipt stamps colliding by chance,
//     so the count is not even predictable).
//
// This comment used to claim the opposite — "bufferAppend refuses an empty one"
// — which was true before 2.8.2 and has been wrong since. The exposure is
// narrow (it needs the ACK specifically to be lost) but it lands on the
// deployment this product is sold for: local-first, no internet, NTP never
// arrives. Closing it needs a stable per-row ordinal in the buffer format, which
// is a wire change on both sides; recorded in PROTOCOL.md §7 rather than papered
// over here. A content hash is NOT a fix: a freezer holding steady produces
// byte-identical consecutive chunks legitimately.
//
// In deep-sleep mode a single wake's flush is capped at FLUSH_BUDGET_MS and
// resumes from the checkpoint next wake.
void bufferFlush() {
  if (!LittleFS.exists(BUFFER_FILE)) return;

  File f = LittleFS.open(BUFFER_FILE, "r");
  if (!f) return;

  uint32_t fileSize = f.size();
  uint32_t pos      = loadBufPos();

  if (pos > fileSize) {
    // Checkpoint beyond EOF: the buffer file was replaced or truncated behind
    // the saved offset (e.g. a crash between delete and checkpoint on older
    // firmware). Corrupt state — reset and flush from the start rather than
    // deleting a file full of unsent readings.
    Serial.printf("[Buffer] Checkpoint %u > file size %u — corrupt; flushing from 0.\n",
                  pos, fileSize);
    pos = 0;
    saveBufPos(0);
  }

  if (pos == fileSize) {
    f.close();
    // Order matters: zero the checkpoint BEFORE removing the file. A crash
    // between the two then leaves pos=0 (worst case a harmless re-upload)
    // instead of a stale offset that would silently skip the start of the
    // NEXT buffer file.
    saveBufPos(0);
    LittleFS.remove(BUFFER_FILE);
    return;
  }

  Serial.printf("[Buffer] Flushing from offset %u / %u bytes...\n",
                pos, fileSize);
  f.seek(pos);

  int  uploaded  = 0, failed = 0;
  bool budgetHit = false;
  unsigned long flushStart = millis();

  // Prefer the bulk endpoint: one HTTP round-trip per ~100 readings instead of
  // one per reading, so a cold-soak backlog drains in seconds and the radio
  // spends far less time on. Fall back transparently to the per-reading path if
  // the URL isn't the standard /api/ingest, or if the hub is too old to have the
  // /api/ingest_csv route (a 404/405 on the first chunk this flush).
  const String burl = batchUrl();
  bool useBatch = (burl.length() > 0);

  while (f.available()) {
    http.handleClient();

    // Deep-sleep flush budget: a big backlog must not pin the probe awake for
    // minutes. Stop after ~FLUSH_BUDGET_MS; the checkpoint below means the
    // next wake resumes right here. Always-on mode has no cap.
    if (g_deepSleepMode && millis() - flushStart >= FLUSH_BUDGET_MS) {
      budgetHit = true;
      Serial.printf("[Buffer] Wake flush budget (%lus) spent after %d uploads — resuming next wake.\n",
                    (unsigned long)(FLUSH_BUDGET_MS / 1000UL), uploaded);
      break;
    }

    if (useBatch) {
      // Accumulate up to FLUSH_CHUNK_ROWS raw buffer lines into one CSV body and
      // POST the whole chunk. The hub parses/validates each line exactly like
      // /api/ingest (skips malformed, rejects out-of-range), so we forward lines
      // verbatim and only track the byte offset to resume from.
      String   body;
      int      rows     = 0;
      uint32_t chunkEnd = pos;               // offset after the last line taken
      while (rows < FLUSH_CHUNK_ROWS && f.available()) {
        String line = f.readStringUntil('\n');
        chunkEnd = f.position();
        line.trim();
        if (line.length() == 0) continue;    // skip blank; offset already advanced
        body += line;
        body += '\n';
        rows++;
      }
      if (rows == 0) { pos = chunkEnd; break; }   // only blanks remained to EOF

      int r = postChunk(burl, body);
      if (r > 0) {                    // 2xx — chunk stored
        pos = chunkEnd;
        uploaded += rows;
        saveBufPos(pos);             // one checkpoint per chunk (~100 readings)
        Serial.printf("[Buffer] Batch uploaded %d  (total %d)\n", rows, uploaded);
      } else if (r < 0) {            // hub has no /api/ingest_csv (404/405)
        Serial.println("[Buffer] Hub lacks /api/ingest_csv — using per-reading path.");
        useBatch = false;
        f.seek(pos);                 // reprocess this chunk one reading at a time
      } else {                        // transient failure — stop, resume from pos
        failed++;
        Serial.printf("[Buffer] Batch POST failed at offset %u — will retry later.\n", pos);
        break;
      }
      continue;
    }

    // ── Per-reading fallback (older hub, or non-standard server URL) ──────────
    String line = f.readStringUntil('\n');
    line.trim();
    if (line.length() == 0) { pos = f.position(); continue; }

    int c1 = line.indexOf(',');
    int c2 = (c1 >= 0) ? line.indexOf(',', c1 + 1) : -1;
    int c3 = (c2 >= 0) ? line.indexOf(',', c2 + 1) : -1;
    if (c1 < 0 || c2 < 0 || c3 < 0) {
      pos = f.position();   // skip malformed line; persisted at the next checkpoint/exit
      continue;
    }

    String ts  = line.substring(0, c1);
    float  tC  = line.substring(c1 + 1, c2).toFloat();
    float  tF  = line.substring(c2 + 1, c3).toFloat();
    String pid = line.substring(c3 + 1);

    if (postWithTimestamp(ts, tC, tF, pid)) {
      pos = f.position();
      uploaded++;
      // Checkpoint every FLUSH_CHECKPOINT_EVERY uploads, not after each one:
      // the same resume guarantee at a fraction of the NVS write wear.
      if (uploaded % FLUSH_CHECKPOINT_EVERY == 0) saveBufPos(pos);
      Serial.printf("[Buffer] Uploaded %d  (ts=%s tC=%.1f)\n",
                    uploaded, ts.c_str(), tC);
    } else {
      failed++;
      Serial.printf("[Buffer] POST failed at offset %u — will retry later.\n", pos);
      break;
    }
  }

  f.close();

  if (failed == 0 && !budgetHit) {
    // Complete flush. Zero the checkpoint BEFORE removing the file (see the
    // ordering note above).
    saveBufPos(0);
    LittleFS.remove(BUFFER_FILE);
    Serial.printf("[Buffer] Flush complete — %d readings uploaded.\n", uploaded);
  } else {
    saveBufPos(pos);   // always checkpoint the exact stop position
    Serial.printf("[Buffer] Partial flush: %d uploaded, stopped at offset %u. "
                  "Will resume later.\n", uploaded, pos);
  }
}

// ============================================================================
// HTTP helpers
// ============================================================================
void addCORS() {
  http.sendHeader("Access-Control-Allow-Origin",  "*");
  http.sendHeader("Access-Control-Allow-Methods", "GET,POST,OPTIONS");
  http.sendHeader("Access-Control-Allow-Headers", "Content-Type");
}

void sendJSON(int code, const JsonDocument& doc) {
  String out;
  serializeJson(doc, out);
  addCORS();
  http.send(code, "application/json", out);
}

void handleOptions() { addCORS(); http.send(204); }

// ============================================================================
// mDNS
// ============================================================================
void mdnsAdvertise() {
  MDNS.end();
  String host = g_instanceName;
  host.replace(".", "-");
  if (!MDNS.begin(host.c_str())) { Serial.println("[mDNS] init failed"); return; }
  MDNS.addService("_temps-probe", "_tcp", 80);
  MDNS.addServiceTxt("_temps-probe", "_tcp", "id",   g_probeId);
  MDNS.addServiceTxt("_temps-probe", "_tcp", "name", g_instanceName);
  Serial.printf("[mDNS] advertising %s as _temps-probe._tcp\n",
                g_instanceName.c_str());
}

// ============================================================================
// Web server handlers
// ============================================================================
void handleRoot() {
  String tempBlock;
  if (!isnan(g_lastC)) {
    float tF = DallasTemperature::toFahrenheit(g_lastC);
    unsigned long ageSec = (millis() - g_lastAtMs) / 1000UL;
    char ageStr[32];
    if (ageSec < 60)
      snprintf(ageStr, sizeof(ageStr), "%lus ago", ageSec);
    else
      snprintf(ageStr, sizeof(ageStr), "%lum %lus ago", ageSec / 60, ageSec % 60);

    char tBuf[64];
    snprintf(tBuf, sizeof(tBuf), "%.2f &deg;C &nbsp;/&nbsp; %.2f &deg;F", g_lastC, tF);

    tempBlock = String("<div style='margin:16px 0;padding:14px 20px;"
                       "background:#f0f4ff;border-left:4px solid #3a7bd5;"
                       "border-radius:4px;font-family:monospace'>")
      + "<span style='font-size:2rem;font-weight:bold'>" + tBuf + "</span><br>"
      + "<small style='color:#555'>Last reading: " + String(nowIso()) + "  (" + ageStr + ")</small>"
      + "</div>";
  } else {
    tempBlock = "<p style='color:#c00'><b>&#9888; No temperature reading yet.</b> "
                "Check DS18B20 wiring on GPIO " + String(ONE_WIRE_BUS) + ".</p>";
  }

  String sleepRow;
  if (g_deepSleepMode) {
    sleepRow = "<tr><td>Sleep mode</td><td>Deep sleep ("
               + String(WEBSERVER_WINDOW_MS / 1000) + " s window)</td></tr>";
  } else {
    sleepRow = "<tr><td>Sleep mode</td><td>WiFi modem sleep</td></tr>";
  }

  String html = String("<!doctype html><meta charset='utf-8'>"
                        "<meta http-equiv='refresh' content='5'>")
    + "<style>body{font-family:sans-serif;max-width:520px;margin:32px auto;padding:0 16px}"
      "table{border-collapse:collapse;width:100%}td{padding:5px 8px}"
      "tr:nth-child(even){background:#f7f7f7}</style>"
    + "<h3>" + SENSOR_NAME + " " + FW_VERSION + "</h3>"
    + tempBlock
    + "<table>"
    + "<tr><td>ID</td><td><b>"       + g_probeId                          + "</b></td></tr>"
    + "<tr><td>Server</td><td>"      + cfg_server_url                     + "</td></tr>"
    + "<tr><td>Interval</td><td>"    + String(cfg_interval)               + " ms</td></tr>"
    + "<tr><td>Time valid</td><td>"  + (g_timeValid ? "yes" : "no")       + "</td></tr>"
    + "<tr><td>WiFi RSSI</td><td>"   + String(WiFi.RSSI())                + " dBm</td></tr>"
    + "<tr><td>Uptime</td><td>"      + String(millis() / 1000UL)          + " s</td></tr>"
    + sleepRow
    + "<tr><td>Wake #</td><td>"      + String(rtc_bootCount)              + "</td></tr>"
    + "</table>";

  if (LittleFS.exists(BUFFER_FILE)) {
    File f = LittleFS.open(BUFFER_FILE, "r");
    uint32_t sz = f ? f.size() : 0;
    if (f) f.close();
    uint32_t pos = loadBufPos();
    html += "<p><b>Buffered: " + String((sz - pos) / 50) +
            " est. readings (" + String((sz - pos) / 1024) + " KB pending)</b></p>";
  }

  html += "<p style='color:#aaa;font-size:0.8rem'>Page auto-refreshes every 5 s</p>";
  http.send(200, "text/html", html);
}

void handleWhoAmI() {
  // 512. Measured against ArduinoJson 6.21.6: nine members need 256 B with a
  // typical hub URL and 349 B with the 128-character one the captive portal
  // accepts (P_SERVER_LEN) -- so at 320 this silently DROPPED members on a
  // long-URL deployment. v6 does not error on overflow, it just omits, and the
  // field most likely to go is whichever is added last. This is the endpoint
  // docs/QC_CHECKLIST.md has the factory read `fw_version` from before a unit
  // ships, so a silently missing key there fails a good unit or passes a bad
  // one. See tests/test_firmware_json_capacity.py.
  StaticJsonDocument<512> doc;
  doc["id"]          = g_probeId;
  doc["name"]        = g_instanceName;
  doc["mac"]         = g_chipId;
  doc["ds18b20_rom"] = g_romHex;
  doc["fw_version"]  = FW_VERSION;
  doc["interval_ms"] = cfg_interval;
  doc["resolution_bits"] = cfg_res_bits;
  doc["server_url"]  = cfg_server_url;
  doc["time_valid"]  = g_timeValid;
  sendJSON(200, doc);
}

void handleStatus() {
  // 640. Measured against ArduinoJson 6.21.6, not estimated: the 19 members
  // that can be set at once need 381 B with a typical hub URL and 474 B with
  // the 128-character one the captive portal accepts. At 384 that means a
  // TYPICAL deployment was already within three bytes of the cap and a
  // long-URL one was well over it -- and v6 does not error on overflow, it
  // silently OMITS members, so /status just stopped reporting whichever field
  // did not fit. See tests/test_firmware_json_capacity.py.
  StaticJsonDocument<640> doc;
  doc["id"]          = g_probeId;
  doc["interval_ms"] = cfg_interval;
  doc["resolution_bits"] = cfg_res_bits;
  doc["server_url"]  = cfg_server_url;
  doc["time_valid"]  = g_timeValid;
  if (!isnan(g_lastC)) {
    doc["last_c"]  = g_lastC;
    doc["last_ms"] = g_lastAtMs;
    doc["last_ts"] = nowIso();
  }
  if (LittleFS.exists(BUFFER_FILE)) {
    File f = LittleFS.open(BUFFER_FILE, "r");
    uint32_t sz = f ? f.size() : 0;
    if (f) f.close();
    uint32_t pos = loadBufPos();
    doc["buffered_bytes"]    = sz - pos;
    doc["buffered_est_rows"] = (sz - pos) / 50;
  } else {
    doc["buffered_bytes"]    = 0;
    doc["buffered_est_rows"] = 0;
  }
  doc["fs_total_kb"] = LittleFS.totalBytes() / 1024;
  doc["fs_free_kb"]  = (LittleFS.totalBytes() - LittleFS.usedBytes()) / 1024;
  doc["sleep_mode"]  = g_deepSleepMode ? "deep" : "modem";
  doc["wake_count"]  = rtc_bootCount;
  // Report the limits this probe is actually holding. They are a COPY of the
  // hub's, pushed over provisioning, and a probe that was asleep when they
  // changed keeps the old ones — so the copy has to be inspectable or the drift
  // is invisible from both ends.
  doc["watch_armed"] = watchArmed();
  doc["sample_ms"]   = cfg_sample_ms;
  if (cfg_alert_min_c > WATCH_UNSET_C) doc["alert_min_c"] = cfg_alert_min_c;
  if (cfg_alert_max_c > WATCH_UNSET_C) doc["alert_max_c"] = cfg_alert_max_c;
  doc["in_breach"]   = rtc_inBreach;
  sendJSON(200, doc);
}

void handleProvision() {
  if (http.method() == HTTP_OPTIONS) return handleOptions();
  if (http.method() != HTTP_POST) {
    StaticJsonDocument<64> e; e["ok"] = false; e["error"] = "POST required";
    return sendJSON(405, e);
  }

  // 512, not 256. Under ArduinoJson v6 (the .ino header and firmware/README
  // both say v6 or v7, so v6 has to fit) a StaticJsonDocument is a hard pool
  // cap, and deserializeJson parses the WHOLE body regardless of which keys are
  // read afterwards. Measured against 6.21.6: the documented 7-field body needs
  // 260 B with a typical hub URL and the 32-character token app.py generates --
  // four bytes over the old 256 -- and 385 B at the portal's maximum URL and
  // token. Over the cap deserializeJson returns NoMemory, the handler answers
  // 400 "bad json", and the probe is never provisioned at all.
  // See tests/test_firmware_json_capacity.py.
  StaticJsonDocument<512> doc;
  DeserializationError err = deserializeJson(doc, http.arg("plain"));
  if (err) {
    StaticJsonDocument<64> e; e["ok"] = false; e["error"] = "bad json";
    return sendJSON(400, e);
  }

  String   url      = doc["server_url"] | "";
  String   tok      = doc["token"]      | "";
  uint32_t interval = (uint32_t)(doc["interval_ms"] | cfg_interval);
  // resolution_bits is optional — a hub that doesn't send it leaves ours as-is.
  uint8_t  resBits  = (uint8_t)(doc["resolution_bits"] | cfg_res_bits);

  if (url.length() == 0) {
    StaticJsonDocument<64> e; e["ok"] = false; e["error"] = "server_url required";
    return sendJSON(400, e);
  }

  cfg_server_url = url;
  cfg_token      = tok;
  cfg_interval   = interval < 500 ? 500 : interval;
  if (resBits < 9)  resBits = 9;
  if (resBits > 12) resBits = 12;
  cfg_res_bits   = resBits;

  // The threshold watch, with the same explicit-null-clears semantics
  // applyHubConfig uses (PROTOCOL.md §4.1 requires all three to be persisted
  // here). This handler read four keys and silently dropped these three -- so
  // the hub's PUSH path sent them, the auto-provisioner recorded them as
  // delivered, and the Devices dialog reported the watch as armed, while only
  // the PULL path (the /api/ingest reply) ever actually armed it. A setting
  // that reads as applied and is not is worse than one plainly unavailable.
  if (doc.containsKey("alert_min_c")) cfg_alert_min_c = doc["alert_min_c"] | WATCH_UNSET_C;
  if (doc.containsKey("alert_max_c")) cfg_alert_max_c = doc["alert_max_c"] | WATCH_UNSET_C;
  if (doc.containsKey("sample_ms"))   cfg_sample_ms   = (uint32_t)(doc["sample_ms"] | 0UL);

  saveConfig();
  applyResolution(cfg_res_bits);   // apply the new resolution live
  // Both depend on cfg_interval, which may just have changed.
  g_deepSleepMode = DEEP_SLEEP_ENABLED && (cfg_interval >= DEEP_SLEEP_MIN_MS);
  if (watchArmed()) {
    Serial.printf("[Watch] Armed: min=%.1f max=%.1f every %lu ms\n",
                  cfg_alert_min_c, cfg_alert_max_c, (unsigned long)cfg_sample_ms);
  }

  StaticJsonDocument<160> out;
  out["ok"]          = true;
  out["server_url"]  = cfg_server_url;
  out["interval_ms"] = cfg_interval;
  out["resolution_bits"] = cfg_res_bits;
  sendJSON(200, out);

  // Re-evaluate the sleep mode with the SAME expression setup() uses, so an
  // always-on probe provisioned to an interval >= DEEP_SLEEP_MIN_MS starts
  // deep-sleeping after its next reading — without needing a power cycle. The
  // reverse direction (a deep-sleep probe provisioned to a short interval)
  // resolves naturally on the next wake: setup() recomputes the mode from the
  // freshly persisted config.
  g_deepSleepMode = DEEP_SLEEP_ENABLED && (cfg_interval >= DEEP_SLEEP_MIN_MS);
}

// ============================================================================
// WiFi portal
// ============================================================================
void startConfigPortal() {
  // The setup AP is the per-unit probe id (unique SSID) and is OPEN (no password).
  String apName = g_probeId;

  wm.setClass("invert");
  wm.setTitle(String(SENSOR_NAME) + " (" + FW_VERSION + ")");
  wm.setConfigPortalBlocking(true);
  // Finite portal (power-outage lockout guard): the blocking portal returns
  // after PORTAL_TIMEOUT_S instead of holding the probe hostage forever. The
  // caller decides what happens next — continue offline on saved credentials,
  // or re-open the portal when there are none.
  wm.setConfigPortalTimeout(PORTAL_TIMEOUT_S);
  wm.setParamsPage(true);

  p_server.setValue(cfg_server_url.c_str(), P_SERVER_LEN);
  p_token.setValue (cfg_token.c_str(),      P_TOKEN_LEN);
  char ibuf[12];
  snprintf(ibuf, sizeof(ibuf), "%lu", (unsigned long)cfg_interval);
  p_interval.setValue(ibuf, P_INTERVAL_LEN);

  // Parameters were registered once in setup() — do NOT re-add here.

  Serial.println("[WiFi] Starting config portal...");
  ledBlink(2, 50, 100);

  if (wm.startConfigPortal(apName.c_str())) {   // open AP (no password)
    cfg_server_url = String(p_server.getValue());
    cfg_token      = String(p_token.getValue());
    cfg_interval   = strtoul(p_interval.getValue(), nullptr, 10);
    if (cfg_interval < 500) cfg_interval = 500;
    saveConfig();
    Serial.println("[WiFi] Portal saved & connected.");
    Serial.print("[WiFi] IP: "); Serial.println(WiFi.localIP());
    ledBlink(3, 120, 120);
  } else {
    Serial.printf("[WiFi] Portal closed without connection (timeout %lus).\n",
                  (unsigned long)PORTAL_TIMEOUT_S);
  }
}

// ============================================================================
// Identity helpers
// ============================================================================
String chipIdHex() {
  uint32_t lo = (uint32_t)(ESP.getEfuseMac() & 0xFFFFFFFFULL);
  char buf[9]; snprintf(buf, sizeof(buf), "%08X", lo);
  return String(buf);
}

String ds18b20RomHex() {
  DeviceAddress addr;
  if (!sensors.getAddress(addr, 0)) return "";
  char buf[17];
  for (int i = 0; i < 8; i++) sprintf(buf + i * 2, "%02X", addr[i]);
  buf[16] = '\0';
  return String(buf);
}

String buildProbeId(const String& rom, const String& chip) {
  // "Setpoint-<HEX6>": 6 uppercase hex, wide enough that a manufacturing
  // batch won't collide. Derived from the DS18B20 ROM (globally unique) when the
  // sensor reads, else from the chip's efuse MAC. Persisted by stableProbeId().
  String hex;
  if (rom.length() >= 6)  hex = rom.substring(rom.length() - 6);
  else if (chip.length() >= 6) hex = chip.substring(chip.length() - 6);
  else hex = (rom.length() ? rom : chip);
  hex.toUpperCase();
  return "Setpoint-" + hex;
}

// Read the DS18B20 ROM with a few retries.  On a cold boot the 1-Wire bus can
// need a moment to settle; without this the first read sometimes fails and the
// probe id would fall back to the (different) chip-based name.
String ds18b20RomHexRetry() {
  for (uint8_t i = 0; i < 5; i++) {
    String rom = ds18b20RomHex();
    if (rom.length()) return rom;
    sensors.begin();          // re-enumerate the bus, then retry
    delay(50);
  }
  return "";
}

// Return a STABLE probe id that never changes for the life of the device.
// The first id we ever derive (ROM-based when the sensor reads, else chip-based)
// is persisted to NVS and reused on every subsequent boot, so a later failed
// ROM read cannot flip the identity and make the hub show one probe as two.
String stableProbeId(const String& rom, const String& chip) {
  String saved;
  if (prefs.begin("tscfg", true)) {
    saved = prefs.getString("probe_id", "");
    prefs.end();
  }
  if (saved.length()) return saved;          // identity already established

  String id = buildProbeId(rom, chip);
  if (prefs.begin("tscfg", false)) {
    prefs.putString("probe_id", id);
    prefs.end();
  }
  return id;
}

// ============================================================================
// Deep sleep
// ============================================================================

// Stay awake, keep Wi-Fi up, sample fast and flush the offline buffer for
// BURST_WINDOW_MS, then return so the caller can deep-sleep. Called from the
// deep-sleep path when a wake reading shows a rapid change (e.g. a freezer door
// opened) so the event AND any buffered backlog reach the hub during the
// connectivity window the disturbance opened. A closed freezer is an RF box, so
// this also retries the Wi-Fi association: the door opening may be the first
// real chance to connect.
void runDisturbanceBurst() {
  Serial.printf("[Burst] Disturbance detected — staying awake %lus to flush.\n",
                (unsigned long)(BURST_WINDOW_MS / 1000UL));
  ledBlink(1, 40, 0);
  unsigned long burstEnd   = millis() + BURST_WINDOW_MS;
  unsigned long lastSample = 0;

  while (millis() < burstEnd) {
    http.handleClient();

    if (WiFi.status() != WL_CONNECTED) {
      WiFi.begin();
      unsigned long t0 = millis();
      while (WiFi.status() != WL_CONNECTED && millis() - t0 < 4000UL) {
        http.handleClient();
        delay(50);
      }
      if (WiFi.status() == WL_CONNECTED) { rtc_wifiFailStreak = 0; mdnsAdvertise(); }
    }
    if (WiFi.status() == WL_CONNECTED) bufferFlush();

    if (millis() - lastSample >= BURST_SAMPLE_MS) {
      lastSample = millis();
      sensors.requestTemperatures();
      delay(g_convMs + 5);
      float tC = sensors.getTempCByIndex(0);
      if (tC != DEVICE_DISCONNECTED_C) {
        float  tF = DallasTemperature::toFahrenheit(tC);
        String ts = nowIso();
        g_lastC          = tC;
        g_lastAtMs       = millis();
        rtc_lastReadingC = tC;   // keep the across-sleep baseline current
        if (WiFi.status() == WL_CONNECTED) {
          if (!postWithTimestamp(ts, tC, tF, g_probeId)) bufferAppend(ts, tC, tF);
        } else {
          bufferAppend(ts, tC, tF);
        }
      }
    }
    delay(10);
  }
  Serial.println("[Burst] Window elapsed — returning to deep sleep.");
}

// Persist time, power down WiFi and mDNS, then deep-sleep for durationMs ms.
// On wakeup the ESP32 runs setup() again from the top; the wakeup cause will
// be ESP_SLEEP_WAKEUP_TIMER so setup() takes the fast-reconnect path.
void enterDeepSleep(uint32_t durationMs) {
  // Last-chance NTP poll: an async SNTP answer that landed during this wake
  // must promote g_timeValid / rtc_timeValid (and zero the drift-resync
  // counter) BEFORE the clock is checkpointed below.
  ntpService(WiFi.status() == WL_CONNECTED);

  rtc_sleepMs = durationMs;

  Serial.printf("[Sleep] Deep sleep %.1f s  (next wake #%u)\n",
                durationMs / 1000.0f, rtc_bootCount + 1);
  Serial.flush();

  http.stop();
  MDNS.end();
  WiFi.disconnect(true);
  delay(20);

  // Checkpoint the pre-sleep instant to MILLISECOND precision so setup() can
  // restore system time on wake without an NTP round-trip. The old
  // whole-second time(nullptr) checkpoint truncated up to ~1 s per cycle,
  // and that drift compounded across the hundreds of wakes between resyncs.
  //
  // Taken LAST, immediately before the timer is armed. It used to be taken at
  // the top of this function, so everything below it — the Serial.flush(), the
  // HTTP/mDNS teardown, WiFi.disconnect() and its 20 ms settle — elapsed after
  // the recorded instant but before the sleep timer started, and setup()'s
  // `rtc_epochMsAtSleep + rtc_sleepMs + millis()` never accounted for it. The
  // clock therefore ran SLOW by that shutdown tail every single wake, in one
  // direction, so it accumulated rather than averaging out.
  //
  // Bounded to ~30 wakes while the probe is online (NTP_RESYNC_INTERVAL), but a
  // resync needs a CONNECTED wake — so through a router outage or a hub that is
  // down, which is exactly when readings are being buffered and their stamps are
  // the only record of when they were taken, it free-ran.
  struct timeval tv;
  gettimeofday(&tv, nullptr);
  rtc_epochMsAtSleep = (int64_t)tv.tv_sec * 1000LL + (int64_t)(tv.tv_usec / 1000L);

  esp_sleep_enable_timer_wakeup((uint64_t)durationMs * 1000ULL);
  esp_deep_sleep_start();
  // never reached
}

// ============================================================================
void setup() {
  g_wakeStart = millis();
  ledInit();
  Serial.begin(115200);
  delay(150);

  // ── Detect wakeup source ──────────────────────────────────────────────────
  esp_sleep_wakeup_cause_t wakeupCause = esp_sleep_get_wakeup_cause();
  bool fromDeepSleep = (wakeupCause == ESP_SLEEP_WAKEUP_TIMER);
  rtc_bootCount++;
  // Drift-resync accounting: count wakes since the last SUCCESSFUL NTP sync
  // (ntpService() zeroes this when a sync completes). Once it reaches
  // NTP_RESYNC_INTERVAL, the next CONNECTED wake kicks an async resync.
  if (fromDeepSleep) rtc_wakesSinceSync++;

  Serial.printf("\n%s FW %s  wake #%u (%s)\n",
                SENSOR_NAME, FW_VERSION, rtc_bootCount,
                fromDeepSleep ? "deep-sleep timer" : "cold boot / reset");

  loadConfig();

  // DS18B20: 9-bit, non-blocking
  sensors.begin();
  applyResolution(cfg_res_bits);   // sets sensor resolution + matching g_convMs
  sensors.setWaitForConversion(false);
  Serial.printf("DS18B20 sensors found: %d (res %u-bit)\n",
                sensors.getDeviceCount(), cfg_res_bits);

  // Cache identity strings.  The probe id is derived once and persisted, so it
  // stays stable across reboots even if a later DS18B20 ROM read fails.
  g_chipId       = chipIdHex();
  g_romHex       = ds18b20RomHexRetry();
  g_probeId      = stableProbeId(g_romHex, g_chipId);
  g_instanceName = g_probeId;                 // mDNS / setup-AP SSID == probe id
  Serial.printf("Probe ID:  %s\n", g_probeId.c_str());
  // Machine-readable line for factory_flash.py: id + setup-AP SSID (== id). The
  // setup AP is open (no password), so there is no key to record.
  Serial.printf("[label] probe_id=%s ap_ssid=%s ap_pass=none\n",
                g_probeId.c_str(), g_probeId.c_str());

  // Mount LittleFS — format on first use (takes ~2 s, one-time only)
  if (!LittleFS.begin(true)) {
    Serial.println("[LittleFS] Mount failed — offline buffer disabled.");
  } else {
    Serial.printf("[LittleFS] Mounted. Total: %u KB  Used: %u KB\n",
                  LittleFS.totalBytes() / 1024, LittleFS.usedBytes() / 1024);
    if (LittleFS.exists(BUFFER_FILE)) {
      File f = LittleFS.open(BUFFER_FILE, "r");
      uint32_t sz = f ? f.size() : 0;
      if (f) f.close();
      uint32_t pos = loadBufPos();
      Serial.printf("[Buffer] Pending: ~%u readings (%u KB)\n",
                    (sz - pos) / 50, (sz - pos) / 1024);
    }
  }

  // ── Clock restore (BEFORE Wi-Fi — timestamps must not depend on the radio) ─
  // Restore the clock from the RTC checkpoint FIRST. The ESP32 RTC timer keeps
  // running through deep sleep, so a probe that wakes during a Wi-Fi / router
  // outage still carries a valid timestamp — so its buffered readings keep
  // measurement-time chronology rather than falling back to the hub's
  // receipt-stamping (which bufferAppend now relies on only when the clock has
  // never synced at all). The pre-sleep instant was saved to
  // MILLISECOND precision; adding the programmed sleep length plus the
  // milliseconds since this boot started reconstructs "now" without the old
  // whole-second truncation that drifted the clock by up to ~1 s per wake.
  //
  // One interval is still unaccounted: the ROM and second-stage bootloader run
  // before millis() starts counting, so each wake loses that (~100-300 ms on an
  // ESP32-C3) and the clock runs slow by it. Like the shutdown tail that
  // enterDeepSleep() used to lose, it is one-directional and accumulates.
  // Measuring it needs the continuously-running RTC tick counter rather than
  // millis(), which is a change worth making on a bench where the result can be
  // checked against a reference clock — not blind. While the probe is online an
  // NTP resync every NTP_RESYNC_INTERVAL wakes bounds it; through an outage it
  // does not, which is the case that matters, so it is written down here rather
  // than left as folklore.
  if (fromDeepSleep && rtc_timeValid && rtc_epochMsAtSleep > 0) {
    int64_t nowMs = rtc_epochMsAtSleep + (int64_t)rtc_sleepMs + (int64_t)millis();
    struct timeval tv;
    tv.tv_sec  = (time_t)(nowMs / 1000);
    tv.tv_usec = (suseconds_t)((nowMs % 1000) * 1000);
    settimeofday(&tv, nullptr);
    g_timeValid = true;
    Serial.printf("[Time] Restored from RTC: %s\n", nowIso().c_str());
  }

  // ── WiFi ──────────────────────────────────────────────────────────────────
  if (fromDeepSleep) {
    // Fast reconnect path: skip the WiFiManager portal.  WiFiManager saves
    // credentials into the ESP32 WiFi NVS so WiFi.begin() (no args) reconnects
    // to the same network as before.
    //
    // Backoff: a probe that keeps failing to associate (deep in a freezer, hub
    // down) must not power its radio for a full connect attempt every single
    // wake. Once the failure streak passes WIFI_FAIL_BACKOFF_AFTER, only attempt
    // a connect every WIFI_FAIL_BACKOFF_EVERY-th wake — the rest read+buffer with
    // the radio off. (A disturbance burst in loop() still forces a reconnect
    // regardless, since a door-open is exactly when the network may return.)
    bool skipConnect = (rtc_wifiFailStreak >= WIFI_FAIL_BACKOFF_AFTER) &&
                       (rtc_bootCount % WIFI_FAIL_BACKOFF_EVERY != 0);
    // Threshold watch: this is a SAMPLE-only wake — read the sensor with the
    // radio off and go back to sleep, unless the reading turns out to have
    // crossed a limit, in which case loop() powers the radio up then. Skipping
    // the association is the entire saving; the read itself was never the cost.
    g_sampleOnlyWake = watchArmed() && (rtc_msSinceReport + cfg_sample_ms / 2 < cfg_interval);
    if (g_sampleOnlyWake) {
      skipConnect = true;
      Serial.printf("[Watch] Sample wake (%lu/%lu ms into the report interval) — radio off.\n",
                    (unsigned long)rtc_msSinceReport, (unsigned long)cfg_interval);
    }
    if (skipConnect) {
      if (!g_sampleOnlyWake) {
        Serial.printf("[WiFi] Backoff (%u consecutive fails) — radio stays off this wake.\n",
                      rtc_wifiFailStreak);
      }
    } else {
      WiFi.mode(WIFI_STA);
      WiFi.begin();
      Serial.print("[WiFi] Reconnecting (deep-sleep wake)...");
      uint32_t t0 = millis();
      while (WiFi.status() != WL_CONNECTED && millis() - t0 < WIFI_CONNECT_MS) {
        delay(100);
      }
      if (WiFi.status() == WL_CONNECTED) {
        Serial.printf(" OK (%lu ms)  IP: %s\n",
                      millis() - t0, WiFi.localIP().toString().c_str());
        g_wasConnected = true;
        rtc_wifiFailStreak = 0;
      } else {
        rtc_wifiFailStreak++;
        Serial.printf(" FAILED (streak %u) — reading will be buffered.\n", rtc_wifiFailStreak);
      }
    }
  } else {
    // Cold boot (power-on / recharge). WiFiManager parameters are registered so
    // the setup portal — opened ONLY when there are no saved credentials —
    // carries the current values.
    WiFi.mode(WIFI_STA);
    wm.setConfigPortalTimeout(PORTAL_TIMEOUT_S);
    wm.setHostname(SENSOR_NAME);
    wm.addParameter(&p_server);
    wm.addParameter(&p_token);
    wm.addParameter(&p_interval);

    if (wm.getWiFiIsSaved()) {
      // A deployed probe with saved credentials must REJOIN its network, not flip
      // to its own setup AP on a brief miss. After a shared power outage the
      // router is often still booting when the probe wakes, so retry the saved
      // network hard for a grace window before giving up — the old single 20 s
      // autoConnect attempt was too short and left the probe hosting an AP
      // instead of reconnecting.
      Serial.printf("[WiFi] Cold boot, saved network — reconnecting (up to %lus)...\n",
                    (unsigned long)(WIFI_COLD_RECONNECT_MS / 1000UL));
      WiFi.setHostname(SENSOR_NAME);
      WiFi.begin();
      uint32_t t0 = millis();
      while (WiFi.status() != WL_CONNECTED && millis() - t0 < WIFI_COLD_RECONNECT_MS) {
        // (No http.handleClient() here: the web server isn't begun until after
        // this block, and the probe has no IP while still associating, so there
        // is nothing to serve — just wait for the association to complete.)
        delay(250);
      }
      if (WiFi.status() == WL_CONNECTED) {
        Serial.printf("[WiFi] Reconnected in %lu ms. IP: %s\n",
                      millis() - t0, WiFi.localIP().toString().c_str());
        g_wasConnected = true;
        saveColdFail(0);   // network reachable — clear the consecutive-fail count
      } else {
        // Still unreachable after the grace. A transient miss (router still
        // booting after a shared outage) must NOT flip the probe to its own setup
        // AP, so the default is to continue OFFLINE and keep retrying: readings
        // are buffered and Wi-Fi reconnects in loop()'s watchdog (always-on) or on
        // the next wake (deep sleep), exactly like a mid-run outage. The STA is
        // already retrying in the background from the WiFi.begin() above.
        uint32_t coldFails = loadColdFail() + 1;
        saveColdFail(coldFails);
        if (coldFails >= COLD_FAIL_PORTAL_AFTER) {
          // The saved network has been unreachable across this many consecutive
          // cold boots — a persistent change (new router / SSID / relocation),
          // not a passing outage. Open the setup portal ONCE so the probe can be
          // re-pointed instead of being stranded offline until a USB re-flash.
          // Bounded by PORTAL_TIMEOUT_S; returns whether or not anyone connects.
          Serial.printf("[WiFi] Saved network unreachable on %u consecutive cold boots — "
                        "opening setup portal for reconfiguration.\n", coldFails);
          startConfigPortal();
          if (WiFi.status() == WL_CONNECTED) {
            g_wasConnected = true;
            saveColdFail(0);        // reconfigured/reconnected — clear the count
          } else {
            // No one reconfigured it; resume the background STA retry (the portal
            // took the radio into AP mode) and leave the count set so the next
            // cold boot offers setup again.
            WiFi.mode(WIFI_STA);
            WiFi.begin();
          }
        } else {
          Serial.printf("[WiFi] Saved network still unreachable (cold-boot streak %u/%u) — "
                        "continuing OFFLINE, will keep retrying.\n",
                        coldFails, (unsigned)COLD_FAIL_PORTAL_AFTER);
        }
      }
    } else {
      // No saved credentials: genuine first-time setup. Open the per-unit OPEN
      // setup AP (SSID == the probe id, e.g. Setpoint-9A3F2C) in a LOOP, each
      // round bounded by PORTAL_TIMEOUT_S, until configured — never a single
      // infinite hard-block.
      while (WiFi.status() != WL_CONNECTED && !wm.getWiFiIsSaved()) {
        Serial.println("[WiFi] No known network; opening setup portal.");
        p_server.setValue(cfg_server_url.c_str(), P_SERVER_LEN);
        p_token.setValue (cfg_token.c_str(),      P_TOKEN_LEN);
        char ibuf[12];
        snprintf(ibuf, sizeof(ibuf), "%lu", (unsigned long)cfg_interval);
        p_interval.setValue(ibuf, P_INTERVAL_LEN);
        startConfigPortal();
      }
      if (WiFi.status() == WL_CONNECTED) {
        Serial.print("[WiFi] Connected. IP: ");
        Serial.println(WiFi.localIP());
        g_wasConnected = true;
      }
    }
  }

  // ── Decide sleep mode for this cycle ──────────────────────────────────────
  g_deepSleepMode = DEEP_SLEEP_ENABLED && (cfg_interval >= DEEP_SLEEP_MIN_MS);

  // In always-on (non-deep-sleep) mode enable WiFi modem sleep so the radio
  // powers down between DTIM beacons, saving ~100–150 mA during idle without
  // affecting HTTP responsiveness.
  if (!g_deepSleepMode) {
    WiFi.setSleep(true);
  }

  // ── NTP / time ────────────────────────────────────────────────────────────
  // (The RTC clock restore already ran, before the Wi-Fi block above.)
  if (WiFi.status() == WL_CONNECTED) {
    // Online housekeeping: start/refresh NTP, advertise, flush the buffer.
    if (!g_timeValid) {
      // Never synced (cold boot, or RTC state lost): start the ASYNC SNTP
      // query. Only a cold boot waits — briefly and bounded — so the very
      // first readings can carry real stamps when NTP answers quickly; a
      // deep-sleep wake never blocks (ntpService() polls validity instead).
      ntpKick();
      if (!fromDeepSleep) {
        Serial.print("[NTP] Cold boot — bounded wait for first sync...");
        uint32_t t0 = millis();
        while (!clockLooksValid() && millis() - t0 < NTP_COLDBOOT_WAIT_MS) delay(50);
        Serial.println(clockLooksValid() ? " OK" : " pending (async retries continue).");
      }
      ntpService(true);   // promote immediately if the sync already landed
    } else if (ntpResyncDue()) {
      // Clock is RTC-carried and a drift resync is due — kick it ASYNC. The
      // wake never waits on it; ntpService() zeroes the counter once the sync
      // completes (polled in loop() and again just before deep sleep).
      Serial.printf("[NTP] Drift resync due (%u wakes / ~%lu s since last sync).\n",
                    (unsigned)rtc_wakesSinceSync,
                    (unsigned long)((uint64_t)rtc_wakesSinceSync * cfg_interval / 1000ULL));
      ntpKick();
    }
    ledBlink(3, 120, 120);
    mdnsAdvertise();
    bufferFlush();
  }

  http.on("/",          HTTP_GET,     handleRoot);
  http.on("/whoami",    HTTP_GET,     handleWhoAmI);
  http.on("/status",    HTTP_GET,     handleStatus);
  http.on("/provision", HTTP_POST,    handleProvision);
  http.on("/provision", HTTP_OPTIONS, handleOptions);
  // NOTE: this must stay AFTER the WiFiManager config portal (autoConnect/
  // startConfigPortal above). During setup WiFiManager owns port 80 (its captive
  // portal) and port 53 (the DNS redirector that makes phones auto-pop the setup
  // page). Starting our own server here before the portal closes would clash on
  // port 80 and break the captive-portal auto-redirect.
  http.begin();

  // In deep-sleep mode take the reading on the very first loop() iteration.
  // Standard unsigned-arithmetic trick: (millis() - g_lastSend) will equal
  // cfg_interval on the first call even if millis() < cfg_interval.
  if (g_deepSleepMode) {
    g_lastSend = millis() - cfg_interval;
  }

  Serial.printf("[Setup] Ready. Mode: %s  Interval: %u ms\n",
                g_deepSleepMode ? "deep-sleep" : "always-on", cfg_interval);
}

// True when the deep-sleep HTTP window should be served this wake: always for the
// first few wakes (so the hub can auto-provision a freshly-appeared probe), then
// only periodically — reclaiming ~3 s of awake-time on every other wake.
bool webserverWindowDue() {
  return rtc_bootCount <= WEBSERVER_WARMUP_WAKES
      || (rtc_bootCount % WEBSERVER_WINDOW_EVERY == 0);
}

// ============================================================================
void loop() {
  http.handleClient();

  unsigned long now       = millis();
  bool          connected = (WiFi.status() == WL_CONNECTED);

  // ── Non-blocking NTP upkeep (both modes) ─────────────────────────────────
  // Promotes time-validity the moment the async SNTP answer lands, accounts a
  // completed drift resync, and re-kicks the query with backoff (60 s -> 5 min
  // cap) while the clock is unset. Never blocks.
  ntpService(connected);

  // ── WiFi watchdog & buffer retry (always-on mode only) ───────────────────
  // In deep-sleep mode we reconnect fresh in setup() every cycle, so these
  // continuous watchdog tasks are not needed.
  if (!g_deepSleepMode) {
    if (!connected) {
      if (g_wasConnected) {
        Serial.println("[WiFi] Connection lost — readings will be buffered.");
        g_wasConnected = false;
      }
      static unsigned long lastReconnAt = 0;
      if (now - lastReconnAt >= 5000) {
        Serial.println("[WiFi] Attempting reconnect...");
        WiFi.reconnect();
        lastReconnAt = now;
      }
      // Fall through — still take readings and buffer them while offline
    }

    if (connected && !g_wasConnected) {
      Serial.print("[WiFi] Reconnected. IP: ");
      Serial.println(WiFi.localIP());
      g_wasConnected = true;
      if (!g_timeValid) {
        // Fresh network — kick SNTP immediately and restart the retry backoff
        // (ntpService() above handles promotion + subsequent retries).
        g_ntpBackoffMs = NTP_BACKOFF_MIN_MS;
        ntpKick();
      }
      mdnsAdvertise();
      g_lastFlushAt = now;
      bufferFlush();
    }

    // Periodic buffer retry (stops on first failed POST, retries here every 30 s)
    if (connected && LittleFS.exists(BUFFER_FILE) &&
        (now - g_lastFlushAt >= 30000UL)) {
      g_lastFlushAt = now;
      bufferFlush();
    }
  }

  // ── Phase 1: kick off a non-blocking DS18B20 conversion ───────────────────
  if (!g_convPending && (now - g_lastSend >= cfg_interval)) {
    sensors.requestTemperatures();
    g_convReqAt   = now;
    g_convPending = true;
    g_lastSend    = now;
  }

  // ── Phase 2: read result once the conversion window has elapsed ───────────
  if (g_convPending && (now - g_convReqAt >= g_convMs)) {
    g_convPending = false;
    float tC = sensors.getTempCByIndex(0);

    // Retry a bad read a couple of times before declaring a fault: a transient
    // 1-Wire glitch reads as DEVICE_DISCONNECTED_C, and dropping the whole
    // reading over one blip leaves a gap in the log. Only the error path blocks
    // (the normal successful read never enters this loop).
    for (uint8_t attempt = 0; tC == DEVICE_DISCONNECTED_C && attempt < DS_READ_RETRIES; attempt++) {
      sensors.requestTemperatures();
      delay(g_convMs + 5);
      tC = sensors.getTempCByIndex(0);
    }

    if (tC == DEVICE_DISCONNECTED_C) {
      Serial.println("[Temp] Sensor disconnected — reinitialising bus...");
      sensors.begin();
      sensors.setResolution(cfg_res_bits);
      sensors.setWaitForConversion(false);
      ledBlink(2, 60, 160);

      if (g_deepSleepMode) {
        // Sleep even on error; the sensor will be retried on next wake. Keep
        // charging the report interval, or a spell of bad reads would leave the
        // clock stopped and the first good reading would look overdue by
        // however long the fault lasted.
        //
        // nextSleepMs, not a flat cfg_interval: with the watch armed the retry
        // belongs at the SAMPLE cadence. DS_READ_RETRIES spans about 800 ms, so
        // any 1-Wire glitch lasting a second -- the marginal pull-up, the long
        // lead, the EMI this branch exists for -- fell through to here and
        // stopped the probe looking at a freezer for a full report interval.
        // The flat value also over-charged rtc_msSinceReport on top of progress
        // already accrued, pushing the next report up to an interval late.
        unsigned long elapsed = millis() - g_wakeStart;
        uint32_t sleepMs = nextSleepMs(elapsed, 1000UL, true);
        rtc_msSinceReport += (uint32_t)elapsed + sleepMs;
        enterDeepSleep(sleepMs);
      }
      return;
    }

    float  tF = DallasTemperature::toFahrenheit(tC);
    String ts = nowIso();
    g_lastC    = tC;
    g_lastAtMs = now;

    // Disturbance detection for the deep-sleep burst: compare this reading to the
    // previous one carried across sleep in RTC memory. An abrupt change in either
    // direction (freezer door open = rise, compressor kick = fall) counts.
    const float burstDelta = burstDeltaC();
    bool disturbance = BURST_ON_DISTURBANCE && burstDelta > 0.0f
                       && rtc_lastReadingC > -900.0f
                       && fabsf(tC - rtc_lastReadingC) >= burstDelta;
    rtc_lastReadingC = tC;

    // ── Threshold watch: does this reading justify the radio? ──────────────
    // Only the TRANSITIONS are worth an unscheduled transmission. Entering an
    // excursion is the alert; leaving it is the all-clear, and is worth just as
    // much because until it arrives the hub is still telling someone their
    // freezer is warm. Sitting in breach reports on the normal interval — the
    // hub's own re-alert cooldown handles repetition, and a probe parked past
    // its limit must not transmit every sample.
    bool watchReport = false;
    if (watchArmed()) {
      const bool breach = outsideLimits(tC);
      if (breach != rtc_inBreach) {
        watchReport = true;
        Serial.printf("[Watch] %s at %.2f C (limits %.1f..%.1f) — reporting now.\n",
                      breach ? "BREACH" : "Recovered", tC,
                      cfg_alert_min_c, cfg_alert_max_c);
      }
      rtc_inBreach = breach;
    }
    // A sample wake reports only on a transition; a scheduled wake always does.
    const bool doReport = watchReport || !g_sampleOnlyWake;

    // The radio was left off for this wake, but the reading turned out to
    // matter. Power it up now — this is the whole point of sampling cheaply.
    if (doReport && g_sampleOnlyWake && WiFi.status() != WL_CONNECTED) {
      WiFi.mode(WIFI_STA);
      WiFi.begin();
      uint32_t t0 = millis();
      while (WiFi.status() != WL_CONNECTED && millis() - t0 < WIFI_CONNECT_MS) delay(50);
      if (WiFi.status() == WL_CONNECTED) {
        rtc_wifiFailStreak = 0;
        Serial.printf("[Watch] Radio up in %lu ms to deliver the excursion.\n", millis() - t0);
      } else {
        rtc_wifiFailStreak++;
        Serial.println("[Watch] Could not associate — excursion buffered, goes with the next report.");
      }
      connected = (WiFi.status() == WL_CONNECTED);
    }

    if (!doReport) {
      // Cheap path: keep the reading on flash and sleep again. It is not lost —
      // the next report flushes the buffer, so the hub gets the fine-grained
      // history too, at no extra radio cost.
      bufferAppend(ts, tC, tF);
    } else if (connected) {
      if (postWithTimestamp(ts, tC, tF, g_probeId)) {
        ledOn(); delay(20); ledOff();
        // Report delivered: restart the interval, and push up the samples taken
        // with the radio off since the last one so the hub has the fine history
        // too. This is the flush that makes cheap sampling free to the hub.
        rtc_msSinceReport = 0;
        if (watchArmed() && LittleFS.exists(BUFFER_FILE)) bufferFlush();
      } else {
        // POST failed (hub unreachable?) — fall through to buffer
        Serial.println("[POST] Failed — buffering reading.");
        bufferAppend(ts, tC, tF);
        ledBlink(2, 80, 120);
      }
    } else {
      // Offline: store to flash
      bufferAppend(ts, tC, tF);
      ledBlink(2, 80, 120);
    }

    // ── Deep sleep ────────────────────────────────────────────────────────
    if (g_deepSleepMode) {
      // A disturbance (e.g. the freezer door just opened) means an event worth
      // capturing AND a likely connectivity window — stay awake to flush it all
      // before sleeping. But cap consecutive bursts (battery guard): once the
      // streak hits BURST_MAX_CONSECUTIVE the burst is suppressed until a settled
      // wake re-arms it, so a door held open (or a slow thaw) can't keep the
      // probe awake indefinitely. Otherwise keep the HTTP server live for the
      // short provisioning window — but only when it's due (first wakes + every
      // Nth), not on every wake, reclaiming that awake-time the rest of the time.
      bool doBurst = disturbance && rtc_burstStreak < BURST_MAX_CONSECUTIVE;
      if (doBurst) {
        rtc_burstStreak++;
        runDisturbanceBurst();
      } else {
        if (disturbance) {
          Serial.printf("[Burst] Suppressed — %u consecutive bursts hit the cap (battery guard).\n",
                        rtc_burstStreak);
        } else {
          rtc_burstStreak = 0;   // a settled wake re-arms the burst
        }
        if (connected && webserverWindowDue()) {
          unsigned long windowEnd = millis() + WEBSERVER_WINDOW_MS;
          while (millis() < windowEnd) {
            http.handleClient();
            delay(5);
          }
        }
      }

      // Sleep for the remainder of the interval.
      // After a burst the whole interval (and more) has usually elapsed — sleep
      // a FULL cfg_interval then: the burst already logged the event at high
      // rate, and the old collapsed 100 ms floor doubled the wake rate exactly
      // when the battery was being hit hardest.
      // Otherwise, unsigned arithmetic: if elapsed > cfg_interval we sleep
      // 100 ms minimum to avoid a tight reboot loop.
      unsigned long elapsed = millis() - g_wakeStart;
      uint32_t sleepMs;
      if (doBurst && !watchArmed()) {
        // v2.7.0 battery guard, for the UNARMED case only. After a burst the
        // whole interval has usually elapsed, and the old collapsed 100 ms
        // floor doubled the wake rate exactly when the battery was being hit
        // hardest. With the watch armed it must not win: the operator asked for
        // a check every cfg_sample_ms, and a burst is when that matters most --
        // the probe was going quiet for a full report interval immediately
        // after detecting a disturbance. A sample wake keeps the radio off, so
        // the cost is a conversion, not an association, and
        // BURST_MAX_CONSECUTIVE still caps repeats.
        sleepMs = cfg_interval;
      } else {
        // floorMs = cfg_sample_ms on the burst exit. runDisturbanceBurst runs
        // for BURST_WINDOW_MS (20 s), so `elapsed` already exceeds any ordinary
        // sample cadence and the generic 100 ms floor would fire -- waking the
        // probe a tenth of a second after twenty seconds of radio, which is the
        // collapsed floor the v2.7.0 guard exists to prevent, arrived at from
        // the other side.
        sleepMs = nextSleepMs(elapsed,
                              doBurst ? cfg_sample_ms : 100UL, false);
      }
      // Charge this whole wake — the sleep AND the time spent awake — against
      // the report interval. Counting only the sleep would let the interval
      // drift longer by however long each wake took, and a 15-minute report
      // would quietly become 16.
      rtc_msSinceReport += (uint32_t)elapsed + sleepMs;
      enterDeepSleep(sleepMs);
      // never reached
    }
  }
}
