tallen5431/Temperature_Sensor_V2/tests/firmware/watch_logic_test.cpp

// Extracts the pure decision logic added to esp32_temp_probe.ino and exercises
// it on the host. This is the part of a firmware change that can be verified
// without a probe: the arithmetic and the state machine. Radio behaviour, power
// draw and NVS wear still need the bench.
#include <cstdio>
#include <cstdint>
#include <cassert>
#include <initializer_list>

// ---- verbatim from the .ino -------------------------------------------------
static const float    WATCH_UNSET_C       = -999.0f;
static const float    WATCH_HYSTERESIS_C  = 0.5f;
static const uint32_t WATCH_SAMPLE_MIN_MS = 5000UL;

float    cfg_alert_min_c = WATCH_UNSET_C;
float    cfg_alert_max_c = WATCH_UNSET_C;
uint32_t cfg_sample_ms   = 0;
uint32_t cfg_interval    = 5000;
bool     rtc_inBreach    = false;
uint32_t rtc_msSinceReport = 0;

static bool watchArmed() {
  bool haveLimit = (cfg_alert_min_c > WATCH_UNSET_C) || (cfg_alert_max_c > WATCH_UNSET_C);
  return haveLimit && cfg_sample_ms >= WATCH_SAMPLE_MIN_MS && cfg_sample_ms < cfg_interval;
}

static bool outsideLimits(float tC) {
  const float slack = rtc_inBreach ? WATCH_HYSTERESIS_C : 0.0f;
  if (cfg_alert_max_c > WATCH_UNSET_C && tC > cfg_alert_max_c - slack) return true;
  if (cfg_alert_min_c > WATCH_UNSET_C && tC < cfg_alert_min_c + slack) return true;
  return false;
}

// The watchArmed() branch of the deep-sleep duration, from the bottom of loop().
// This decides how often the probe wakes, which is battery life, and how late a
// report lands. It had no test at all.
static uint32_t watchSleepMs(uint32_t elapsed) {
  uint32_t untilReport = rtc_msSinceReport < cfg_interval
                         ? cfg_interval - rtc_msSinceReport : 0UL;
  uint32_t gap = cfg_sample_ms < untilReport ? cfg_sample_ms : untilReport;
  if (untilReport == 0UL) gap = cfg_sample_ms;   // report just fired
  return gap > elapsed ? (gap - elapsed) : 100UL;
}

// The whole sleep decision, not just the armed branch. Every exit from loop()
// goes through this in the firmware -- including the two that used to answer a
// flat cfg_interval and so blinded an armed watch for a full report interval:
// the DS18B20 fault path, and the wake after a disturbance burst.
static uint32_t nextSleepMs(unsigned long elapsed, uint32_t floorMs,
                            bool reportCadenceWhenOverdue) {
  if (watchArmed()) {
    uint32_t untilReport = rtc_msSinceReport < cfg_interval
                           ? cfg_interval - rtc_msSinceReport : 0UL;
    uint32_t gap = cfg_sample_ms < untilReport ? cfg_sample_ms : untilReport;
    if (untilReport == 0UL) {
      if (reportCadenceWhenOverdue) {
        return cfg_interval > (uint32_t)elapsed
               ? (uint32_t)(cfg_interval - elapsed) : floorMs;
      }
      gap = cfg_sample_ms;                          // report just fired
    }
    return gap > (uint32_t)elapsed ? (uint32_t)(gap - elapsed) : floorMs;
  }
  // Unsigned arithmetic: if elapsed > cfg_interval, sleep a 100 ms minimum
  // rather than wrapping into a tight reboot loop.
  return cfg_interval > (uint32_t)elapsed
         ? (uint32_t)(cfg_interval - elapsed) : 100UL;
}

// From setup(): whether this wake reads the sensor with the radio off, or is the
// scheduled report. The half-sample bias makes the LAST sample before a deadline
// report instead of sampling and then waking again a few hundred ms later.
static bool sampleOnlyWake() {
  return watchArmed() && (rtc_msSinceReport + cfg_sample_ms / 2 < cfg_interval);
}
// ---- end verbatim -----------------------------------------------------------

static int failures = 0;
#define CHECK(cond, msg) do { if(!(cond)) { printf("  FAIL: %s\n", msg); failures++; } } while(0)

// Feed a temperature through the same transition test loop() uses.
// Returns true when this reading would trigger an unscheduled transmission.
static bool step(float tC) {
  bool breach = outsideLimits(tC);
  bool transition = (breach != rtc_inBreach);
  rtc_inBreach = breach;
  return transition;
}

int main() {
  printf("arming\n");
  cfg_interval = 900000; cfg_sample_ms = 0;
  cfg_alert_min_c = WATCH_UNSET_C; cfg_alert_max_c = WATCH_UNSET_C;
  CHECK(!watchArmed(), "no limits must not arm");
  cfg_alert_max_c = -15.0f;
  CHECK(!watchArmed(), "limit but no sample cadence must not arm");
  cfg_sample_ms = 60000;
  CHECK(watchArmed(), "limit + shorter sample cadence must arm");
  cfg_sample_ms = 900000;
  CHECK(!watchArmed(), "sample cadence == report interval is pointless, must not arm");
  cfg_sample_ms = 1000;
  CHECK(!watchArmed(), "sample cadence below the floor must not arm");
  cfg_sample_ms = 60000;

  printf("a freezer thawing slowly (limit -15)\n");
  rtc_inBreach = false;
  cfg_alert_min_c = WATCH_UNSET_C; cfg_alert_max_c = -15.0f;
  float slow[] = {-18.0f, -17.6f, -17.1f, -16.5f, -15.9f, -15.2f, -14.8f, -14.0f, -12.0f};
  int fired = 0, firedAt = -1;
  for (int i = 0; i < 9; i++) if (step(slow[i])) { fired++; firedAt = i; }
  CHECK(fired == 1, "a slow thaw must transmit exactly once, on crossing");
  CHECK(firedAt == 6, "must fire at the first reading past -15.0 (-14.8)");
  printf("  fired once at reading %d (%.1f C)\n", firedAt, slow[firedAt]);

  printf("parked on the limit must not chatter\n");
  rtc_inBreach = false;
  int chatter = 0;
  float jitter[] = {-14.9f, -15.05f, -14.95f, -15.1f, -14.9f, -15.02f};
  for (int i = 0; i < 6; i++) if (step(jitter[i])) chatter++;
  CHECK(chatter == 1, "hysteresis must swallow jitter around the limit");
  printf("  transmissions across 6 jittering samples: %d\n", chatter);

  printf("recovery needs to beat the limit by the deadband\n");
  rtc_inBreach = false;
  CHECK(step(-14.0f), "entering breach fires");
  CHECK(!step(-15.2f), "back inside but within the deadband must NOT clear yet");
  CHECK(step(-15.6f), "clearly recovered must fire the all-clear");
  CHECK(!rtc_inBreach, "state must be clear after recovery");

  printf("a cooler with both limits (0..8)\n");
  rtc_inBreach = false;
  cfg_alert_min_c = 0.0f; cfg_alert_max_c = 8.0f;
  CHECK(!step(4.0f), "in spec, no transmission");
  CHECK(step(8.4f),  "over the top limit fires");
  CHECK(!step(7.7f), "inside the deadband does not clear");
  CHECK(step(7.2f),  "clear of the deadband clears");
  CHECK(step(-0.4f), "under the bottom limit fires");
  CHECK(step(0.8f),  "back above the bottom limit clears");

  printf("a one-sided limit ignores the other end\n");
  rtc_inBreach = false;
  cfg_alert_min_c = WATCH_UNSET_C; cfg_alert_max_c = 8.0f;
  CHECK(!step(-40.0f), "no min limit means arbitrarily cold is not a breach");
  CHECK(step(9.0f), "the max limit still applies");

  // --- how long to sleep, which is battery life and report punctuality ------
  printf("sleeping to the next sample, but never past the report\n");
  cfg_interval = 900000; cfg_sample_ms = 60000;
  const uint32_t awake = 300;

  rtc_msSinceReport = 0;
  CHECK(watchSleepMs(awake) == 60000 - awake, "a full sample gap when the report is far off");

  rtc_msSinceReport = 840000;                     // exactly one sample to go
  CHECK(watchSleepMs(awake) == 60000 - awake, "one sample left sleeps one sample");

  rtc_msSinceReport = 890000;                     // 10 s to the report
  CHECK(watchSleepMs(awake) == 10000 - awake, "a short remainder is honoured");

  // The regression. `if (gap < WATCH_SAMPLE_MIN_MS)` also fired for any
  // remainder of 1..4999 ms, undoing the clamp above it: the probe slept a
  // whole sample gap and the report landed up to cfg_sample_ms late, every
  // cycle, whenever cfg_interval % cfg_sample_ms fell in that band.
  printf("a remainder under the sample floor must not delay the report\n");
  // The property is that the probe never sleeps a WHOLE SAMPLE GAP when only a
  // short remainder is left — not that it hits the deadline exactly, which it
  // cannot: a remainder shorter than the wake itself floors at 100 ms, and no
  // probe can report sooner than it takes to wake and read the sensor.
  for (uint32_t left : {1u, 100u, 3000u, 4999u}) {
    rtc_msSinceReport = cfg_interval - left;
    uint32_t s = watchSleepMs(awake);
    uint32_t bound = left > 100UL ? left : 100UL;
    CHECK(s <= bound, "slept past the report when a shorter remainder was left");
    if (s > bound)
      printf("    left=%u ms -> slept %u ms (report %u ms late)\n",
             left, s, s + awake - left);
  }

  printf("a report that is already due sleeps a sample, not zero\n");
  rtc_msSinceReport = cfg_interval;               // due now
  CHECK(watchSleepMs(awake) == 60000 - awake, "report due must sleep one sample gap");
  rtc_msSinceReport = cfg_interval + 5000;        // overshot
  CHECK(watchSleepMs(awake) == 60000 - awake, "an overshoot must not underflow");

  printf("the sleep never collapses to zero\n");
  rtc_msSinceReport = 0;
  CHECK(watchSleepMs(999999) == 100UL, "a wake longer than the gap floors at 100 ms");

  // --- the two exits that used to ignore the watch entirely -----------------
  // A sensor fault and a disturbance burst are the two moments the watch most
  // needs to keep looking, and both answered a flat cfg_interval: on a
  // 15-minute reporting probe that is a quarter of an hour of not watching a
  // freezer, immediately after the two events most likely to matter.
  printf("a sensor fault retries at the sample cadence, not the report cadence\n");
  cfg_interval = 900000; cfg_sample_ms = 60000;
  rtc_msSinceReport = 300000;                     // mid-interval
  CHECK(nextSleepMs(awake, 1000UL, true) == 60000 - awake,
        "a fault must not blind an armed watch for a whole report interval");
  CHECK(nextSleepMs(awake, 1000UL, true) <= cfg_sample_ms,
        "fault sleep exceeded one sample gap");

  printf("...but a PERSISTENT fault falls back to the report cadence\n");
  // rtc_msSinceReport is only reset by a SUCCESSFUL post, so on a dead sensor
  // it sits past cfg_interval forever. Every wake then looks report-due, and a
  // report-due wake brings the radio up for a full association -- every sample
  // gap, on a probe whose DS18B20 is simply unplugged.
  rtc_msSinceReport = cfg_interval + 120000;
  CHECK(nextSleepMs(awake, 1000UL, true) == cfg_interval - awake,
        "a dead sensor woke the radio once per sample gap instead of per report");

  printf("...and the normal exit still targets the next sample when due\n");
  CHECK(nextSleepMs(awake, 100UL, false) == 60000 - awake,
        "a report that just fired must still sleep one sample gap");

  printf("...and so does the wake after a disturbance burst\n");
  rtc_msSinceReport = 120000;
  {
    uint32_t untilReport = cfg_interval - rtc_msSinceReport;
    uint32_t bound = cfg_sample_ms < untilReport ? cfg_sample_ms : untilReport;
    CHECK(nextSleepMs(awake, cfg_sample_ms, false) <= bound,
          "post-burst sleep exceeded min(sample, remainder)");
  }
  {
    // A burst runs for BURST_WINDOW_MS (20 s), so on any cadence shorter than
    // that `elapsed` outruns the whole gap and the floor decides the answer.
    // The generic 100 ms anti-reboot floor would wake the probe a tenth of a
    // second after twenty seconds of radio -- the collapsed floor the v2.7.0
    // guard exists to prevent, arrived at from the other side.
    uint32_t saved = cfg_sample_ms;
    cfg_sample_ms = 5000;                       // WATCH_SAMPLE_MIN_MS
    rtc_msSinceReport = 120000;
    CHECK(nextSleepMs(20000UL, 100UL, false) == 100UL,
          "precondition: the generic floor is what would fire here");
    CHECK(nextSleepMs(20000UL, cfg_sample_ms, false) == cfg_sample_ms,
          "post-burst sleep collapsed to the anti-reboot floor");
    cfg_sample_ms = saved;
  }

  printf("an UNARMED probe still sleeps the full reporting interval\n");
  cfg_alert_min_c = WATCH_UNSET_C; cfg_alert_max_c = WATCH_UNSET_C;
  rtc_msSinceReport = 0;
  CHECK(!watchArmed(), "the unarmed case must actually be unarmed");
  CHECK(nextSleepMs(awake, 100UL, false) == cfg_interval - awake,
        "an unarmed probe must keep its v2.7.0 battery behaviour");
  cfg_alert_max_c = -12.0f;                       // re-arm for what follows

  // --- an hour of wakes, which is the test that needs a bench ----------------
  // Every check above is one decision in isolation. What the single-step form
  // cannot show is DRIFT: a per-cycle error of a few seconds looks like nothing
  // and is 40 s by the end of an hour. Running the loop is the only way to see
  // it, and on hardware that costs an hour per configuration.
  //
  // The pairs below are chosen to NOT divide evenly, because that is where the
  // arithmetic is interesting -- 900000 % 7000 = 4000, which lands inside the
  // 1..4999 ms band the old `gap < WATCH_SAMPLE_MIN_MS` test swallowed, making
  // every report 3 s late, every cycle, on exactly this configuration.
  printf("an hour of wakes: reports land on the interval, not a sample late\n");
  struct Case { uint32_t interval; uint32_t sample; const char* what; };
  for (Case c : {Case{900000, 7000,  "15 min report / 7 s check (remainder 4 s)"},
                 Case{900000, 60000, "15 min report / 1 min check (divides)"},
                 Case{900000, 11000, "15 min report / 11 s check (remainder 9 s)"},
                 Case{600000, 45000, "10 min report / 45 s check (remainder 15 s)"},
                 Case{300000, 10000, "5 min report / 10 s check (mains probe)"},
                 Case{900000, 300000,"15 min report / 5 min check (battery probe)"}}) {
    cfg_interval = c.interval; cfg_sample_ms = c.sample;
    cfg_alert_min_c = 1.0f; cfg_alert_max_c = 5.0f;
    CHECK(watchArmed(), "case should arm");

    // A sample wake is a sensor read; a report wake also powers the radio and
    // POSTs. Both are charged against the interval by the firmware, so both have
    // to be charged here or the simulation would be easier than reality.
    const uint32_t AWAKE_SAMPLE = 300, AWAKE_REPORT = 4000;
    rtc_msSinceReport = 0;
    uint64_t now = 0, lastReport = 0;
    uint32_t reports = 0, wakes = 0;
    int64_t worstLate = 0, worstEarly = 0;
    // One hour of wall clock, plus a guard so a bug that stops advancing time
    // fails the test instead of hanging it.
    while (now < 3600000ULL && wakes < 100000) {
      wakes++;
      bool sampleOnly = sampleOnlyWake();
      uint32_t awake = sampleOnly ? AWAKE_SAMPLE : AWAKE_REPORT;
      if (!sampleOnly) {
        uint64_t at = now + awake;
        if (reports++) {
          int64_t err = (int64_t)(at - lastReport) - (int64_t)c.interval;
          if (err > worstLate)  worstLate = err;
          if (err < worstEarly) worstEarly = err;
        }
        lastReport = at;
        rtc_msSinceReport = 0;          // as loop() does on a delivered POST
      }
      uint32_t sleepMs = watchSleepMs(awake);
      rtc_msSinceReport += awake + sleepMs;
      now += awake + sleepMs;
    }
    // The two directions are NOT symmetric, and conflating them hides the bug.
    //
    // LATE is the failure. A report can only happen on a wake, and the sleep is
    // clamped to the remainder precisely so a wake lands on the deadline — so a
    // late report means the clamp did not hold. That is what the old
    // `gap < WATCH_SAMPLE_MIN_MS` test broke, and it was late by a whole sample
    // gap minus the remainder, every cycle.
    //
    // EARLY is the design. sampleOnlyWake()'s half-sample bias reports at the
    // last sample before the deadline rather than sampling and waking again a
    // moment later: 600000 % 45000 = 15000, less than half a 45 s gap, so the
    // probe reports 15 s early and saves a whole wake instead of spending one to
    // be punctual. Bounded by half a sample gap, which is what makes it a bias
    // and not drift — it does not accumulate, because each report resets the
    // interval.
    CHECK(worstLate <= 0, c.what);
    CHECK(worstEarly >= -(int64_t)(c.sample / 2), "early by more than the bias allows");
    uint32_t want = (uint32_t)(3600000ULL / c.interval) - 1;
    CHECK(reports >= want, "fewer reports than the hour should contain");
    printf("  %-44s %u reports, %lld ms late / %lld ms early at worst\n",
           c.what, reports, (long long)worstLate, (long long)-worstEarly);
  }

  printf("\n%s\n", failures ? "FAILURES ABOVE" : "all watch-logic checks passed");
  return failures ? 1 : 0;
}
