tallen5431/Temperature_Sensor_V2/(commit log)

2026-02-28 Initial commit for Temperature_Sensor_V2
2026-02-28 Fix bugs: thread safety, probe tracking, path traversal, CSV performance
    - probe_discovery: Replace global setdefaulttimeout() with thread-based
    DNS resolution to avoid a race condition affecting all sockets in the
    process. Add update_last_seen() so ingest can register unknown probes
    directly inside _probes under the lock (fixes lost-probe-on-ingest bug).
    - api/routes.py: Use discovery.update_last_seen() instead of mutating
    the shallow-copy returned by list_probes() — new probes were silently
    discarded because they were written to the copy, not _probes.
    - app.py: Restrict /download/<filename> to .csv files only; previously
    any file under BASE_DIR (including config.json with aut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
2026-02-28 Improve end-user install experience
    - requirements.txt: pin all packages with compatible-release (~=) to
    prevent silent breakage when upstream releases a major version bump.
    - Start.sh: add Python 3.9+ detection with a friendly error box if
    Python is missing; default PORT to 8088 (was 8080, inconsistent with
    README); suppress pip noise with -q; auto-open the browser as soon as
    the server begins accepting connections.
    - Start.bat: try py / python3 / python in order so it works regardless
    of how Python was installed on Windows; add the same version check and
    friendly error; fix PORT default to 8088; auto-open browser via a
    detached helper that polls the port before launching the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
2026-02-28 Fix browser auto-open and reduce venv compile overhead
    - app.py: open browser 2 s after server starts using Python's built-in
    webbrowser module (triggered by OPEN_BROWSER=1 env var set by start
    scripts). Fix stale 8080 default port to 8088 in both _public_base()
    and the __main__ block.
    - Start.bat / Start.sh: set OPEN_BROWSER=1 and remove the fragile
    cmd-polling / socket-polling browser-open blocks — Python's webbrowser
    module is more reliable and works on every platform.
    - Start.bat / Start.sh: add --no-compile to pip install so bytecode is
    only generated for modules actually imported at runtime, reducing the
    initial venv size.
    https://claude.ai/code/session_018mqx69cmceTDg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
2026-03-01 Add fixed ESP32 Arduino sketch (v1.3.0)
    Fixes all issues found in code review:
    Bugs:
    - temperature_f was computed but never added to the POST JSON payload;
    hub now receives both temperature_c and temperature_f from the probe.
    - WiFiManager parameters (p_server, p_token, p_interval) were registered
    twice — once in setup() and again in startConfigPortal() — causing
    duplicate form fields in the WiFi captive portal. Parameters are now
    registered exactly once in setup().
    - lastAtMs now uses the already-captured `now` variable instead of a
    second millis() call.
    Performance / reliability:
    - DS18B20 conversion is now fully non-blocking. setWaitForConversion(false)
    + 9-bit resolutio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
    [esp32_temp_probe.ino]
2026-03-01 Add offline buffer with NTP timestamps (v1.4.0)
    When WiFi is unavailable, temperature readings are stored to LittleFS
    flash with accurate UTC timestamps. When the connection is restored, all
    buffered readings are uploaded to the hub in chronological order using
    their original recording times — no data is lost and timestamps are
    correct even after hours offline (e.g. freezer door closed).
    How it works:
    - NTP sync (pool.ntp.org) runs on every WiFi connect. The ESP32 internal
    RTC holds the time through disconnections with <2 s drift per hour.
    - Every POST now includes a "timestamp" field. The hub's normalize_payload
    already accepts this field and uses it instead of the receipt time.
    - Of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
    [esp32_temp_probe.ino]
2026-03-02 Add per-probe read interval editing to Devices tab
    The edit modal (✏️) now includes a Read Interval field so each probe's
    logging frequency can be tuned independently from the global default.
    Changes:
    - devices_panel.py: adds numeric interval input (seconds, min 0.5) to
    the edit modal; populates it from cfg['probe_intervals'][probe_id]
    (falling back to the global interval_sec setting); on Save, persists
    the new interval and immediately calls provision_probe() to push it
    to the probe over HTTP — so the change takes effect at once if the
    probe is reachable, or on the next auto-provision cycle otherwise.
    Probe cards also show the per-probe interval when one is set.
    - auto_pro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
2026-03-03 Fix timestamp parsing to handle UTC 'Z' suffix from probe firmware
    Probe firmware v1.4.0 generates UTC timestamps with a trailing 'Z'
    (e.g. 2026-03-03T00:06:33Z). This broke the dashboard in two ways:
    1. datetime.datetime.fromisoformat('...Z') raises ValueError on Python
    < 3.11, crashing the entire dashboard callback.
    2. pd.to_datetime('...Z', errors='coerce') returns NaT on older pandas,
    silently dropping all probe readings from the graph.
    Fixes applied:
    - core/storage.py normalize_payload(): strip trailing 'Z' and any
    '+/-HH:MM' offset before writing to CSV, so all newly stored rows use
    plain naive ISO 8601 — consistent with hub-generated timestamps.
    - components/dashboard_vi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
2026-03-03 Show probe ID as default device name in Devices tab
    Previously the card title used the mDNS instance name (TempSensor-XXXX,
    chip-based) and buried the probe ID in a small subtitle. Now the probe
    ID (TempProbe-XXXX, ROM-based) is always the primary display name,
    matching the identifier used everywhere else in the system.
    When a friendly name is set it remains the title, with the probe ID
    shown as the subtitle beneath it.
    https://claude.ai/code/session_018mqx69cmceTDg8nAzpwprC
2026-03-03 Fix three bugs found in codebase review
    1. devices_panel.py — fromisoformat crash on 'Z' timestamps
    The last_seen string-parsing branch called fromisoformat() without
    stripping the 'Z' suffix. Crashes on Python < 3.11 if last_seen ever
    arrives as a UTC ISO string rather than a Unix float.
    2. dashboard_view.py — DataFrame mutated before copy in filter function
    filter_dataframe_by_time_range() added a 'dt' column directly to the
    caller's DataFrame before taking a .copy() of the filtered result.
    In pandas 2.0+ this triggers SettingWithCopyWarning and is scheduled
    to become an error. Fixed by calling df.copy() at the top of the
    function before any mutation.
    3. auto_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
2026-03-03 Fix out-of-order CSV rows caused by concurrent writes without a lock
    Two write paths share the same CSV file concurrently:
    - PullLogger._loop() on a background thread calling append_row()
    - /api/ingest Flask endpoint handled on multiple worker threads
    Without serialisation, a push request that arrives at T=:46 can be
    queued behind a slower T=:50 request, so the :50 row lands in the file
    first and timestamps appear to go backwards.
    Fix: add a module-level threading.Lock (_write_lock) in core/storage.py
    and acquire it for the entire duration of append_row() (including the
    _ensure_column read-modify-write). Export the same lock and use it in
    the _append_csv fallback path in api/routes.py so e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
2026-03-03 Fix offline buffer silently dropping readings on 190 KB SPIFFS partition
    BUFFER_MAX_BYTES was set to 290 KB, which exceeds the total filesystem
    size of the "Minimal SPIFFS (1.9MB APP with OTA/190KB SPIFFS)" partition
    scheme. The cap check (sz >= BUFFER_MAX_BYTES) could therefore never
    trigger; instead the filesystem silently filled up and LittleFS.open()
    returned a null File, causing every subsequent offline reading to be
    dropped with only a Serial message. This produced the observed gap in
    the CSV log when the probe was taken out of WiFi range.
    - Reduce BUFFER_MAX_BYTES from 290 KB to 160 KB so the cap fires before
    the 190 KB "Minimal SPIFFS" partition is exhausted.
    - Add BUFFER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
    [esp32_temp_probe.ino]
2026-03-03 Update firmware for Default 4MB with spiffs partition scheme
    Switch recommended partition from "Minimal SPIFFS (190 KB)" to
    "Default 4MB with spiffs (1.2MB APP/1.5MB SPIFFS)". This keeps OTA
    support while increasing offline buffer capacity from ~4.5 h to ~38 h
    at a 5-second reading interval.
    - BUFFER_MAX_BYTES: 160 KB → 1400 KB (sized for 1.5 MB LittleFS partition)
    - BUFFER_MIN_FREE: 4 KB → 8 KB (extra headroom for FS metadata on larger FS)
    - Update header comment to document recommended partition and capacity
    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
2026-03-03 Switch to No OTA (2MB APP/2MB SPIFFS) partition; remove ArduinoOTA
    The sketch (1.36 MB) exceeds the 1.25 MB app partition of "Default 4MB
    with spiffs", causing a compile error. The "No OTA (2MB APP/2MB SPIFFS)"
    scheme gives 2 MB for the app (65% used) and 2 MB for LittleFS, which
    is a better fit for a probe that may be in a physically inaccessible
    location (e.g. inside a freezer).
    With ArduinoOTA gone the sketch is smaller, leaving more headroom for
    future growth.
    - Remove #include <ArduinoOTA.h>
    - Remove setupOTA() function and its call from setup()
    - Remove ArduinoOTA.handle() from loop() and bufferFlush()
    - BUFFER_MAX_BYTES: 1400 KB → 1900 KB (sized for 2 MB LittleFS partitio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
    [esp32_temp_probe.ino]
2026-03-04 Fix buffer flush never retrying after a partial failure
    bufferFlush() stops on the first failed POST (server timeout, hub
    unreachable) and saves the byte offset so it can resume later. The
    problem: it was only called on initial WiFi connect and on reconnect.
    If the flush failed midway and the device stayed continuously connected,
    the remaining buffered readings were stuck indefinitely — no reconnect
    event would ever fire to resume the flush.
    This was visible in the status endpoint: a probe showing
    buffered_bytes > 0 while also actively sending live readings.
    Fix: add a periodic retry in loop() that calls bufferFlush() every 30 s
    whenever the device is connected and the buffer file still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
    [esp32_temp_probe.ino]
2026-03-05 Fix duplicate probe cards when ingest arrives before mDNS discovery
    _probes used two different key schemes:
    - mDNS discovery: keyed by probe.host ("tempsensor-dc3c.local.")
    - update_last_seen fallback: keyed by probe_id ("TempProbe-00DE")
    Race condition on probe startup: /ingest requests arrive immediately
    after the probe powers on, before the hub's mDNS browser has had time
    to resolve the service. update_last_seen finds no existing entry and
    creates one keyed by probe_id. Seconds later _handle fires and creates
    a second entry keyed by host — both sit in _probes and both render as
    cards in the devices tab.
    Fix: in _handle, before inserting the mDNS-resolved entry, scan for
    any exis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
2026-03-05 Fix 11 bugs found in code review
    1. dashboard_view.py: use absolute CSV path derived from __file__ so the
    dashboard always reads the same file app.py writes to, regardless of CWD.
    2. probe_discovery.py: anchor Removed probe match to a '.' boundary so a
    short name like 'TempSensor-9A' cannot accidentally remove a probe named
    'TempSensor-9A3F'.
    3. api/routes.py: GET /ingest now calls discovery.update_last_seen() so
    probes using GET requests appear as active in the Devices panel.
    4. auto_provisioner.py + probe_discovery.py: stop mutating shared ProbeInfo
    objects without the discovery lock. _refresh_ip_best_effort now returns
    the new IP instead of writing it directly; caller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
2026-03-05 Fix smart quotes (U+2018/2019) in probe_discovery.py causing SyntaxError on Python 3.13
2026-03-05 Stop re-provisioning probes that are already correctly configured
    The AutoProvisioner was POSTing to /provision on every 10-second cycle
    unconditionally. On the ESP32, each /provision call triggers saveConfig()
    which writes to NVS — a slow operation that stalls the web server briefly,
    causing the 'dropped connection' symptom visible in the Devices tab.
    Fix: before provisioning, GET /status from the probe and compare its
    current server_url and interval_ms against what we would send. If they
    already match, skip the provision POST entirely. The probe is only
    re-provisioned when its config actually differs (e.g. first boot, hub IP
    changed, user edited the interval).
    Added get_probe_status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
2026-03-05 Show live temperature on ESP32 root page (v1.4.1)
    handleRoot() now displays:
    - Current temperature in both °C and °F in a highlighted block,
    with the ISO timestamp and age of the last reading
    - A warning if no reading has been taken yet (sensor wiring issue)
    - WiFi RSSI and uptime added to the info table
    - Page auto-refreshes every 5 seconds via meta refresh
    - Minimal CSS for readability (max-width, alternating table rows)
    If the DS18B20 is disconnected, the user sees a clear warning with
    the GPIO pin number rather than a blank temperature field.
    [esp32_temp_probe.ino]
2026-03-08 Fix: probe silently discards all readings when NTP has not synced (v1.4.2)
    Root cause: loop() only POSTed a reading when nowIso() returned a non-empty
    string, which requires a successful NTP sync. On this device NTP never
    synced (DNS/firewall issue), so every reading was silently dropped — the
    sensor read temperature correctly but nothing reached the hub or the buffer.
    Fix 1 (data loss): remove the ts.length() > 0 guard on the live POST path.
    The probe now POSTs to the hub even without a valid timestamp.
    postWithTimestamp() already omits the 'timestamp' field when ts is empty,
    and the hub's normalize_payload() falls back to server time in that case.
    The offline buffer still requires a va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
    [esp32_temp_probe.ino]
2026-03-12 Fix temperature history plot to sort data by timestamp
    Buffered sensor uploads can arrive out of order, causing the history
    graph to draw lines that zigzag backwards in time. Sort the full
    dataframe by parsed timestamp immediately after reading the CSV so
    that the gauge, statistics, and all plot traces are always rendered
    in chronological order.
    https://claude.ai/code/session_01TboyRqm8RQhKyUp9EpW3HU
2026-03-12 Add alert threshold editing to the Devices tab edit modal
    Min and Max temperature threshold fields (°C) are now shown in the
    Edit Probe modal alongside the existing Friendly Name and Read
    Interval fields. Values are pre-populated from config on open and
    persisted to alert_thresholds in config.json on save. Clearing both
    fields removes the per-probe threshold entry so the probe falls back
    to the default thresholds (if any).
    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
2026-03-13 Add deep sleep between readings to improve battery life (v1.5.0)
    When the read interval is >= 10 s the device now enters deep sleep
    between readings, dropping idle current from ~100 mA to <1 mA.
    For shorter intervals WiFi modem sleep is used instead so the web
    server stays fully responsive.
    Key changes:
    - RTC memory persists wake count, time-valid flag, and pre-sleep epoch
    across deep sleep so time can be restored without an NTP round-trip
    on every wake (periodic NTP resync every 30 wakes corrects drift)
    - Fast WiFi reconnect path on deep-sleep wakes (no portal, 15 s timeout)
    - WEBSERVER_WINDOW_MS (3 s default) keeps the HTTP server alive after
    each reading so the hub's auto-provision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
    [esp32_temp_probe.ino]
2026-03-13 Fix probe timestamps displaying in wrong timezone on the history graph
    Root cause: probe firmware sends UTC timestamps (trailing 'Z') but
    normalize_payload() was stripping the 'Z' without converting the value,
    so UTC times were stored and displayed as if they were local time —
    off by the hub machine's UTC offset.
    Fix:
    - storage.py: new _to_local_naive() converts any timezone-aware
    timestamp (UTC 'Z' or +HH:MM offset) to local machine time before
    storing, so every CSV row is consistently in local wall-clock time
    - temp_graph.py: x-axis title now shows the local timezone abbreviation
    (e.g. "Time (EST)") so it is always clear what timezone is displayed
    No manual timezone setting is ne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
2026-03-15 Fix dashboard going blank after power-cut CSV corruption
    After a power loss mid-write, the CSV can contain a partial/empty last
    row. pandas parses it with NaN values and coerces the timestamp to NaT.
    sort_values() places NaT rows last (na_position='last' default), so
    df.tail(1) always picked the corrupted row. datetime.fromisoformat() on
    str(NaN) == 'nan' then threw ValueError, the whole update_dashboard
    callback fell into the except block, and the UI showed 0 probes / blank
    graph permanently until the app was restarted with the file cleaned up.
    Fixes:
    - Drop rows with unparseable timestamps immediately after sort (one-line
    dropna) so corrupted rows are ignored rather than poisoning the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
2026-06-04 Migrate hub to SQLite, harden for production, and clean up the codebase
    Architectural change (data layer)
    - Replace the append-only CSV system-of-record with SQLite (core/db.py, WAL
    mode). The CSV was rewritten in full to add columns and re-read in full by the
    dashboard every 5 s, causing the recurring blank-dashboard / corruption issues
    and not scaling for long-term logging.
    - Dashboard now queries only the selected time window (index-backed); large
    windows are downsampled for plotting while statistics stay exact.
    - Legacy temperature_log.csv is imported once on first start (no data loss).
    - CSV export honours the selected range; download streams from the DB.
    Production hardening
    -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
2026-06-05 Add notifications, calibration, retention, backups, and logging
    Notifications (the headline feature)
    - Threshold alerts now run server-side on a background thread (alert_monitor.py)
    so they fire even when no browser is open — the previous threshold check only
    ran while someone had the dashboard loaded.
    - Channels: email (SMTP, STARTTLS/SSL) and webhook (Slack-compatible "text"
    field plus structured JSON for Zapier/IFTTT/Twilio-style relays). Each channel
    fails independently.
    - Alert logic is a pure, unit-tested state machine (core/alerts.py): per-probe
    min/max with a "default" fallback, reminder cooldown, and optional recovery
    ("back to normal") notices. Emits only on transitio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
2026-06-05 Fix backup temp-file leak, batch CSV migration; add TESTING.md
    Bug fixes / improvements
    - /download/backup.db leaked its temp file (the finally ran before the response
    streamed — worked on Linux by luck, leaked on Windows). Now streamed via a
    generator that deletes the file after the body is sent, on any platform, with
    constant memory. Verified: 3 downloads, 0 leaked temp files.
    - Legacy-CSV migration now imports in a single transaction (Database.bulk_insert)
    instead of one commit per row — 5000 rows import in ~2s on first boot.
    - Dashboard "Connected Probes" now honours the configurable
    probe_online_timeout_sec instead of a hardcoded 60 s (matches the API).
    - Extracted build_n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
2026-06-05 Add offline-probe alerts (probe stopped reporting)
    - The alert monitor now detects probes that stop reporting for longer than
    offline_after_sec (default 5 min) and notifies via the same email/webhook
    channels, plus a "back online" notice when they resume. A dead/unplugged
    probe is now surfaced, not silently missing from the log.
    - Pure, unit-tested logic in core/alerts.evaluate_offline; the monitor seeds
    connectivity state on its first cycle so a hub restart never emits a burst of
    "offline" alerts for probes that were already quiet.
    - New DB query last_reading_epoch_per_probe (bounded tracking window so retired
    probes age out instead of alerting forever).
    - Settings UI: "Alert wh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
2026-06-05 Fix single probe appearing as two devices
    The probe id was derived from the DS18B20 ROM code when that read
    succeeded (TempProbe-XXXX) but fell back to the ESP32 chip id when it
    failed on a cold boot (TempSensor-XXXX). Since the probe re-runs setup()
    on every deep-sleep wake, one physical device could report two
    identities and show as two cards sharing an IP.
    Firmware (root cause): derive the probe id once, retrying the ROM read
    so the first id is the ROM-based one, then persist it to NVS and reuse
    it on every boot so a later failed read can't flip the identity. Bumped
    to v1.6.0.
    Hub (defensive, no reflash needed): list_probes() now collapses entries
    sharing a LAN IP to the most recently-s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
    [esp32_temp_probe.ino]
2026-06-09 Use logging framework everywhere; validate config on load
    Replace all 11 print() calls in services and UI callbacks with module
    loggers (hub.provisioning, hub.provisioner, hub.devices, hub.dashboard).
    In the packaged no-console build print() output was lost entirely, so
    crash diagnostics never reached the rotating log file.
    Add core/config_schema.normalize_config: coerce every known config field
    to a safe type/range, falling back to documented defaults and logging a
    warning for each correction. A hand-edited or partial config.json can no
    longer crash the hub. Wired into Config.__init__ (12 new tests).
    https://claude.ai/code/session_011eTmdLnDkpHW7smFmrffqp
2026-06-09 Customer onboarding: live status, first-run guidance, rewritten Help
    - Footer now shows real hub state (N probes online / offline / idle /
    "Waiting for first probe…") instead of a hardcoded "Status: Ready",
    driven by a pure, tested core.status.hub_status.
    - Dashboard shows a first-run onboarding card with step-by-step probe
    setup until the first reading lands, then hides itself.
    - Devices empty state now guides the customer (power a probe, ~20 s,
    Probe Setup Helper) instead of a bare "No probes discovered yet."
    - Help modal rewritten around what customers do (get online, name &
    calibrate, alerts, data/backup, troubleshooting) instead of listing
    API endpoints.
    12 new tests (sta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
2026-06-09 Add Diagnostics view + /api/diagnostics for self-service support
    A new Diagnostics page (and matching secret-free JSON endpoint) gives a
    one-glance health snapshot: hub version, LAN URL, readings stored, DB
    size, newest reading, retention, per-probe online/offline, and which
    notification channels are enabled. A one-click clipboard copies the full
    snapshot so a customer can paste it to support without the CLI.
    Logic lives in pure core.diagnostics.build_diagnostics (channels report
    on/off only — never hosts, URLs, passwords, or tokens). 11 new tests.
    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
2026-06-09 Add proprietary license + third-party compliance; onedir packaging
    - LICENSE: proprietary "all rights reserved" template (with clearly
    marked [COPYRIGHT HOLDER]/[CONTACT EMAIL] placeholders to fill in).
    - THIRD-PARTY-LICENSES.md + packaging/gen_third_party_licenses.py: a
    generator that walks the bundled runtime tree (36 packages) and the
    firmware libraries, records version/license/source, and reproduces each
    bundled license text. zeroconf is correctly identified as LGPL-2.1.
    - Packaging switched from onefile to onedir so the LGPL `zeroconf` module
    stays as replaceable files on disk (clean LGPL "modify and relink"
    compliance). LICENSE + THIRD-PARTY-LICENSES.md now ship in the bund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
2026-06-09 Add alert deadband (hysteresis) to stop threshold flapping
    A noisy DS18B20 sitting right on a min/max threshold would flap
    high -> recovery -> high every reading and spam notifications. Add a
    configurable deadband (alert_hysteresis_c, default 0.5 C): once a probe
    is in breach it must move back inside its limit by this margin before the
    alert clears. Entering a breach still uses the raw threshold.
    - Pure logic in core.alerts.classify/evaluate (backward compatible:
    defaults to 0.0, so existing unit tests are unchanged).
    - Wired through the alert monitor (reads config), validated in
    config_schema, seeded in config.example.json, and exposed in
    Settings -> Notifications as "Alert deadband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
2026-07-06 Harden and productize the hub for sale (security, reliability, UX)
    Turns the hub from a hobby script into shippable product software. Verified
    end-to-end (33 tests + live server smoke test).
    Security
    - Restrict /download to the temperature log only; the old route served any file
    under the project dir (config.json with the token, all source) to any LAN client.
    - Unify the device token: one value drives BOTH ingest auth and provisioning
    (was two independent sources, so setting SERVER_TOKEN 401'd every probe). Token
    is auto-generated on first run and pushed to probes, so plug-and-play still works
    while the LAN is secure by default.
    - Make ingest POST-only (GET could poison the log via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
2026-07-06 Add ESP32 probe firmware, protocol spec, and product documentation
    The manufactured product is the ESP32 probe, but the repo had no firmware and
    no manufacturing/legal/sales materials. This adds everything needed to build
    small batches and sell online, all consistent with the hub's implemented API.
    Firmware (the actual product software)
    - firmware/: PlatformIO ESP32 project (Arduino framework). Reference ThermaProbe
    firmware implementing the full protocol v1: MAC-derived probe id, NVS storage,
    Wi-Fi STA with a WPA2 SoftAP captive portal for setup, mDNS advertisement
    (_temps-probe._tcp with id/name/fw/proto TXT), the /provision, /whoami and
    /status HTTP endpoints, DS18B20 read with f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
2026-07-06 Fix broken CSV download button; remove dead legacy modules
    Review pass on the productization changes.
    - Fix "Download CSV": the absolute-path refactor made the dashboard link by the
    full CSV path, producing '/download//home/.../temperature_log.csv' (double
    slash) which missed the hardened download route and returned the dashboard
    HTML instead of the file. Link by basename now; verified the route serves
    text/csv with a Content-Disposition attachment. Added tests/test_download.py
    to guard the route lockdown and the link form.
    - Remove dead code: core/logger.py (unused PullLogger, superseded by push ingest
    + notifications) and the orphaned components/temp_graph.py and probe_panel.p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
2026-07-06 Add homelab integrations (Prometheus, MQTT/HA, Docker) + GTM strategy
    Refines the product toward the strongest validated market wedge — the homelab /
    self-hosted / server-room niche — per docs/GO_TO_MARKET.md. Those buyers already
    run an always-on PC on the same LAN, so ThermaHub's "hub on your own machine"
    model is a natural fit; the gap was integration into their existing stack.
    - Prometheus /metrics endpoint (core/metrics.py): per-probe temperature gauges +
    health counters in the text exposition format, for scraping into Grafana.
    Toggle via metrics.enabled. Verified live.
    - Optional MQTT publishing with Home Assistant auto-discovery (core/mqtt_publish.py):
    each probe appears au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
2026-07-07 Add humidity/VPD support and optional dashboard login
    Two market-driven feature additions (see docs/GO_TO_MARKET.md).
    Humidity + VPD (unlocks the indoor-grow niche — highest willingness-to-pay,
    attacks Pulse's VPD-alert subscription):
    - Firmware: new optional SHT4x temp+humidity sensor variant (-D SENSOR_SHT4x,
    I2C on GPIO21/22). DS18B20/thermocouple builds are unchanged. The probe adds an
    optional humidity_pct field to its ingest POST and /status only on SHT4x builds.
    - Hub: computes VPD (Tetens, with configurable settings.vpd_leaf_offset_c) from
    temperature + humidity. New CSV columns humidity_pct/vpd_kpa (old logs auto-
    upgraded; temperature-only probes leave them blank).
    - Sur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
2026-07-07 Document humidity/VPD/SHT4x; mark grow VPD + dashboard login as shipped
    - PROTOCOL.md: optional humidity_pct on ingest + /status (SHT4x builds); VPD is
    hub-computed (Tetens + leaf offset), not on the wire; still proto v1.
    - firmware/README.md: -D SENSOR_SHT4x variant (I2C GPIO21/22, libs, humidity).
    - docs/BOM.md, docs/ASSEMBLY.md: SHT4x grow-variant part + I2C wiring.
    - docs/USER_MANUAL.md: Humidity & VPD (grow variant) section.
    - docs/GO_TO_MARKET.md: #2 grow niche VPD gap now closed; #1 niche dashboard
    login now shipped.
    - CHANGELOG.md: humidity + VPD entry.
    Claude-Session: https://claude.ai/code/session_012ShNZ2F5sjuwoKSTyUkXa1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
2026-07-07 Add tamper-evident audit trail and compliance/B2B guide
    Answers "what would I need to sell to businesses that require certs/standards"
    with (a) the one concrete product change that helps now and (b) a researched,
    sourced roadmap.
    - Tamper-evident audit trail (core/audit.py): hash-chained, append-only log of
    config changes and data exports to logs/audit.log — each entry hashes the
    previous, so silent edits/deletions break verification. Only key names are
    recorded, never secret values. Wired into Config.update, the /download route,
    and startup; integrity check at GET /api/audit/verify (auth). This is the
    foundation any future 21 CFR Part 11 / Annex 11 path builds on, and a
    procu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
2026-07-07 Bound the log with retention/downsampling; fix timestamps and dashboard reads
    Closes the last 24/7 reliability gap (unbounded log growth) and fixes two issues
    surfaced while building it.
    Retention (core/retention.py, core/storage.apply_retention)
    - Background maintenance keeps readings newer than retention.raw_days at full
    resolution, thins older data to one row per probe per downsample_interval_min
    (preserving long-term trends, not dropping them), and drops anything past
    downsample_days. Runs hourly + ~30s after startup, atomically under the write
    lock. Config-driven (retention block); disable to keep everything.
    - Bounds a 230k-row / 400-day file to ~75k rows in ~340 ms; unit-test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
2026-07-07 Add launch runbook for small-batch selling
    docs/LAUNCH.md: a phased, action-oriented checklist to start selling ASAP —
    freeze features, validate for $0 (build-in-public + waitlist), clear the one
    legal gate (FCC Part 15B SDoC + labeling + insurance), hand-build a first 5–10
    unit batch (BOM/assembly/QC), sell direct to the warm audience, and scale only
    when demand is proven. Leads with the always-on USB DS18B20 homelab probe (no
    battery/SHT4x needed) so hardware ships fastest. Linked from README.
    Claude-Session: https://claude.ai/code/session_012ShNZ2F5sjuwoKSTyUkXa1
2026-07-08 Finalize store listing for the homelab lead product
    Rewrite docs/LISTING.md as ready-to-paste copy for the always-on USB DS18B20
    probe aimed at homelab / server-room buyers: benefit-led titles, can't-be-bricked
    / local positioning (with "no subscription" demoted to a supporting bullet), a
    "drops into your stack" section (Prometheus/Grafana, Home Assistant/MQTT, Docker,
    CSV), an honest spec table (±0.5 C typical uncalibrated; resolution shown
    separately; 2.4 GHz-only; always-on-PC requirement called out), what's-in-the-box,
    a product-photo shot list, an FAQ (incl. the UPS/power-loss caveat), and an
    honest-claims footer (no NIST/certified/medical claims). Grounded in docs/BOM.md
    and the compl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
2026-07-08 Address PR review: fix CSV upgrade alignment, Docker download, secret leaks
    Four issues flagged in code review, all verified fixed (72 tests pass):
    - P1 core/storage.py: schema upgrade of an OLD 4-column log only appended the
    new humidity/vpd columns, leaving probe_id in position 4 — but append_row
    writes in COLUMNS order, so post-upgrade rows misaligned (humidity under
    probe_id, etc.). Reindex the upgraded frame to the canonical COLUMNS order.
    - P2 app.py: the /download route resolved against BASE_DIR, so a Docker/custom
    deployment (CSV_FILE=/data/...) always 404'd the CSV export. Resolve against
    the CSV file's own directory; the equality check still restricts it to the log.
    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
2026-07-09 Security review fixes: redact webhook secret; harden probe setup endpoints
    Ran a dedicated security review of the release. The hub's core auth is sound
    (no injection, auth bypass, path traversal, or unsafe deserialization). Fixed the
    real findings:
    - Webhook URL is a bearer secret but was seeded into the Settings page (dashboard
    is open by default → any LAN device could read it) and returned unredacted by
    GET /api/config. Render it blank (kept on save when empty), like the SMTP
    password, and add webhook_url to SECRET_KEYS. Verified: /settings and
    /_dash-layout no longer contain it; API returns ***set***.
    - Firmware: POST /save (Wi-Fi reconfiguration) is now rejected in station mod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
2026-07-10 Fix falsy-zero alert threshold; unify dashboard + notifier breach logic
    Correctness review pass. Found and fixed one real bug plus its root cause.
    Bug: the dashboard alert banner checked `if max_threshold`/`if min_threshold`
    (truthiness), so a valid threshold of 0 — e.g. a freezer or greenhouse min of
    0 °C — was treated as "unset" and the banner never fired. The server-side
    notifier used `is not None` and DID alert, so the two disagreed: an email/webhook
    would go out while the dashboard showed nothing.
    Root cause: the threshold-breach test was implemented twice (dashboard inline +
    core/notifications._eval_metric) and diverged. Extracted a single
    core.storage.threshold_breach(value, lo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
2026-07-11 Firmware: per-unit random SoftAP password (removes the last known vuln)
    Pre-manufacturing hardening. The setup-network WPA2 key was derived from the MAC
    — but the SSID (ThermaProbe-<hex>) already exposes MAC bytes, so a captured
    handshake was crackable and the home Wi-Fi creds entered during setup could be
    recovered.
    Now the firmware generates a per-unit 64-bit RANDOM password once at first boot
    (esp_random), stores it in NVS, and prints it on a serial "[label]" line.
    factory_flash.py captures that line (pyserial optional; graceful fallback to a
    manual read) instead of computing the password from the MAC. probe_id/hostname/
    SSID stay MAC-derived and deterministic. Updated protocol.h, SECU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
    [factory_flash.py, protocol.h]
2026-07-11 Harden ingest + CSV export (restore guards dropped in the merge)
    Two LAN-local hardening regressions were introduced by taking the sleepy
    ingest path, which validated neither the probe id nor the CSV export:
    - Bound probe_id at ingest via sanitize_probe_id() — keep [A-Za-z0-9_-], cap
    at 32 chars — so a buggy/malicious LAN client can't write an arbitrary value
    into the SQLite store, the CSV export, or an MQTT topic. A real ThermaProbe
    sends "ThermaProbe-<HEX6>", which passes through unchanged.
    - Neutralise spreadsheet formula injection in export_csv(): a cell starting
    with = + - @ (or tab/CR) is prefixed with a single quote so Excel/Sheets
    treat it as text, not a formula. Defen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
2026-07-11 Add browser-based firmware flashing + hobbyist go-to-market ladder
    Lower the barrier for kit / bring-your-own-hardware hobbyists and capture the
    lowest-barrier launch strategy as a durable playbook.
    - flash/: an ESP Web Tools page (index.html + manifest.json) that flashes the
    ThermaProbe firmware onto an ESP32 from Chrome/Edge over Web Serial — no
    toolchain, no installs. build_merged_bin.sh produces the merged image via
    arduino-cli + esptool; README covers building + hosting (GitHub Pages) + the
    browser/HTTPS requirements. The generated .bin is gitignored (needs a real
    hardware build; nothing here is bench-validated).
    - docs/LAUNCH.md: a "lowest-barrier ladder" section (software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
2026-07-11 Add ready-to-paste Tindie listing + fold in Tindie exclusivity
    - docs/TINDIE_LISTING.md: maps the LISTING.md copy onto Tindie's actual listing
    fields (name, summary, tags, kit/assembled price options, Markdown description,
    shipping, photo order) with a pre-publish checklist (photos-need-a-real-unit,
    exclusivity, FCC-for-assembled, payout setup).
    - docs/LAUNCH.md: note Tindie's web-exclusivity (one paid channel per SKU; keep
    your own site for the free software + waitlist) and point the kit/direct-sell
    steps at the new listing.
    - Cross-link from LISTING.md and the README selling section.
    Claude-Session: https://claude.ai/code/s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
2026-07-11 Rebrand ThermaHub/ThermaProbe -> TempSensor across code, firmware, and docs
    Full sweep per the product owner's choice: the hub name, the probe name, the
    firmware (SENSOR_NAME, probe id prefix TempSensor-<HEX6>, WPA2 key prefix TS-),
    the Prometheus metric prefix (tempsensor_*), the MQTT base topic, the app logger,
    and every doc/label/listing now say TempSensor. Tests and their fixtures were
    swept too; 128 pass. Probes must be reflashed to adopt the new identity.
    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
    [esp32_temp_probe.ino, factory_flash.py]
2026-07-11 Make the setup SoftAP open (no password) for one-tap first-time setup
    The per-unit WPA2 setup-AP password made first-time setup harder (type a key
    off the label) to protect only the brief, one-time provisioning window. For a
    home/hobbyist device that trade-off isn't worth it — the AP is torn down once
    the probe joins the home Wi-Fi — so the setup network is now OPEN.
    - Firmware: drop ensureApPassword()/g_apPassword/esp_random; wm.autoConnect and
    startConfigPortal open the AP with no password; the [label] line prints
    ap_pass=none. SSID stays the per-unit TempSensor-<HEX6>.
    - factory_flash.py + protocol.h: remove the WPA2-key label/QC fields; ap_pass=none.
    - Docs (USER_MANUAL, LABEL_T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
2026-07-11 Dashboard: offline-render, per-probe status cards, ingest-based online count
    Three UI/UX improvements surfaced while reviewing the live dashboard:
    - Vendor the Bootstrap/CYBORG theme locally (assets/bootstrap-cyborg.min.css)
    and drop the dbc.themes.CYBORG CDN reference. The hub is local-first but its
    styling was loaded from jsdelivr, so an offline/air-gapped homelab rendered a
    bare, unstyled page. Dash already serves its JS/Plotly locally, so the hub now
    needs no external host at all.
    - Add a per-probe status-card row to the dashboard: each probe's current temp
    with a colour-coded OK / HIGH / LOW / stale badge and a freshness age. A single
    gauge showing "the latest overall" read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
2026-07-11 Dashboard: make the gauge useful + list ingest-known probes on Devices
    - The hero gauge now focuses on the probe that needs attention (the worst
    active threshold breach, else the latest reading), with coloured threshold
    zones (blue below min / green safe band / red above max), a bar coloured by
    state, and an axis auto-ranged around the band. A single gauge on a fixed
    0-100 scale showing whichever probe reported last was misleading — a -18C
    freezer fell off the scale and an over-limit probe still read calm cyan.
    - The Devices page merges probes known only from ingest (db.latest_per_probe)
    with mDNS-discovered ones, so a deep-sleep probe (radio off between readings,
    never mDNS-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
2026-07-11 UI polish: dark-theme form inputs + clearer section headers
    The Settings page (and the Devices edit dialog) rendered inputs/selects as
    bright white boxes against the dark theme — harsh and visually incoherent.
    theme.css now:
    - styles .form-control / .form-select dark (bg, border, focus ring, placeholder,
    disabled) to match the dark UI,
    - brightens .card-title section headers and adds a subtle divider so sections
    read clearly (base theme dimmed them to low-contrast grey),
    - scopes the card hover-lift to .probe-card only, so static stat/settings cards
    no longer jump on hover.
    CSS-only; 128 tests pass; verified via live-hub screenshots.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
2026-07-11 Fix deep-sleep probes flickering offline on the dashboard
    The "Connected Probes" count and the per-probe stale badge used a fixed
    60 s online window, so a battery/deep-sleep probe that wakes every few
    minutes read as offline between wakes even while healthily reporting.
    The freshness window is now the larger of the online timeout, the alert
    monitor's offline_after_sec (default 5 min, so the dashboard and the
    offline alerts now agree on "offline"), and ~2.5x the probe's configured
    reporting interval. A typical deep-sleep probe now stays "connected"
    between wakes with no per-probe configuration.
    - dashboard_view: add _probe_fresh_window(cfg, probe_id); make
    _reporting_probe_count and the p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
2026-07-11 Target the browser flasher at the ESP32-C3 (No-OTA partition scheme)
    The web-flash manifest declared chipFamily "ESP32" (classic), so ESP Web
    Tools would refuse to flash the ESP32-C3 boards this product ships on. It
    now targets ESP32-C3:
    - flash/manifest.json: chipFamily "ESP32-C3", binary tempsensor-esp32c3.merged.bin
    - flash/build_merged_bin.sh: compile for esp32c3 with PartitionScheme=no_ota
    and prefer the esp32 core's own chip-correct .merged.bin (correct bootloader
    offset + partition table by construction), manual-merge fallback at C3 offsets
    - flash/README.md, flash/index.html: ESP32-C3 wording; note that No-OTA is
    fully web-flashable (the whole image is written over USB serial;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
    [factory_flash.py]
2026-07-11 Add per-probe Min/Avg/Max statistics for multi-probe deployments
    The dashboard's Min/Max/Average cards aggregate across all probes, so a
    mixed deployment (e.g. a -18 C freezer + a 22 C room) collapses into one
    meaningless number — the "average" is nonsense.
    When 2+ probes have data in the window, a per-probe statistics breakdown
    now renders below the overall row, keeping each probe's Min/Avg/Max
    separate. A single-probe deployment is unchanged: the global row already
    tells the whole story, so the breakdown renders nothing (no clutter).
    - core/db: add stats_per_probe(window_seconds) — SQL GROUP BY probe_id
    min/max/avg/count over the full un-downsampled window
    - dashboard_view: add pur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
2026-07-11 Add device removal, dashboard focus mode, and clearer Settings
    Three UX improvements plus a captive-portal doc note.
    Remove a device (Devices page):
    - New Database.delete_probe(probe_id) and ProbeDiscovery.forget_probe(probe_id).
    - Edit dialog gains a "Remove device" button + confirmation that deletes the
    probe's readings and its saved name/thresholds/calibration/interval and forgets
    it from discovery. A still-powered probe reappears on its next reading (the
    dialog says so). Clears accumulated test devices.
    Dashboard focus mode (simplify + granularity):
    - A "Viewing" selector drills from the all-probes overview into one probe: the
    gauge, history graph and Min/Avg/Max stats then sho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
2026-07-11 Fix dashboard focus reverting to overview for out-of-range probes
    Adversarial review found that selecting a probe whose latest reading is
    older than the chosen time range (but within the last 7 days, so it stays
    in the selector and shows a card) made build_dashboard look it up over the
    short range, find nothing, and silently revert the gauge/graph/stats to the
    all-probes overview — contradicting the dropdown and the per-probe card.
    Resolve the focused probe against the same 7-day window the selector and
    cards use, so focus is retained: the gauge shows its last value and the
    graph/stats stay its own (empty for a short range with no data) instead of
    showing a different probe. Regression tes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
2026-07-11 Professional-grade data export, health panel, and demo data
    Four improvements to the setup -> record -> acquire journey:
    - Smarter CSV export: "Download CSV" honors the current view (focused
    probe + time range); a new Export dialog adds a custom date range and
    per-probe selection. Database.export_csv gains probe_id/start_epoch/
    end_epoch filters; the download route parses ?probe=/?from=/?to=.
    - Unambiguous timestamps: every CSV row carries a timestamp_utc column
    derived from the row's epoch, so exports stay correct across DST and
    machines. The export dialog names the hub's timezone.
    - System health panel on Diagnostics: status, uptime, readings/24h, last
    write, rows written this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
2026-07-11 Add one-click installers and a signed release pipeline
    Turn the existing PyInstaller onedir bundle into real, one-click installers so
    setting up the hub is friction-free — no Python, no terminal.
    - .github/workflows/release.yml: on a v* tag (or manual dispatch), build a
    Windows .exe installer (Inno Setup), a macOS .dmg (.app bundle), and a Linux
    .tar.gz on native runners and attach them to a GitHub Release. Code-signs
    (Windows Authenticode) and signs + notarizes (macOS Developer ID) when the
    signing secrets are configured; builds unsigned otherwise so the pipeline
    works for forks.
    - packaging/windows/tempsensor.iss + build_installer.ps1: per-user install (no
    admin), Start Menu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
2026-07-11 Add release/installer readiness checklist
    Capture what remains before relying on the one-click installer pipeline:
    a build dry-run, on-device install testing on Windows/macOS, buying and
    configuring code-signing certs, and polish (app icons, EULA, versioning).
    Records that the sandbox can't push tags or dispatch the workflow, so the
    dry-run must be run from a normal checkout.
    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
2026-07-12 Harden hub: ingest validation, crash-safe config, security & robustness fixes
    A review pass surfaced a set of correctness/robustness/security issues. This
    lands the confirmed, self-contained fixes (26 new/updated tests; suite 143→169).
    Correctness / data integrity
    - storage: enforce the documented ingest contract (finite + -60..150 C) so
    NaN/inf and the -127 disconnected fault code are rejected with 400 instead of
    500-ing the insert or poisoning stats/exports (PROTOCOL.md §6).
    - storage: guard compute_vpd's SVP denominator against div-by-zero/overflow at
    extreme cold.
    - config_schema: coerce alert_thresholds min/max (a string bound like "30" no
    longer TypeErrors the alert loop an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
2026-07-12 Robustness: fix config races, chart downsampling, off-thread alerts, registry cap
    High-impact reliability fixes from the review (all tested; suite 169→173).
    - config: Config.get() now hands out copies of mutable values so the
    get()->mutate->update() pattern in the device/settings panels can't race a
    concurrent save()'s json.dumps ("dict changed size during iteration") or lose
    updates. Adds a concurrency stress test.
    - db: rewrite window_df downsampling — the old `id % stride` sampler assumed
    contiguous primary keys and could return a BLANK chart or drop whole probes
    once ids had gaps (interleaved writers, delete_probe/purge). Now downsamples by
    per-probe row position (newest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
2026-07-12 Secure-by-default: generate the device token, add SSRF guard + config auth
    Make the code match the security posture the docs already promise (simplest
    path): the mutating API is no longer open on the LAN by default, with zero
    operator friction. Suite 173→176.
    - app: on first run, if no SERVER_TOKEN env and no provision_token, generate a
    secrets.token_urlsafe(24) and persist it to config.json (owner-only, gitignored,
    redacted in the API), logging it once. The auto-provisioner already pushes
    provision_token to probes, so they authenticate automatically — the operator
    never types it, and the read-only dashboard stays open on the LAN as before.
    - api: GET /api/config now requires th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
2026-07-13 Fix upgrade-path gap: auto-provisioner must deliver the token at least once
    The secure-by-default token generation had a hole: the auto-provisioner skips
    re-provisioning when a probe's visible config (server_url/interval) already
    matches, but a probe's token is never exposed by /status. So an already-provisioned
    probe from a pre-token hub would match the skip-check and never receive the newly
    generated token — its ingests would 401 forever (readings buffered on-device
    until the buffer fills, then dropped). Fresh setups were unaffected.
    Fix hub-side (no firmware re-flash needed): force one provision per probe per
    session before trusting the status shortcut, so the current token is always
    d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
2026-07-13 Dashboard polish + a probe simulator for testing alerts
    Make the dashboard read more professionally and fix real mobile-layout bugs:
    - Humanize the "Last Update" KPI — show "20s ago" / "5 min ago" instead of a raw
    ISO timestamp (2026-07-13T21:59:27) that also wrapped mid-word on a phone.
    - Responsive grids: the KPI cards were a fixed 4-wide row that wrapped labels
    mid-word on mobile ("Conn ected Prob es"); they now form a 2x2 grid (xs=6,
    lg=3). Stats stack (xs=12, md=4) and the gauge/history stack (xs=12, lg=8)
    instead of squishing side-by-side on small screens.
    - Consistent muted KPI labels and left alignment (the Unit card was centered).
    - Replace the loud solid-orange demo banne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
2026-07-13 Fix future-dated readings and the misleading alert test
    Two field issues surfaced from a real deployment:
    - A probe with a bad clock stamped a reading ~47 min in the future; the hub
    trusted it, so the chart drew a line past "now" and the bogus point became the
    probe's "latest" reading (which can mask a live threshold breach). The hub's
    clock is authoritative, so clamp any timestamp more than 120s ahead of now to
    the hub's current time. Past/buffered timestamps are preserved. Adds tests.
    - The Settings "Send test" button dispatches to the channels regardless of the
    master "Enable alerts" switch, so a test can report "sent" while live alerts
    are OFF — the usual reason a real br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
2026-07-13 Self-heal future-dated readings already stored in the database
    The ingest-time clamp stops NEW future readings, but a probe clock glitch that
    occurred before the fix leaves a stranded future-dated row in the database that
    the clamp can't reach. Such a row (a) draws the chart past "now" and (b) becomes
    the probe's permanent "latest" reading, which silently masks live threshold
    breaches from the alert monitor — so alerts never fire even when enabled.
    Add db.delete_future_readings() and run it once at startup so an existing
    database self-heals on the next launch. Add a test and confirm end-to-end that
    the newest reading returns to real time.
2026-07-13 Add a 24h/12h clock toggle for the dashboard
    Adds a "🕐 Clock" button-group next to the "Viewing" probe selector, mirroring
    the existing °C/°F toggle pattern exactly (localStorage-persisted dcc.Store,
    button outline sync, no page reload needed). It controls every absolute clock
    time on the dashboard so a customer can flip formats for fast comparison
    against other clocks/logs:
    - Min/Max Temperature "at ..." times (_fmt_clock).
    - The "Last Update" KPI once it falls back to a calendar date (>1 day old).
    - The Temperature History graph's x-axis ticks and unified hover label.
    Default is 24h. Plotly's own default date-axis formatting is already 24-hour,
    so the 24h case sets no overrides and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
2026-07-13 Follow-up hardening: stream CSV, bound DNS + body size, misc robustness
    A second review pass (regression sweep of this session's changes + backlog
    re-verification) surfaced these. All confirmed against the code; 183→189 tests.
    Robustness / DoS
    - app.py: stream /download/temperature_log.csv to a temp file (like backup.db)
    instead of buffering the whole export in memory — a months-long log could be
    hundreds of MB and OOM the process on one click.
    - app.py: set MAX_CONTENT_LENGTH=16MB so a chunked / Content-Length-less POST
    can't stream an unbounded body into memory before the per-route ingest check.
    - provisioning.py: resolve hostnames with a hard timeout (resolve_host) and
    reques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
2026-07-13 Audit: detect tail-truncation via an out-of-band anchor
    The hash chain catches altering or deleting a MIDDLE entry (the next entry's
    prev-link breaks), but deleting TRAILING entries leaves a shorter,
    internally-consistent chain that verify() reported as intact — the exact silent
    edit the audit trail exists to prevent, and a gap for the compliance/procurement
    positioning.
    Persist a sidecar anchor (<log>.tip) with the true entry count + head hash,
    updated atomically on every record(). verify() cross-checks it (and reports
    "anchored"), and configure() flags a mismatch on startup so a truncation that
    happened while the hub was down is surfaced rather than silently re-seeded.
    Honest about the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
2026-07-14 Add restaurant pilot offer + startup (LLC/insurance/FCC) checklist
    - docs/PILOT_OFFER.md: one-page, hand-to-restaurant 30-day loaner pilot
    offer framed as loss-prevention (not HACCP/compliance), with the honest
    "what it is/isn't" and power-outage caveats built in.
    - docs/STARTUP_CHECKLIST.md: LLC + insurance + FCC SDoC order-of-operations
    with rough US cost ranges, grounded in BOM.md/COMPLIANCE.md. Flags the
    ESP32-C3 SuperMini FCC gotcha (bare chip vs. pre-certified module) that
    decides whether the cheap Part 15B SDoC path is even available.
    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
2026-07-14 Confirm ESP32-C3 SuperMini is bare-chip (expensive FCC path)
    Verified the board in use (Amazon B0DFWG87JS) is a bare ESP32-C3FH4 with a
    PCB trace antenna, not a pre-certified module — so it does NOT inherit
    modular FCC approval. Update the checklist gotcha from conditional to
    confirmed, name the drop-in fix (ESP32-C3-MINI-1, FCC ID 2AC7Z-ESPC3MINI1),
    and note the current boards remain usable for pilots/dev/DIY kits.
    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
2026-07-14 Add rev-2 board spec: SuperMini -> pre-certified ESP32-C3-MINI-1
    Drop-in-at-the-design-level spec for the certifiable board revision: same
    70x30 outline, connector placements, GPIO map (DS18B20 IO5, LED IO8), and
    firmware. Documents the support circuitry the SuperMini used to provide
    (LDO, EN reset, boot, IO8 strap, decoupling, UART/USB flashing), the
    official KiCad footprint (RF_Module:ESP32-C3-MINI-1), the antenna keep-out
    rule for keeping the modular grant, and the JLCPCB place-vs-hand-solder split.
    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
2026-07-14 Add rev-2 build guide + product roadmap (kits now, assembled after respin)
    - docs/REV2_BUILD_GUIDE.md: concrete rev-2 BOM (ESP32-C3-MINI-1 + support
    circuit with real part numbers), schematic-driven KiCad steps, JLCPCB
    PCBA ordering, and the certifiable-vs-not summary.
    - docs/PRODUCT_ROADMAP.md: the "what next" doc — honest snapshot, four-phase
    path (shell -> validate -> certify+rev2 -> scale), the two-SKU split, and
    a full DIY-kit playbook (contents, FCC positioning, how to sell).
    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
2026-07-14 Add rev-2 net-by-net schematic + DIY kit playbook
    - docs/REV2_SCHEMATIC.md: complete wireable connection list for the
    ESP32-C3-MINI-1 board (power/LDO, EN, boot, sensor, LED, UART + USB-C
    programming), including the ESP32-C3 GPIO8 strapping-pin gotcha (LED must
    be active-low) and a pre-Gerber checklist.
    - docs/DIY_KIT.md: friction-removal playbook for the kit SKU — pre-flash
    everything, a no-solder "Plug-Together" tier, foolproof card + known-good
    test, and listing/ops guidance.
    - REV2_BUILD_GUIDE.md: correct the LED wiring to active-low to match.
    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
2026-07-14 Review pass: harden rev-2 schematic + kit plan
    Rev-2 schematic:
    - Clarify the two power builds (restaurant = USB-only, drop the battery;
    portable = battery) and warn that a basic TP4056 has no load-sharing.
    - Add optional probe-line hardening (series R + TVS) for long walk-in runs.
    - Note IO2 strapping relies on the internal pull-up; add ceramic-cap and
    test-point items to the pre-Gerber checklist.
    DIY kit:
    - Add a lithium-safety line to the kit card contents.
    - Add a "test every probe before bagging" QC step (dead DS18B20 = return).
    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
2026-07-14 Add Kelvin as a dashboard temperature unit (°C / °F / K)
    Adds a third unit toggle on the dashboard. Centralizes the unit symbol in
    a _unit_symbol() helper (used by the gauge suffix, chart trace name, and
    y-axis title), extends _convert() with K = °C + 273.15, and wires the new
    button through the toggle + button-sync callbacks. Kelvin renders without a
    degree symbol ("298.1 K"). Internal storage and alert thresholds remain in
    Celsius; this is display-only. Adds a Kelvin dashboard test.
    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
2026-07-14 Rebrand business docs to Setpoint, by Datum Labs
    Adopt the house-company + product-brand model across the go-to-market
    assets: product = Setpoint, company = Datum Labs.
    - Rename the product from "TempSensor" to "Setpoint" in the pilot offer,
    store/Tindie listings, GTM strategy, launch runbook, roadmap, DIY kit
    playbook, and startup checklist.
    - Fill the "[YOUR BRAND]" placeholders and brand-swap notes now that the
    name is decided; add the "by Datum Labs" company signature where a
    maker byline is natural.
    - Preserve the literal setup-SSID strings (TempSensor-XXXXXX /
    TempSensor-<HEX>) since those are broadcast by the current firmware;
    renaming the device identity is a separate, c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
2026-07-14 Rename product/device identity TempSensor -> Setpoint
    Complete the rebrand to "Setpoint, by Datum Labs" end to end so the device,
    hub app, and integration surfaces all carry the new name. Case-sensitive swap
    (TempSensor->Setpoint, tempsensor->setpoint) across firmware, hub, tests,
    docs, config, flash page, and packaging brand strings.
    Device identity:
    - Firmware setup-AP SSID / probe id prefix is now "Setpoint-XXXXXX"
    (protocol.h PROBE_ID_PREFIX, esp32_temp_probe.ino buildProbeId/SENSOR_NAME,
    factory_flash.py) and the hub SSID watcher (setup_helper.py) matches.
    - mDNS hub instance is "Setpoint Hub"; app data dir is "Setpoint".
    Integration surfaces (breaking, but pre-launch — nothing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
    [esp32_temp_probe.ino, factory_flash.py]
2026-07-14 Add shareable action-plan page, pre-order copy, materials/gaps companion
    - docs/action-plan.html: a polished, shareable one-page version of the master
    action plan (Setpoint/Datum Labs brand system: teal accent + mono readout
    labels, light/dark, setpoint-line hero glyph). Published as an artifact.
    - docs/PREORDER.md: paste-ready founding-batch pre-order copy — Stripe Payment
    Link fields, checkout/thank-you/email copy, landing "reserve" block, launch
    posts, and an FTC mail-order checklist. Leads with a $15 refundable deposit.
    - docs/MATERIALS_AND_NEXT_STEPS.md: companion to the action plan — a costed
    materials/tools shopping list (~$1,200 realistic), a 4-gate readiness ladder,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
2026-07-14 Define two product versions: Portable (battery) and Fixed (USB)
    Formalize the battery-vs-USB split as two distinct versions instead of an
    inconsistent power story across docs. Same carrier board, same DS18B20 probe,
    same firmware image — only the power hardware and read interval differ:
    - Portable: battery + TP4056 + switch; deep-sleeps between reads (<1 mA); a
    movable "tool" for homelab/portable use. Interval >= 10s (firmware default).
    - Fixed: USB-C always-on, no battery; continuously reachable live readings;
    for fixed installs (walk-in, rack, greenhouse) and restaurant loaner pilots.
    Interval < 10s (or DEEP_SLEEP_ENABLED=false).
    - Add docs/VERSIONS.md as the single source of trut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
2026-07-14 Fix status-LED pin/polarity for the ESP32-C3 SuperMini (rev-1 board)
    The firmware + BOM targeted the ESP32-WROOM-32 (status LED GPIO2, active-high),
    but the rev-1 boards are ESP32-C3 SuperMini, whose onboard LED is GPIO8,
    active-LOW — and GPIO8 is a boot strapping pin. Driving it as active-high (or
    leaving the WROOM default) mishandles the LED and risks the boot-strap.
    Firmware (esp32_temp_probe.ino, protocol.h):
    - Select the status LED by build target: on CONFIG_IDF_TARGET_ESP32C3 use
    GPIO8 + LED_ACTIVE_LOW=true; otherwise keep GPIO2 active-high (WROOM). One
    image fits both boards; the ledInit/ledOn/ledOff helpers already honor
    LED_ACTIVE_LOW, so no call-site changes.
    - GPIO8 is bo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
    [esp32_temp_probe.ino, protocol.h]
2026-07-14 Honesty + consistency fixes across the shipping docs
    - QC_CHECKLIST: add step 5.3 ice-bath 0 °C check (must read 0 ± 0.5 °C) so
    the "verified at 0 °C to within ±0.5 °C" claim is earned, not asserted;
    add a version-aware reachability note (Portable deep-sleep vs Fixed).
    - LABEL_TEMPLATE: add `ice_c` and `version` (Portable/Fixed) columns to the
    serial-log CSV spec + examples.
    - LISTING / TINDIE_LISTING: the setup Wi-Fi is an OPEN SoftAP — stop calling
    it "Wi-Fi name & password" (there is no password to print).
    - PILOT_OFFER: disclose the internet-outage caveat (remote text/email/Slack
    alerts pause on a WAN drop; on-screen alarm still shows; keep the alert
    phone on cellular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
2026-07-14 Add ROI calculator + hub-reliability SOP; close review/COGS/security gaps
    - docs/roi-calculator.html: an interactive cold-storage ROI calculator
    (branded Setpoint/Datum Labs, light/dark) — set a kitchen's cold units,
    product value, failure likelihood and probe price, and it shows the yearly
    preventable loss, the one-time cost, and the payback period. A pilot-closing
    tool for the highest-$ channel. Published as an artifact.
    - docs/HUB_RELIABILITY.md: one-page uptime SOP for pilot/production installs —
    auto-start per OS (NSSM service / systemd / launchd / Docker restart),
    firewall + DHCP reservation, weekly export, and a prove-it reboot test.
    - GO_TO_MARKET §6: honest LAN-trus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
2026-07-14 Add START_HERE.md — the dependency-ordered founder action checklist
    A top-level, tickable checklist that distills the whole go-to-market into a
    sequence: 3 do-today actions (LLC/EIN, domain+support email, compile the
    firmware), then Phase 1 (this week), Phase 2 (boards arrive), Phase 3
    (month 2-3), and the FCC gate. Includes a "which doc for what" index. Points
    into ACTION_PLAN, MATERIALS_AND_NEXT_STEPS, PREORDER, PILOT_OFFER, DIY_KIT,
    QC_CHECKLIST, HUB_RELIABILITY, VERSIONS, and the two interactive pages.
    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
2026-07-14 Refresh the hub UI: cohesive, professional Setpoint design system
    Rework the dashboard visuals to match the Setpoint / Datum Labs brand and read
    as a polished product rather than a generic dev dashboard. Verified against the
    running app (192 tests still green; computation unchanged).
    - assets/theme.css: a real design layer over CYBORG — teal brand accent, cool
    layered dark surfaces with depth, monospace uppercase "readout" labels for
    KPIs, refined cards/buttons/inputs/badges, semantic stat colours (no more
    off-brand rainbow), a quiet ghost Help button (was a jarring magenta), and a
    tidied Plotly toolbar. System fonts only (offline/CSP-safe).
    - layout_main.py: wire the real logo.sv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
2026-07-14 UI polish: reconcile footer/counter, center KPI cards
    - Footer now agrees with the dashboard's "Connected Probes". hub_status()
    gains a reporting_online arg (probes freshly reporting to the DB), and the
    footer callback feeds it _reporting_probe_count() — so a deep-sleep or
    demo probe that posts but isn't mDNS-visible reads "online" in both places
    instead of the footer showing "idle" while the dashboard shows live probes.
    Adds two tests for the new path.
    - KPI/stat cards vertically center their content (via .metric-row/.stat-row),
    so equal-height cards read as intentional rather than top-aligned with empty
    space; the °C/°F/K toggle stays compact.
    Devices, Settings, and Diag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
2026-07-15 Diagnostics: show DB-reporting probe count, matching the dashboard
    build_diagnostics() now also computes probes freshly reporting to the DB
    (within max(online_timeout, 5 min)) and the Diagnostics summary shows it as
    "N reporting · M discovered (mDNS)". A deep-sleep probe that posts but is never
    mDNS-visible now reads consistently with the dashboard/footer instead of the
    page showing "0 online / 0 total". Additive field; existing tests unaffected.
    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
2026-07-19 Rebrand flasher page to Setpoint identity + add hardware cross-sell
    Restyle flash/index.html to the Setpoint / Datum Labs brand tokens (teal
    accent, monospace readout labels, dark instrument theme) so it matches the
    dashboard and marketing pages. Add a firmware-version badge, clearer
    'already factory-flashed -> this is for updates/recovery' messaging, and a
    cross-sell section (finished unit + DIY kit) to convert update/recovery
    traffic. STORE_URL / KIT_URL / SUPPORT_URL are placeholders to fill in
    before publishing. ESP Web Tools install button + manifest wiring unchanged.
    Claude-Session: https://claude.ai/code/session_012ShNZ2F5sjuwoK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
2026-07-19 Add GitHub Pages workflow to build + host the browser flasher
    Add .github/workflows/deploy-flasher.yml: compiles the ESP32-C3 merged
    firmware image (arduino-cli, esp32 core, no_ota partition scheme via
    flash/build_merged_bin.sh) and publishes the flash/ folder to GitHub Pages
    on main pushes touching the firmware/flasher, and on workflow_dispatch. The
    generated (gitignored) binary is rebuilt fresh and shipped in the Pages
    artifact.
    Point flash/index.html's doc links at a GUIDE_URL placeholder: the folder
    is served as the Pages site root, where repo-relative ../docs and
    ../firmware links would 404.
    Claude-Session: https://claude.ai/code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
2026-07-19 Add Setpoint start hub at Pages root; flasher moves to /flash/
    Add web/index.html — a brand-matched hub (build guide, flasher, dashboard
    download, support) that the card and 3D-embossed-case QR land on. Update
    deploy-flasher.yml to publish the hub at the site root and the flasher under
    /flash/, and to write a CNAME file binding setpoint.datumlaboratories.com so
    the custom domain persists across GitHub Actions Pages deploys.
    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
2026-07-19 Build out Setpoint hub: host build guide + wire live links
    Add web/guide.html — a brand-styled hosted version of the DIY kit build
    guide (buyer-facing; seller-only notes stripped). Wire web/index.html's
    placeholder links to live destinations: guide -> /guide.html, dashboard ->
    GitHub releases, store/company -> datumlaboratories.com, support -> mailto.
    Update deploy-flasher.yml to publish every web/*.html so guide.html ships.
    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
2026-07-19 Polish sites + fix user-facing brand leftovers
    - Fix three user-facing old-name strings the rename missed: the DB backup
    download filename (setpoint_backup.db), the default notification sender
    (setpoint@localhost), and the db.py docstring. The mDNS wire protocol
    (temps-hub.local / _temps-probe._tcp) and packaging identifiers are left
    as-is: they are intentional per the CHANGELOG (changing them breaks
    probe/hub discovery and the release pipeline).
    - Add a favicon (inline SVG thermometer) + Open Graph/Twitter tags to the
    hub, build guide, and flasher for proper tab icons and link previews.
    - Fill the flasher's remaining link placeholders (guide, store, kit,
    support) so no page ha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
2026-07-19 Site + safe code fixes from codebase sweep
    Site (customer-facing):
    - guide.html: fix the DEAD flasher link in the flashing step (was a literal
    placeholder; now links to the hosted flasher), fix a run-on list in Step 1,
    link the dashboard, add meta description/OG/canonical/focus styles, drop a
    stray trailing rule.
    - flasher: point the arduino-cli fallback links at the real firmware/README
    (they looped back to the guide, which has no CLI content); add canonical +
    focus styles; prefill the support mailto subject.
    - hub: add canonical + focus-visible; prefill support mailto.
    - Add a branded 404 page.
    Code (safe, tested; 194 passing):
    - Security: /api/diagnostics no longer leaks the ab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
2026-07-20 Firmware v2.4.1: buffer offline readings during Wi-Fi outages
    A deep-sleep probe restored its RTC clock only inside the 'if (WiFi
    connected)' branch, and g_timeValid resets to false each wake. So a probe
    that woke during a Wi-Fi/router outage never got a valid timestamp and
    bufferAppend() dropped the reading (empty ts) instead of buffering it —
    defeating the offline buffer in exactly the scenario it exists for.
    Hoist the RTC restore out of the Wi-Fi guard so the clock is valid whenever
    the probe has synced at least once, regardless of current connectivity.
    Online NTP (initial sync + periodic resync) behaviour is unchanged.
    Bump FW_VERSION + flash/manifest.json to 2.4.1 (firmware behaviou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
    [esp32_temp_probe.ino]
2026-07-20 Merge #21: fix dashboard freeze on load (duplicate callbacks) — hub v2.4.1
    The dashboard shipped in v2.4.0 rendered its shell (navbar + footer) but
    stayed frozen on "Status: starting…" with an empty page — no callback ever
    fired. Root cause: components/dashboard_view.py contained a second, identical
    copy of the clock-format callback block, so `clock-format-store.data` and the
    24h/12h button outlines were each claimed by two callbacks with no
    `allow_duplicate`. Dash's browser renderer rejects the ENTIRE callback graph
    on load when that happens, which freezes the whole dashboard.
    The Flask/Dash server registers both callbacks without raising and every
    server-side / build_dashboard unit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
2026-07-20 Merge #22: CI/release housekeeping — Node-24 action bumps + auto release notes
    Silence the Node 20 deprecation warnings by bumping the actions that were
    still pinned to the Node 20 runtime to their established Node-24 majors:
    - actions/checkout v4 -> v5
    - actions/setup-python v5 -> v6
    - softprops/action-gh-release v2 -> v3 (tag_name/files/body inputs unchanged)
    across release.yml, ci.yml, and deploy-flasher.yml.
    Also auto-populate every GitHub Release's notes from a committed
    packaging/RELEASE_NOTES.md via action-gh-release's body_path (wired into all
    three build jobs so the body is deterministic regardless of job order). The
    notes carry the per-OS download table and the "f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
2026-07-20 Merge #23: dashboard freshness unification + stale-alert/focus-KPI/devices fixes
    Follow-up to the dashboard code review. "Is this probe fresh?" was answered ~6
    different ways, so the same probe could read differently on one screen. Extract
    the interval/offline-aware window into a single shared helper
    (core.status.probe_fresh_window) and use it everywhere, fixing the fallout:
    - Alert banner + "needs attention" gauge now skip stale/offline probes, so a
    probe that breached once then went silent stops showing a red alert (it now
    agrees with its own "● stale" card and Connected Probes: 0).
    - Focus mode "Last Update"/heartbeat track the FOCUSED probe's own latest
    reading, not the hub-wide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
2026-07-20 Merge #24: bump hub to v2.4.2 (release prep)
    HUB_VERSION 2.4.1 -> 2.4.2 so the dashboard freshness/consistency fixes (PRs
    #21/#23) ship in a versioned release, and the installer's reported version
    matches the release tag. Rolls the accumulated [Unreleased] notes under a
    [2.4.2] heading and opens a fresh [Unreleased].
    No functional change — release bookkeeping only. Cut v2.4.2 via
    Actions -> release -> Run workflow -> version 2.4.2 (builds from this).
    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
2026-07-21 Merge #25: preserve graph zoom/pan across auto-refresh (uirevision)
    The temperature history graph is rebuilt every 5s by the refresh callback, which
    reset any zoom/pan the user had applied back to the default view. Set Plotly's
    `uirevision` on the figure layout, keyed to (time_range, temp_unit, focus): while
    those stay the same a plain data tick keeps the interacted view, but changing the
    range/unit/focused-probe (a genuinely new data domain) still resets it.
    Adds a regression test asserting uirevision is present, stable across a refresh,
    and changes on range/unit change.
    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
2026-07-21 Merge #26: Setpoint v2.4.6 + firmware v2.6.0 — data API, freezer firmware, provisionable resolution
    Hub 2.4.3 → 2.4.6, firmware 2.4.1 → 2.6.0.
    Hub: read-only JSON API (GET /api/readings[/latest]); unified "online/reporting"
    across dashboard/Diagnostics/API/metrics; /metrics ghost-series eviction +
    setpoint_probes_online gauge; dashboard polish (blended-average, Devices status
    words, alert-block dim, Help integrations); millisecond timestamps end-to-end;
    graph ISO8601 parse fix so mixed second/millisecond windows render.
    Firmware: millisecond timestamps; adaptive disturbance-burst (freezer door) with
    a battery cap; Wi-Fi reconnect backoff; periodic provisioning window; DS18B20
    11-bit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
    [esp32_temp_probe.ino]
2026-07-21 v2.5.0 part 1: events, rate alerts, daily summary, battery, offline-alert fix, perf
    Backend + dashboard slice of the four-bundle review implementation.
    Alerting (the #1 review bug): the offline notifier now judges every probe by its
    own interval-aware freshness window (core.status.probe_fresh_window) instead of
    one flat global timeout, so a 10-min deep-sleep freezer probe no longer flaps
    offline/online every wake (~288 spurious emails/day); DEMO- probes never alert.
    Evaluation and event recording are decoupled from the notifications master
    switch (only dispatch is gated). Hysteresis-held reminders now say the truth
    ("still HIGH ... has not yet cleared the limit by the deadband") and the UI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
2026-07-21 dashboard: swap remaining colour OS emoji for geometric marks
    Onboarding heading, demo button/banner, alert-banner prefixes (now the same
    ▲/▼ glyphs as the probe-card badges) and the humidity card drop their colour
    emoji, finishing the instrument-aesthetic cleanup the visual review called for
    (OS emoji render inconsistently across platforms and clash with the mono/teal
    readout styling). Geometric dingbats (● ▲ ▼ ✓) stay — they are deliberate.
    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
2026-07-21 v2.5.0 part 2: theme+PWA, unit-aware settings UX, MQTT UI, provisioner, firmware v2.7.0, docs
    Completes the four-bundle review implementation started in part 1.
    Theme/PWA: per-state badge washes (LOW no longer magenta), cool-blue low
    alerts, --text-faint contrast to AA, color-scheme dark, kpi-value scale,
    pulsing CSS LIVE dot, duplicate demo-banner rule removed; web-app manifest +
    meta for add-to-home-screen.
    Settings/Devices UX: thresholds + calibration display and accept the active
    unit (delta-correct offset math, stored C canonically); notifications
    breadcrumb with live On/Off state in the edit modal; pencil emoji replaced by
    an Edit button; battery shown on Devices cards; MQTT configur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
    [esp32_temp_probe.ino, factory_flash.py, protocol.h]
2026-07-22 Add Excel-friendly CSV and native .xlsx data exports
    The dashboard's Export dialog previously offered one raw ISO CSV. Its
    timestamps (2026-07-21T22:45:36.267) are imported as inert text by Excel,
    so they don't sort or filter -- the opposite of what a non-technical user
    expects when they double-click the file.
    Add two spreadsheet-oriented formats alongside the unchanged canonical
    CSV, selected via a new optional ?format=excel|xlsx|raw parameter on
    /download/temperature_log.csv (default raw, so existing links are
    unaffected):
    - Excel-friendly CSV (now the dialog default): date and time split into
    separate, spreadsheet-parseable columns (hub-local wall clock), the
    probe's friendly name a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
2026-07-22 Fix Temperature History y-axis zoom resetting on every refresh
    The earlier uirevision fix preserved the user's zoom on the time (x) axis
    but not the temperature (y) axis, so a box-zoom -- which pans both --
    appeared to snap back on every 5-second auto-refresh.
    Root cause: the y-axis pinned an explicit yaxis.range recomputed from the
    window's live min/max each tick. Plotly preserves a user's zoom under a
    stable uirevision only while the figure's own specified value for that
    attribute is unchanged; a range whose value drifts with the data is
    treated as a programmatic override and discards the zoom. The x-axis had
    no explicit range, which is why it stuck.
    Carry the auto-fit (data padding + th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
2026-07-22 Fix DIY-kit flashing docs: power switch OFF, not ON
    The web flasher page and the DIY build guide told buyers to flash with the
    power switch ON. On the kit the switch only gates the battery->ESP32-C3
    path, so the SuperMini's own USB-C powers the board for flashing whatever
    the switch position -- and leaving it ON lets USB power back-feed the cell
    through the TP4056 (uncontrolled, bypassing its charge circuit).
    - flash/index.html: flash with the switch OFF (phrased conditionally, since
    a bare SuperMini has no switch), with the back-feed rationale.
    - web/guide.html Step 5: flash with the switch OFF.
    - web/guide.html Step 4 (power check): clarify USB powers the board directly
    with the switc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
2026-07-22 Reconcile DIY_KIT playbook to buyer-flashes model
    The kit playbook advocated pre-flashing every board; the kit now ships
    un-flashed and the buyer flashes it in-browser (one-click ESP Web Tools).
    Update the strategy to match:
    - "Kill fear #1" reframed from "pre-flash every board" to "make browser-
    flashing one click" — with the data-cable / Web-Serial-browser gotchas,
    the switch-OFF-while-flashing note, and pre-flash kept as an optional path.
    - Bag contents: SuperMini is buyer-flashed, not pre-flashed.
    - Ops: QC the loose DS18B20 probe on a bench rig (the likely-bad part) rather
    than powering a pre-flashed board — the buyer's first flash + power-on is
    the functional test.
    - Retur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
2026-07-22 Draft DIY-kit COGS + tighten Tindie listing to the real kit
    Prep for the DIY-kit listing while the first board is being built.
    BOM.md: add a "DIY kit COGS & margin (buyer-assembled, board-only)"
    section — the actual kit as it ships (carrier PCB + modules, board-only,
    cell-not-included, JST pre-terminated, buyer flashes in-browser). Real
    per-kit landed cost ~$12.32 at qty 10, with a margin table at $39/$44/$49
    (assumptions stated: ~8% fees, 4% returns, buyer-paid shipping) and a
    ~$44 recommendation. This is separate from the assembled-unit pricing.
    TINDIE_LISTING.md: align the copy with the kit that actually ships —
    - price/options point at the ~$12 kit COGS and ~$44 list price;
    - a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
2026-07-22 Bundle USB-C data cable in kit; set $39 launch price
    Per pricing decision: include a guaranteed data cable (kills the #1
    "flasher can't see my board" charge-only-cable ticket) and launch at $39
    to seed the first reviews, raising to $44-49 with traction.
    BOM.md: add the USB-C data cable to the kit COGS (landed ~$12.32 -> ~$14.07),
    drop it from "not in the kit," recompute the $39/$44/$49 margin table
    (still ~52% at $39 with the cable), and reframe the recommendation to a $39
    launch. Note to bundle a real data cable, not charge-only.
    TINDIE_LISTING.md: price/options reflect ~$14 COGS and a $39 launch (-> $44-49);
    "What's in the box" now lists the data cable and drops it from not-included.
    Do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
2026-07-22 Specify the "buy this cell" battery everywhere; fix kit card flash flow
    Cell-not-included was the last gap to the kit feeling complete. Make the
    exact battery to add unmistakable across all three buyer touchpoints, and
    reconcile the quick-start card to the buyer-flashes model.
    - kit-quickstart-card.html: drop the stale "your probe is pre-flashed"
    claim, add a "Flash it (browser, switch OFF)" step, rename the QR to
    "Flash from your browser," and turn the footer battery line into a
    specific spec (reputable 18650, ~2500-3500 mAh, flat-top or protected,
    avoid counterfeits) with "not included."
    - BOM.md: expand the DIY-kit "not in the kit" note into a "buy this one
    cell" spec + counter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
2026-07-23 Document BOOT+RST download-mode fix for blank C3/S3 flashing
    A new/blank ESP32-C3 (or S3) can repeatedly connect/disconnect over USB
    instead of holding a stable port for flashing. The reliable fix is to
    force ROM download mode: hold BOOT, tap RST, release BOOT.
    - flash/index.html: step 2 now names the "keeps connecting and
    disconnecting" symptom and gives the BOOT/RST sequence (plus the
    data-cable reminder).
    - web/guide.html: troubleshooting adds a "port drops / board keeps
    re-connecting" row with the same fix; the existing port row is trimmed
    to the cable/browser causes.
    - CHANGELOG: note under Unreleased.
    Docs only; no code change.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
2026-07-23 Rewrite ASSEMBLY.md as illustrated C3-kit guide + image manifest
    The stale ASSEMBLY.md described the old ESP32-WROOM/GPIO2 hand-wired build.
    Replace it with a photo-illustrated, start-to-finish guide for the actual
    C3 SuperMini carrier kit, built from the real assembly walkthrough:
    - Steps: solder ESP -> TP4056 (tweezer-level) -> switch/4.7k/DS18B20 (JST
    notch to edge) -> battery wiring -> pre-power meter checks -> browser
    flash (switch OFF, BOOT/RST download-mode fix, pick USB JTAG/serial) ->
    power on -> Wi-Fi provisioning (Setpoint-XXXX AP, 192.168.4.1) -> live
    dashboard, plus a troubleshooting table.
    - Accurate to the kit: GPIO5 DS18B20, GPIO8 LED, cell-not-included spec,
    bundl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
2026-07-23 Reorder assembly guide to trace-side-first; fix image filenames
    Match the maker's actual build order and committed photos:
    - Swap steps 2 and 3: solder the switch + 4.7k + DS18B20 connector FIRST
    (step 2, "trace side complete"), then mount the TP4056 (step 3).
    - Correct filenames to the committed images: step 2 ->
    02-switch-resistor-probe.jpg, step 3 -> 03-tp4056-solder.jpg.
    - Drop the separate 03b-jst-notch.jpg reference (not provided); keep the
    notch-orientation guidance as text.
    - Image manifest updated: steps 1-4 marked committed; note that step 5
    (pre-power meter checks) is intentionally text-only (no photo); steps
    6-9 images still to commit.
    Docs only; no code change.
    Co-Au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
2026-07-23 Add complete-module photo to Step 4; fix 09 filename typo
    - Embed 05-complete-module.jpg at the end of Step 4 (all soldering done,
    holder wired) as the closer before the Step 5 meter checks.
    - Rename the committed 09-wifimanger.jpg -> 09-wifimanager.jpg so the
    guide's reference resolves (was a broken link).
    - Manifest updated: all 11 images committed; guide fully illustrated.
    Verified: every image referenced in ASSEMBLY.md exists and every committed
    image is used.
    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
2026-07-23 Add kit-contents photo; fix stale v2.4.1 firmware display strings
    - Embed 12-kit-contents.jpg in the ASSEMBLY.md "What's in the kit" opener
    (noting the bundled USB-C cable isn't pictured). Manifest updated.
    - flash/index.html and web/guide.html displayed "firmware v2.4.1"; the
    shipping firmware and flash/manifest.json are 2.7.0. Both display strings
    now read v2.7.0 (manifest was already correct).
    - CHANGELOG noted under Unreleased.
    Docs/web only; no code change.
    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
2026-07-23 Illustrate web/guide.html; ship guide images in the Pages deploy
    - guide.html: embed the 12 build photos (hero finished-unit, kit contents,
    and one/two per step) as responsive <figure class="shot"> blocks, sourced
    at img/assembly/*.jpg (site-root-relative, where guide.html is served).
    - deploy-flasher.yml: copy docs/images/assembly/*.jpg into _site/img/assembly/
    during site assembly (previously no images were published), and add
    docs/images/assembly/** to the deploy trigger paths.
    Verified: all 12 img refs resolve to committed files; figures balanced;
    full test suite green (306 passed).
    Docs/web/CI only; no app code change.
    C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
2026-07-23 Launch prep: Recent-events fix, listing/BOM/packing docs, and marketing site (#28)
    Recent Events feed: coalesce connectivity flaps + relative timestamps, and fix a
    bug (found by an adversarial audit) where connectivity churn could evict a real
    alert from the feed before coalescing — alerts and connectivity now query
    separately, kind-filtered in SQL. Hub → 2.6.2 with a regression test.
    Docs: reconcile versions/COGS/weights across README, DEVELOPING, TINDIE_LISTING,
    BOM, ASSEMBLY; finalize the $39 Tindie listing, kit packing SOP, and real
    batch-of-50 COGS.
    Marketing site: bring datumlaboratories.com into the repo under site/ (DIY card
    corrected to $39 + live Tindie link), add a Cloudflar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
2026-07-23 Marketing site: /work services page, contact form, SEO tags, waitlist reframe (#30)
    Add a Datum Labs /work services page (embedded/IoT, embedded vision/AR-VR,
    3D printing) with a contact form backed by a Pages Function that reuses the
    existing WAITLIST KV binding + WAITLIST_TOKEN (no new Cloudflare setup). Add
    og:image, meta description, canonical, and Product/Organization JSON-LD to the
    homepage, plus Work nav/footer links. Reframe the waitlist to the small first
    batch of 20 assembled units now that the DIY kit is live on Tindie.
    Static site + Pages Function only; hub app and its 310 tests untouched.
2026-07-24 Marketing site: mobile nav, sitemap/robots, 404 page + battery-copy fix (#31)
    Add a mobile hamburger menu (the top nav was hidden on phones with no fallback),
    robots.txt + sitemap.xml for indexing, and a branded 404 page. Reconcile the
    Battery tier's "Weeks-months per charge" to "weeks" to match the rest of the copy.
    Static site only; hub tests untouched.
2026-07-24 Hero: lead with the buyable kit CTA; fix over-promised alert copy (#32)
    Make "Get the kit — $39" (→ Tindie) the hero primary CTA and "Reserve assembled"
    secondary, so the homepage leads with the only currently-buyable item. Soften the
    lede from "over Wi-Fi, straight to your phone" (implied a push app) to "by email
    or webhook, straight to your phone." Static site only.
2026-07-24 Rename Work→Services, add always-on note, clarity fixes (#33)
    Rename the services page/tab and URL from Work to /services; add an honest
    "needs an always-on machine you already keep on" note to the homepage framed as
    the reason no-cloud works; "rev-2 board"→"core board" and hero CTA→"Get the DIY
    kit — $39" for clarity. Static site only.
2026-07-24 Add homepage FAQ section with FAQPage structured data (#34)
    Condensed FAQ (no cloud/account, required computer, accuracy, Wi-Fi, battery,
    open firmware) as a no-JS details accordion before the reserve CTA, plus matching
    FAQPage JSON-LD and a footer link. Static site only.
2026-07-25 Implement POST /api/ingest_csv (bulk backlog drain) (#35)
    Add the hub bulk-ingest endpoint PROTOCOL.md §7 specified but never implemented:
    accepts a chunk of buffered readings (CSV — the probe's buffer format — or JSON,
    ≤1000 rows) in one request, validates each like /api/ingest, and writes them in a
    single db.bulk_insert transaction. Fixes the slow one-POST-per-reading backlog
    drain seen in the freezer test. Single-reading /api/ingest unchanged; 314 tests
    pass. Matching firmware (chunked flush + keep-alive) and the cold-boot Wi-Fi
    reconnect fix ship separately.
2026-07-25 Website: /about page + field-test docs (#36)
    Publish the /about page (evidence-forward Datum Labs trust page, wired into nav/footer/sitemap) and the field-test docs (BATTERY_FIELD_TEST + report, FIELD_TEST_2 plan, roadmap firmware/hardware backlog). site/ + docs/ only; no code change.
2026-07-25 Hub bug fixes: rate alert, date-range, auto-provisioner (#37)
    Rate-of-change alert uses the true window-old sample (index-backed oldest_temp_c_in_window); ?to= date range includes the final second's sub-second rows; auto-provisioner prunes evicted-probe bookkeeping and re-verifies /status periodically; collapse _csv_safe/_xlsx_safe. Hub-only, 315 tests passing.
2026-07-27 Add /replacement-parts landing page + quote intake (photos, EXIF stripping, CamScan) (#38)
    * Add INCOME_STREAMS.md — revenue paths beyond Setpoint hardware
    ACTION_PLAN.md monetizes the Setpoint product (pre-orders, pilots, Tindie),
    all of which are gated on parts arriving and the FCC path. This adds a
    companion doc covering ten income streams that monetize the skillset
    instead — no boards, no SDoC, no inventory.
    Structured to match ACTION_PLAN's conventions (first-dollar / per-sale /
    first-3-actions / gotcha) and ranked by speed-to-first-dollar:
    - Tier A (days): local smart-home & network installs, freelance
    firmware/PCB contracting, Jetson edge-vision contracting,
    design-for-prin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
2026-07-27 Simplify /replacement-parts; reframe gallery as honest capability demo (#39)
    - Collapse the four fabricated case studies into one clearly-labelled demo
    build (not a customer job), with broken/measured/printed slots ready for
    real photos. Drop the loud amber build-note box.
    - Condense the CamScan section from a three-card grid to one tight paragraph
    plus the CTA (button/note IDs unchanged, so the gating script still works).
    - Trim verbose copy in 'What I make' and pricing; remove now-unused .todo CSS.
    - Update site/README to describe filling the single demo case.
    Price, turnaround, and free-first-part facts unchanged (stay in sync with the
    outreach email copy).
    Claude-Session: https: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
2026-07-28 Quote form: guided per-angle photo capture (#40)
    Replace the single multi-file drop with one capture tile per orientation, so a
    shop is guided through the shots that help a quote instead of a generic 'add up
    to 6'. Each photo carries its angle label end-to-end:
    - Front end: a tile grid (each with its own camera/library input) reusing the
    existing canvas resize + EXIF-strip pipeline; tap to take/choose, thumbnail
    with a remove button, at least one required.
    - Backend: parse the aligned 'angles' array, fold the label into the stored
    filename (photo-1-top.jpg) and each record's photo entry, and list the angles
    in the notification email (for when Resend is enabled).
    Claude-Session: ht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
2026-07-28 Replacement-parts: CamScan in-page embed + measured-view intake, and simple-funnel reorg (#41)
    * Quote form: guided per-angle photo capture (Top/Front/Back/Left/Right/Detail)
    filename (photo-1-top.jpg) an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
2026-07-28 Quote form: tap-to-preview scanned photos with calibration read-out (#42)
    Tapping a filled angle tile now opens a full-size preview so a shop (or you) can
    confirm a CamScan scan ran cleanly before submitting. For measured views it shows
    the calibration state (Calibrated / tilt-corrected / no-scale warning) and the
    list of measurements; for plain uploads it just enlarges the photo. Replace and
    Remove live in the preview; empty tiles still open the camera. Carry scale +
    measurements onto each ingested view so the preview can report them.
    Claude-Session: https://claude.ai/code/session_01WmpteQMej7oW1aSKPxxY1C
2026-07-28 Measure section: guide people through the CamScan flow (#43)
    Now that the in-page measuring tool is live, expand the 'Want to measure it
    yourself?' section from a bare CTA into a 3-step walkthrough that mirrors the real
    flow: auto scale/tilt from a marker or coin, pick the view angle and mark up each
    photo (add more angles), then Review & Submit drops the measured photos straight
    into the quote form. Copy notes it opens in-page and hands photos to the form.
    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
2026-07-28 Simplify replacement-parts: one primary action, tighter order, hide placeholder demo (#44)
    - Reserve the bright 'signal' button for the conversion action only: the optional
    measuring tool's CTA becomes a ghost button.
    - Reorder so the post-form sections answer a shop's real questions first — What I
    make (scope) and Pricing — with the optional CamScan tool demoted below them.
    - Fix stale copy: the Measure section said 'the form below' but the form is above
    it; now position-neutral ('your quote form').
    - Hide the capability-demo gallery (empty 'Photo slot' placeholders read as
    unfinished on a live page); one 'hidden' attribute + a note to re-enable once
    real demo-part photos are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
2026-07-28 Tiered pricing + general print services; marketplace listing drafts (#45)
    - Replace the single price card with four tiers: print-from-your-file
    (material + $15, doubles as general print services), simple replacement
    ($29-60), reverse-engineered ($75-250), design from scratch (quoted). Add a
    details line: $25 minimum, free quotes, repeat discount, 24h quote / 3-5 day
    ship, first simple part free for repair shops.
    - Hero trust bar: 'Most parts $75-250' -> 'Parts from $29' to match the new entry.
    - 'What I make' now invites general print jobs (send your own file).
    - Grid flows to 4 cards (auto-fit).
    - Add docs/ETSY_EBAY_LISTINGS.md: ready-to-paste made-to-order Etsy + eBay copy
    (title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
2026-07-28 SEO: structured data, FAQ section, sharper title for /replacement-parts (#48)
    On-page SEO for /replacement-parts so it can surface in search:
    - Service + FAQPage JSON-LD (structured data) in <head>; FAQPage can earn an
    FAQ rich result.
    - Visible 7-question FAQ section mirroring the JSON-LD (long-tail query coverage:
    cost, materials, turnaround, print-your-file, 'part no longer available').
    - Broader keyword-rich <title> ('Custom & Replacement 3D Printed Parts') + meta
    description/OG refresh + keywords meta.
    - robots.txt already allows all + points at the sitemap (the page is in sitemap.xml).
    Claude-Session: https://claude.ai/code/session_01WmpteQMej7oW1aSKPxxY1C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
2026-07-28 Make the measuring tool the featured entry point in the quote flow (#49)
    Per feedback that CamScan is the better capture experience (per-angle, set
    orientation, annotate, then it fills the form), restructure the quote section:
    - Featured 'Measure it in your browser first' block at the top of #quote — primary
    button + the 3-step guide — as the recommended entry point. Measured photos drop
    into the form's angle tiles below.
    - An 'or just upload photos' divider keeps the low-friction direct-upload path
    clearly available (so quick submissions still convert).
    - Fold in and remove the standalone #measure section (measureBtn/measureNote moved
    into the quote flow; still exactly one of e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
2026-07-28 Carry CamScan's reloadable job bundle through the quote to your email (#50)
    Site half of CamScan's round-trip (its side is on the auto-trace-smoothing branch):
    the embedded handoff now includes a reloadable bundle (raw image + calibration +
    editable trace per view). The page captures {brief, views} from the postMessage and
    forwards it as a 'camscan_job' JSON blob with the quote; /api/quote attaches it to
    the Resend email as job.camscan.json (<=15 MB) and archives it to R2 when bound, and
    notes it in the KV record. Opaque pass-through — the site never parses 'restore'; the
    schema is owned by CamScan. Download the file -> CamScan 'Load job' -> reopen the
    shop's measured trace with scale inta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
2026-07-28 Idempotent ingest: UNIQUE(probe_id, epoch) index + INSERT OR IGNORE
    Extracted hub-side from the freezer-wifi-flapping branch (firmware v2.8.0
    work left behind for separate flash-testing).
    A re-sent reading can no longer create a duplicate row. A UNIQUE index now
    backs the readings table and both write paths use INSERT OR IGNORE, so a
    dropped ACK on a bulk /ingest_csv flush (which re-POSTs a ~100-row chunk) or
    a replayed single POST is dropped instead of inflating COUNT/AVG/min-max and
    exports. A pre-existing DB with exact duplicates is de-duplicated in place
    when the unique index is built (keeps the earliest row).
    - core/db.py: DROP old non-unique idx_readings_probe_epoch, build
    UNIQUE i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
2026-07-28 Damp offline/back-online flapping for weak-Wi-Fi probes
    Extracted hub-side from the freezer-wifi-flapping branch (feature and
    firmware work on that branch left out).
    A probe on a spotty link (e.g. freezer Wi-Fi through a metal door) that
    drops, lands one reading, then drops again fired an offline + back-online
    notification pair every cycle — the churn the Recent-events feed already
    coalesced into "flapping (Nx)", but which the notifications did not.
    Connectivity now gets the flap damping the temperature path always had:
    evaluate_offline reports the drop once but holds the back-online alert until
    the probe has reported steadily for a confirmation window, so a brief blip no
    longer clears t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
2026-07-28 Fix ?to= date filter dropping the final second's sub-second rows
    _parse_date_epoch(end_of_day=True) resolves a bare `to=YYYY-MM-DD` to the
    fractional end-of-day epoch (…23:59:59.999999) precisely so `epoch <= bound`
    keeps millisecond rows in the closing second. But both DB query builders then
    did `int(end_epoch)`, truncating the bound back to …59 and re-dropping
    23:59:59.001–.999 — defeating the fix end-to-end for every probe that logs
    sub-second timestamps.
    This hit the JSON read API (fetch_readings) and every export path (CSV, xlsx
    and count share _export_where). Switch the four absolute-bound sites from
    int() to float() so the fractional bound survives to the query; float() keeps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
2026-07-28 Align pyproject version with core.version (2.4.0 -> 2.6.2)
    core/version.py is the declared single source of truth (2.6.2) and the README
    badge and CHANGELOG agree, but the packaging metadata in pyproject.toml still
    read 2.4.0 — two releases stale — so a built wheel/sdist would be mislabeled.
    Claude-Session: https://claude.ai/code/session_01WJr8fX1aDhqnaZXEmiiRWe
2026-07-29 Codebase review: fix six latent correctness bugs
    A review pass surfaced six defects not caught by the suite; each is fixed
    with a regression test that fails on the old code. All 334 tests pass.
    - core/db.py — idempotency migration no longer deletes real data. The
    in-place dedup that runs when the UNIQUE(probe_id, epoch) index is built
    kept only MIN(id) per (probe_id, epoch), so two DISTINCT readings sharing a
    whole-second epoch (old whole-second stamping of a sub-1 s cadence) were
    silently dropped on upgrade. It now collapses only byte-identical rows and
    falls back to a non-unique index when genuinely-distinct rows still collide,
    so history is never lost.
    - core/alerts.py —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
2026-07-29 Review sweep 2: fix stale docs and config-example gaps
    Doc/config accuracy issues surfaced by the review sweep (no behavior change):
    - config.example.json — add the recognised-but-undocumented keys rate_alert_c,
    rate_window_min and notifications.daily_summary so the template matches
    config_schema.py and the Settings panel (normalizes with zero warnings).
    - START_HERE.md — Start.sh serves the dashboard on :8088, not :8080.
    - docker-compose.yml — the persisted store is temperature_log.db (SQLite), not
    a CSV.
    - help_modal.py + README.md — the settings card is "Data & storage", not the
    stale "Data Management" (diagnostics_view already used the right label).
    - diagnostics_view.py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
2026-07-29 Review sweep 3: fix startup data-wipe on bad clock, webhook secret leak, config perms
    Deep audit of the previously-unreviewed internals (alert engine, notifications,
    audit chain, DB retention, config). Verifiers refuted four candidates as
    intentional/non-manifesting; these three are real and are fixed with tests. All
    341 pass.
    - core/db.py (HIGH) — delete_future_readings() runs at every startup and deleted
    rows with epoch > now+tolerance. On hub hardware without a battery-backed RTC
    (e.g. a Raspberry Pi) that boots to 1970/a stale date before NTP syncs, the
    low clock made the ENTIRE real history look "future" and wiped it irreversibly.
    It now skips the purge when the wall clock is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
2026-07-29 docs: add Setpoint community-post drafts (homelab / self-hosted / HA)
    GO_TO_MARKET.md names community seeding as the PRIMARY channel but no actual
    Setpoint post copy existed — COMMUNITY_POSTS.md only covers the replacement-parts
    business. This fills that gap now that there is working hardware on the bench,
    which is the strongest build-in-public moment.
    Contents: a reply template for "what temp sensor should I use?" threads (the
    highest-converting, lowest-risk motion), a build-in-public post for
    r/homelab + r/selfhosted, an MQTT-discovery-led variant for r/homeassistant, a
    technical project post for the HA/ESPHome forums, a ranked where-to-post table,
    and a repo-prep checklist (topics, Abo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
2026-07-30 Firmware v2.8.1 + long-sleep robustness on both ends
    Brings the held firmware v2.8.0 work onto main (bulk backlog drain, cold-boot
    rejoin) and fixes what degrades as the reporting interval grows. 345 tests pass.
    IMPORTANT: only the FIRMWARE was taken from the 2.8.0 branch. That branch also
    carried an older copy of the hub's idempotent-ingest work whose migration dedup
    deletes genuinely-distinct same-epoch readings; main's fixed version is kept.
    Verified core/db.py and core/storage.py are unchanged from main.
    Settings now reach a deep-sleeping probe (the reported bug):
    - Config was push-only (hub -> probe POST /provision), but a sleeping probe
    serves HTTP ~3 s every 6th wake: at a 5-min i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
    [esp32_temp_probe.ino, factory_flash.py, protocol.h]
2026-07-30 Fix firmware<->hub seam defects: backlog data loss, clock trust, token SSRF
    A wide review of the firmware/hub integration seams (7 parallel finders, each
    tracing one seam end-to-end, then adversarial verification) produced 62
    candidates; 8 were verified with reproductions. These are the hub-side fixes.
    351 tests pass, pyflakes clean. No firmware/flash files touched, so the 2.8.1
    image currently published by the flasher is unchanged.
    DATA LOSS (the important one). A probe whose clock ran ahead during the outage
    that filled its buffer replays future-stamped rows. normalize_payload clamped
    each row to its own "now", so a 100-row chunk collapsed onto one millisecond and
    UNIQUE(probe_id, epoch)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
2026-07-30 Seam review tier 2: bulk telemetry loss, pruner disagreement, id sanitization
    Continues triage of the firmware<->hub seam review (54 candidates below the
    verification cap). Verified each before acting; two were refuted on inspection
    and left alone. Hub-only — no firmware/flash files touched, so the published
    2.8.1 image is unchanged. 354 tests pass, pyflakes clean.
    - core/db.py + api/routes.py: the bulk drain dropped humidity/VPD/battery. The
    live path extracts them and PROTOCOL documents them, but /api/ingest_csv only
    ever passed (ts, t_c, t_f, pid) — so a grow probe reconnecting after an outage
    came back temperature-only. bulk_insert now accepts the richer tuple; the
    4-tuple f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
2026-07-30 Firmware v2.8.2: buffer readings even when the probe has no clock
    The single biggest data-loss path found in the seam review, and it undercuts the
    product's core claim.
    nowIso() returns "" until NTP has synced, and bufferAppend() early-returned on an
    empty stamp. So on a LAN with no internet access — the local-first, no-cloud
    deployment Setpoint is explicitly sold for, and the one docs/COMPLIANCE.md
    markets to air-gapped buyers — the probe's clock never becomes valid, the offline
    buffer never engages, and every reading taken while the hub is unreachable is
    discarded rather than stored.
    Clockless readings are now buffered with an empty timestamp field. The hub
    already receipt-stamps suc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
2026-07-30 Fix DST epoch collision, truncated-line corruption, and unalerted outage breaches
    Items 1-3 of the remaining seam-review triage. Hub-only — no firmware/flash
    files touched, so the published 2.8.2 flasher image is unchanged. 358 tests
    pass, pyflakes clean.
    1. DST fall-back (core/storage.py, core/db.py, api/routes.py). Readings are
    stored as local-naive strings and the epoch was re-derived from that string.
    During the repeated hour two UTC instants an hour apart share one wall time,
    so they collided on UNIQUE(probe_id, epoch) — one silently discarded — and
    everything ordering by epoch interleaved the whole hour. The firmware stamps
    in UTC (nowIso emits a trailing Z), so t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
2026-07-30 site: wire the capability-demo section to the carabiner build
    The replacement-parts page ships a "Capability demo" section that has been
    hidden since launch because it had only empty photo placeholders. The carabiner
    build supplies exactly the three steps it was designed around, so the section is
    now wired to real <img> tags, with copy and alt text written for it:
    1. Measured - the part measured from ordinary photographs against a
    calibration target
    2. Modelled - rebuilt in CAD to those dimensions
    3. Printed - finished part beside the original
    Reframed from "Broken part in, printed part out" to "Measured from photos.
    Modelled. Printed." — the carabiner is not a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
2026-07-30 site: publish the carabiner capability demo
    Un-hides the capability-demo section on the replacement-parts page now
    that the three build photos are in site/parts/.
    - Optimise the photos for a page built for mobile data: 1570 KB -> 474 KB
    total (scan 1038->115 KB, CAD 99->31 KB, comparison resized to 1074x1400
    and 432->328 KB). Correct the width/height attributes, which all claimed
    1200x900 and matched none of the three.
    - Frame a photo tile solid rather than dashed once it holds an image; the
    dashed border was meant to read as "empty slot".
    - Add .shot.whole for photos whose edges carry information. object-fit:cover
    centre-crops to 4:3, which was eating the top row of dimension cal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
2026-07-30 docs: note the rev-1 FCC gap in COMPLIANCE and LAUNCH
    STARTUP_CHECKLIST, PCB_REV2_MODULE, ACTION_PLAN, PRODUCT_ROADMAP and
    REV2_BUILD_GUIDE all state it plainly: the rev-1 SuperMini is a bare
    ESP32-C3FH4 with a trace antenna and no modular grant, so an assembled
    rev-1 unit owes ~$5-15k of intentional-radiator testing rather than the
    $300-1,500 Part 15B SDoC.
    COMPLIANCE.md and LAUNCH.md were the two that didn't say so. Both opened
    their FCC section with "the pre-certified module saves the big cost" and
    then quoted the SDoC budget, which reads as though the cheap path were
    already available on the hardware in hand. Anyone budgeting from either
    doc alone would under-plan the gate by an order o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
2026-07-30 site: drop the unsupported FCC claim, retarget copy to searched terms
    Two unrelated fixes to the homepage, both in the same file.
    The FCC claim was not true of the product on sale. Three places said
    "FCC-certified radio module" -- the hero trust badge, the spec table, and
    the footer fineprint. The badge sits directly above a "Get the DIY kit --
    $39" button linking to Tindie, and that kit is the rev-1 ESP32-C3 SuperMini:
    a bare ESP32-C3FH4 with a trace antenna and no modular grant, per
    STARTUP_CHECKLIST.md, PCB_REV2_MODULE.md and ACTION_PLAN.md. The fineprint's
    "specifications describe rev-2 prototype hardware" hedge did not reach the
    badge or the spec row, so a buyer read a certification cl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
2026-07-30 site: stop advertising humidity, qualify the accuracy figure
    Two more claims the hardware does not support, found while sweeping the
    rest of the site after the FCC fix.
    Humidity. The spec table listed "Humidity (optional) -- 0-100 %RH, +/-1.8%",
    the how-it-works step offered "add a humidity sensor on the expansion header",
    and the fineprint called Setpoint a "temperature and humidity sensor". There
    is no humidity support: grepping the shipping firmware for SHT4x or humidity
    returns zero hits, and BOM.md says the SHT4x is a documented future variant,
    "not implemented in v2.8.2 and not populated on shipping units". "(optional)"
    reads as an option a buyer can choose, not as unavailable. All th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
2026-07-30 site: add a freezer/refrigerator landing page
    Google Trends work found refrigerator/freezer to be by far the strongest
    application language -- "refrigerator thermometer" and "freezer alarm" well
    above the "WiFi temperature sensor" anchor -- and the site had no page for
    it. This adds one, scoped narrower than the raw keyword data implies.
    Scoped to the qualified slice, not the head term. Setpoint needs an
    always-on PC or NAS and the kit needs soldering, so head-term traffic
    ("refrigerator thermometer") is mostly consumers wanting a cheap app-based
    device who would bounce at the hub requirement -- and a bounce teaches the
    search engine the page is a poor result. The page therefore targets the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
2026-07-30 docs: correct a security control the firmware never implemented
    PROTOCOL.md opens by saying that where it and the code disagree, that is a
    bug to fix rather than silently tolerate. This is one of those.
    PROTOCOL.md described X-Provision-Secret as a required header that a probe
    "MUST reject /provision without" (401), defined it in the terminology table
    as guarding that endpoint, and -- worst of the four -- listed it in the
    threat table as the active mitigation for "unauthorized probe
    reconfiguration". handleProvision() in the shipping firmware parses the body
    and writes NVS without reading any header at all. There is no storage for
    such a secret and no code path that checks one, in any revis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
2026-07-30 docs: stop the user manual describing hardware that does not exist
    Three things in the customer-facing manual that a buyer would act on and
    then find missing.
    Section 1 told the owner the label carries a "setup secret" they would need
    during setup. There is no such secret anywhere: LABEL_TEMPLATE.md says in
    as many words that "there is nothing secret to print", factory_flash.py
    emits ap_pass=none on the [label] line, and the firmware has no
    provision-secret code path at all -- the same phantom control just corrected
    in PROTOCOL.md and SECURITY.md, which had propagated into the one document
    an actual customer reads. Section 4 then contradicted section 1 by saying
    the setup network is open wi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
2026-07-30 devices: say when a settings change will reach the probe
    Config reaches a probe by the probe PULLING it off an /api/ingest reply, so
    on a long deep-sleep interval it lands on the next check-in rather than on
    Save. devices_panel already knew this -- it logs "the change will be applied
    on its next check-in" -- but only to the log. The operator saw the modal
    close and nothing else, with no way to distinguish a slow delivery from a
    broken one. The hub cannot resolve that for them either: it has no way to
    query a sleeping probe, and the ingest POST carries only timestamp,
    temperature and probe_id, so the probe never reports what it is actually
    running.
    Saving now reports the probe's interval and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
2026-07-31 db: stop a forward clock jump deleting the whole history
    purge_older_than deletes on `epoch < now - days`, trusting the wall clock
    with an irreversible DELETE. delete_future_readings, four lines below it,
    already guards the mirror case and explains exactly why: hub hardware
    without a battery-backed RTC can boot to a wrong time, and "trusting that
    clock here would ... delete it irreversibly". The same reasoning applies on
    this side and the guard was simply absent.
    The asymmetry is what makes it easy to miss. A clock reading far in the PAST
    is harmless here -- the cutoff goes negative and matches no rows. A clock
    reading far in the FUTURE is not: the cutoff lands beyond every stored
    reading,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
2026-07-31 mqtt: bound the Home Assistant discovery announce set
    MqttPublisher._announced grew without limit, one entry per (probe, metric)
    pair ever seen. probe_discovery already bounds exactly this exposure with
    _MAX_PROBES, and its comment names the source precisely: "a flood of distinct
    ids (spoofed X-Probe-ID headers on the open-by-default ingest API, or a
    churning fleet)". A probe id is whatever arrives in that header, sanitized to
    32 chars of [A-Za-z0-9_-], so its cardinality is effectively unbounded. This
    module had no equivalent bound.
    The consequence is worse here than a memory leak. Discovery entities publish
    with retain=True, so the broker keeps them: a retained message outlives the
    hub pr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
2026-07-31 alerts: count notifications that never reached anyone
    Alerting is what this product promises, so a notification that fails to
    arrive is its worst failure -- and the worst version of that is a silent
    one. Both loss paths were silent. The dashboard still showed the breach and
    the event log still recorded it, so an undelivered alert was
    indistinguishable from a delivered one; the only trace was a log line nobody
    reads until after the freezer has thawed.
    The channel path is the easy one to miss. Notifier.dispatch reports a dead
    channel by RETURNING ok=False, not by raising -- send_email and send_webhook
    each catch their own exceptions and report through the result tuple -- so the
    existing try/e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
2026-07-31 config: coerce the per-probe scalar maps, not just alert_thresholds
    _DICTS checked only that probe_intervals, probe_resolutions and
    calibration_offsets were objects; their inner values were never coerced.
    alert_thresholds is the exception, and its comment gives the reason: an
    uncoerced string bound "would otherwise raise TypeError in the alert loop's
    comparisons and silently kill ALL alerting".
    These three have the opposite failure and it is the worse one. Every consumer
    already defends itself -- desired_probe_config catches TypeError, ValueError
    and OverflowError and falls back, _calibration_offset returns 0.0 -- with
    comments explaining that an exception on the live ingest path would "500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
2026-07-31 fix: /metrics probe count, and 500s on non-ASCII credentials
    Two defects, both surfaced by a subagent review of app.py and both
    independently reproduced here before changing anything.
    1. setpoint_probes_total never counted mDNS-discovered probes.
    The comment above the code states the intent plainly -- "union of
    mDNS-discovered and database-reporting ids" -- and the code does not do it:
    else getattr(p, "probe_id", None)
    ProbeDiscovery stores ProbeInfo dataclasses, whose fields are name, host, ip,
    port, properties, last_seen. There is no probe_id; the id lives in
    properties["id"]. A ProbeInfo is not a dict, so the ternary always took the
    getattr branch and always yielded None, discard(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
2026-07-31 fix: four defects from the remaining-surface review
    A six-area subagent sweep with an adversarial verifier per area returned five
    confirmed findings from eleven raised; three were refuted and the firmware
    control-flow area returned none. Each confirmed one was reproduced here before
    anything was changed. Four are fixed below; the fifth (in-app help describing
    a Wi-Fi recovery gesture the firmware does not implement) is left for a
    separate commit since it is a doc change against firmware behaviour.
    1. The chart range selector could silence a live alert. (dashboard_view.py)
    The alert banner and the worst-breach gauge share one latest-per-probe scan,
    and it was scoped to the SELECTED CHART RA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
2026-07-31 help: correct the wrong-Wi-Fi recovery instruction
    The in-app Troubleshooting entry told the owner that unplugging the probe for
    10 seconds brings the Setpoint-XXXXXX setup network back within ~30 seconds.
    The shipping firmware does not behave that way, and in the specific case the
    bullet names -- "joined the wrong Wi-Fi" -- it never will.
    On a cold boot with saved credentials the firmware takes the
    wm.getWiFiIsSaved() branch, retries the saved network for
    WIFI_COLD_RECONNECT_MS (60 s), and on success calls saveColdFail(0). The
    portal opens only after COLD_FAIL_PORTAL_AFTER (3) CONSECUTIVE FAILED cold
    boots. So while the wrong network is still in range the probe simply rejoins
    it and clears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
2026-08-03 docs: rev 2 is real hardware — record what that does and doesn't unlock
    Rev 2 is built and bench-verified on the shipping firmware, so the docs can
    stop describing it as a future respin. What it changes is narrow and worth
    stating precisely, because the tempting reading is that a working board means
    a sellable board.
    BOM.md led with rev 1 as "the unit" and mentioned no other board. It now opens
    with both, and with the one column that matters: rev 1 may ship as a kit but
    never assembled (bare ESP32-C3FH4, no modular grant, ~$5-15k of full
    intentional-radiator testing), while rev 2 carries FCC ID 2AC7Z-ESPC3MINI1 and
    may ship assembled AFTER a ~$300-1,500 Part 15B SDoC. Both run the same
    fi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
2026-08-03 site: add the pilot offer, and stop asking chefs to solder
    The walk-in-cooler page targets restaurant owners. Its hero CTA was "Get the
    DIY kit -- $39" and its closing CTA was the same, with copy explaining that you
    solder it and flash it yourself. That is the wrong offer for that reader by some
    distance, and it was my error when I built the page.
    Worse, the highest-value offer the business can legally make today appeared
    nowhere on the site. Assembled units cannot be sold until the Part 15B SDoC is
    done, but a free 30-day LOANER pilot is FCC-clean -- the unit is evaluation
    equipment that never changes hands -- and it carries paid install labour, a
    certified mini-PC at margin, and a refunda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
2026-08-03 site: remove two false claims and a promise the product cannot keep
    From a four-persona funnel audit. Several of these are mine, from pages I wrote
    this week.
    A promise of SMS alerts that does not exist. /pilot said "Alerts by email or
    text" and "texts and emails pause". There is no SMS channel: README.md lists
    Twilio only as something a customer could wire up downstream of a webhook,
    i.e. the cloud account every other page promises they will never need. Every
    other page correctly says "email or webhook". This was a written promise to the
    buyer least able to verify it, in a scenario where the loss is $2,000-$10,000.
    Now states email, with webhook named for Slack/Teams.
    /pilot gave away the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
2026-08-03 docs: catch the docs up to rev 2 being real and the pilot page existing
    Three things this week's work left stale.
    PILOT_OFFER.md still gave away the revenue. I corrected site/pilot.html in the
    previous commit but not the document it was written from, so the leave-behind a
    customer is handed still said "What we'll install (at no cost to you)" and
    promised the trial with no mention of the paid install or the supplied mini-PC
    -- the only things that may lawfully be charged for before the SDoC lands.
    Fixing one and not the other is worse than fixing neither, because the two are
    now handed to the same person.
    Now says: 30 days of MONITORING free; probes are loaner equipment on
    evaluation that r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
2026-08-03 warranty: make it fill-in-and-ship, and fix what it got wrong
    WARRANTY.md ships with every kit and every pilot, and it was not in a state to
    ship. Three problems beyond the placeholders.
    It warranted hardware that does not exist. "This limited warranty covers the
    physical Setpoint hub and Setpoint sensor hardware" -- there is no Setpoint hub
    device. The hub is free software the customer runs on a machine they already
    own, which is the central architectural claim of the whole product. Warranting
    a nonexistent product is the kind of thing that reads as boilerplate nobody
    checked, on the one document a buyer reads when something has already gone
    wrong. Now states plainly that the hub is softwa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
2026-08-03 site: show the hardware, and fix the social card's aspect ratio
    A site selling a physical product had a photograph of it on zero pages. Nine of
    the ten rendered no images at all; only replacement-parts.html had any, and
    that is the page pulling nearly as much traffic as the homepage.
    The photograph existed the whole time. og-image.jpg is a real shot of a built
    kit -- carrier board with the ESP32-C3 and TP4056, the stainless probe on its
    lead, an 18650 in its holder -- and it was wired up only as a social card, so it
    appeared everywhere except the site.
    Now on the DIY-kit tier, which is the one place it is exactly accurate: it shows
    the parts a kit buyer receives, unenclosed, which is what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
2026-08-03 docs: the company is real now, so say who it is
    Datum Laboratories LLC was filed in Georgia on 2026-08-03. Six documents ship
    with every kit and every pilot, and until now not one of them said who the
    seller was -- WARRANTY carried three bracketed tokens, and RETURNS, PRIVACY,
    SUPPORT, SECURITY and the EULA all pointed at example.com/support. A warranty
    that names no entity is a warranty nobody can enforce, which is worse than
    having none, because it reads as though someone checked.
    All six now carry the same three facts: Datum Laboratories LLC, 1304 Cottonwood
    Court Northwest, Kennesaw, GA 30152, and support@datumlaboratories.com. The
    address is spelled exactly as filed with the state rath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
2026-08-03 docs: paste-ready Tindie copy, with the accuracy claim corrected
    The live listing states "Accuracy: ±0.5 °C typical, uncalibrated" twice, with no
    band -- on a page whose first sentence sells "rack, fridge, or freezer." Every
    other surface was corrected weeks ago to ±0.5 °C from −10 to +85 °C and ±2 °C
    below that, and a −18 °C freezer sits squarely in the ±2 band. So the one page
    that takes money quotes four times better accuracy than the hardware delivers,
    to exactly the buyer most likely to care, under a heading that says "Honest
    specs." That heading makes it worse, not better.
    Corrected in both places it appears, in the same words as the warranty and the
    site, and with the re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
2026-08-03 docs: make the sell-facing docs match the product that actually exists
    A review of all 49 docs against two questions -- can I sell the DIY kit from
    these, and can I sell the assembled unit from these -- found seven real defects.
    THE ASSEMBLED PRODUCT COULD NOT HAVE BEEN LABELLED.
    docs/LABEL_TEMPLATE.md is the artifact you hand a label printer, and it had no
    FCC content whatsoever. Twelve other documents specify the requirement, and
    ACTION_PLAN.md line 146 literally reads "Label every unit ... update
    docs/LABEL_TEMPLATE.md" -- an instruction to update the very file that still
    lacked it. A unit shipped from that template could not lawfully be sold.
    It now carries the three mandatory parts v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
2026-08-03 docs: the support alias goes in Zoho, not Cloudflare — my instruction was wrong
    site/README.md already said it plainly: the contact address is a Zoho Mail
    mailbox, and "Cloudflare Email Routing is retired now that the domain's MX
    points at Zoho — the two can't both own MX." I read the stale TODO comment in
    web/index.html instead, which predates the Zoho migration, and propagated
    "stand up Cloudflare Email Routing" into four more places including do-next #1.
    Following that would have taken the domain's MX away from Zoho and killed
    thomas.allen@datumlaboratories.com — the address on thirteen places on the live
    site, on every pilot booking link, and the one filed with the Georgia Secreta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
2026-08-03 docs: support@ resolves — clear the shipping blocker
    support@datumlaboratories.com is now an alias on the Zoho mailbox, so the six
    shipped legal documents, the product label spec and the root LICENSE all point
    at an address that delivers. Five files carried a BLOCKING / "currently bounces"
    flag; all cleared, and each keeps one line saying to leave it a Zoho alias and
    never enable Cloudflare Email Routing, because that failure mode is silent and
    would take thomas.allen@ down with it.
    START_HERE also had two items still open that are finished: the domain/alias
    step, and "edit WARRANTY.md + RETURNS.md with the LLC name" — both now name
    Datum Laboratories LLC and the Kennesaw address. Kept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
2026-08-03 dashboard: stop the history chart sliding around while you zoom
    Zooming the Temperature History graph moved the plot rectangle under the
    cursor. Cause is Plotly's margin.autoexpand: it re-measures the plot area
    whenever a tick label changes width, and zooming changes both axes' labels.
    The y labels gain decimals (-18 -> -18.38 -> -18.395) and the last x label
    lengthens (12:50 -> 12:05:00), so with the old margins of l=0, r=10 there was
    no slack to absorb either and the edges moved instead.
    Measured in Chromium at 900x360, sweeping y-zooms down to 0.008 units and
    x-zooms from 26 h to 60 s, across C/F and room/freezer/deep-freezer data:
    left edge right edge
    before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
2026-08-04 dashboard: make the gauge number agree with every other reading on the page
    Plotly's Indicator picks ~3 significant digits from the value's magnitude when
    valueformat is unset. In C and F that happens to land on one decimal, so the
    inconsistency stayed hidden; in Kelvin it does not. The same reading rendered
    "19.8 °C" and "67.7 °F" but "293 K", while the Min/Max/Avg cards and probe
    cards a few inches away — all of which go through _fmt() — said "293.0 K".
    The gauge is the largest number on the dashboard and was the only one silently
    dropping precision. Pinned valueformat to ".1f" to match _fmt().
    Found while driving the UI rather than reading it: switching the unit picker
    through C/F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
2026-08-04 docs: the manual tells customers to read a battery figure no probe sends
    USER_MANUAL.md §9 described Batt NN% on the probe card, and the offline
    troubleshooting step said "check the battery level on its card and recharge if
    it's low." No shipping probe reports one.
    The hub side is complete and correct -- PROTOCOL.md §7 defines battery_pct and
    battery_v as optional, core/storage.py converts volts to a percentage, db.py has
    the column, the API exposes it, and both the dashboard and Devices render it
    with an amber state under 20%. The firmware simply never sends either field, and
    the rev-2 schematic has no circuit that could measure it: eight nets, none of
    them a VBAT divider to an ADC pin.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
2026-08-04 docs: rev-3 notes, and pull two invented readouts off the homepage
    REV3_NOTES.md collects what is worth changing before the SDoC is signed, because
    that is when it stops being free. SDoC has no permissive-change path -- that
    exists for certified equipment under 47 CFR 2.1043, not for self-declared
    conformity -- so after the report exists, any change is yours to defend as
    non-significant or re-test. The report does not exist yet, and the enclosure is
    not frozen, so the window is open right now.
    Charge-complete: the rev-2 schematic no-connects TP4056 pin 6 (STDBY). The chip
    is announcing "done" and nothing is listening, which is exactly why there is no
    finished-charging indication. Both statu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
2026-08-04 hardware: a home for the KiCad sources, and rules for what belongs in it
    The board about to be certified exists in exactly one place: a disk. The SDoC
    report will name a hardware revision and the FCC label names a responsible party
    for it, so "which files were the certified board" wants an answer with a commit
    hash rather than a filename ending in _final_v2.
    hardware/ with a folder per revision, plus a README covering the part that trips
    people up: KiCad needs no export step. The .kicad_sch and .kicad_pcb are
    plain-text S-expressions, so the design files already are the reviewable
    artefact — copy the project in and commit it.
    .gitignore now separates sources from noise: keep .kicad_pro/.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
2026-08-04 hardware: the board is a WROOM-02, not a MINI-1 — 46 places said otherwise
    Read the actual KiCad files. U1 is an ESP32-C3-WROOM-02. Every document, and
    three live site pages, asserted ESP32-C3-MINI-1 and its FCC ID
    2AC7Z-ESPC3MINI1 — 46 occurrences across 17 files, including LABEL_TEMPLATE.md,
    which is the file that becomes a physical label.
    Printing a module's FCC ID on a product that does not contain that module is a
    false statement of conformity. This was one label print away from being a real
    problem, and the strategy itself is fine: the WROOM-02 is equally pre-certified,
    so the cheap Part 15B SDoC path is intact. Only the identifier was wrong.
    PCB_REV2_MODULE.md specified the MINI-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
2026-08-04 discovery: stop zeroconf's cache race from spamming ERROR in customer logs
    A running hub logs this, repeatedly:
    ERROR:asyncio:Exception in callback AsyncEngine._async_cache_cleanup()
    ...
    File "src/zeroconf/_cache.py", line 58, in zeroconf._cache._remove_key
    KeyError: '6c999dba4d16.local.'
    It is entirely inside python-zeroconf: DNSCache.async_expire() walks the cache
    while another path removes a record, and the second delete raises. It is a stale
    cache entry, not data loss, and nothing in Setpoint can prevent it. The hostname
    in the message is usually some unrelated device on the LAN, which makes it read
    even more like a Setpoint fault than it is.
    What makes it worth fixing is who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
2026-08-04 multi-site: forward a store hub's readings to an aggregating HQ hub
    A chain with six stores needs head office to see all six, and the obvious answer
    — build a cloud — is the wrong one. "It can't be shut down" and "your data stays
    on-prem" are why a buyer picks this over SensorPush. So: each store keeps its own
    hub and its own database, and may additionally push a COPY upstream. Nothing is
    taken away, something is added, and the promise becomes "no *mandatory* cloud",
    which is honest and still true if the customer stops paying tomorrow.
    The shape was already in the architecture. A store hub forwarding to an HQ hub is
    the same relationship a probe already has with a hub: same /api/ingest_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
2026-08-04 multi-site: an HQ store picker that scopes the whole dashboard, not half of it
    Forwarding already landed; head office could receive six stores' readings but
    saw them mixed into one dashboard, where "Walk-in" appears six times and a 23 °C
    Max is just whichever store has an office thermostat.
    Adds a Site control beside "Viewing", populated from Database.sites() — so it
    stays invisible on a hub nobody forwards to, which is every hub until a chain
    runs one. Single-site users never learn it exists.
    The interesting part was making it scope EVERYTHING. A page where the chart
    filters and the card grid doesn't is worse than no filter at all: the two halves
    disagree and neither is trustworthy. So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
2026-08-04 docs: a three-hub local test recipe, and fix the env var that would have broken it
    The two-hub recipe named SETPOINT_DATA_DIR. app.py reads DATA_DIR. Following the
    doc, every hub would have silently shared one data directory — one database, one
    config — and the test would have proved nothing while looking like it worked.
    Replaces it with head office plus two stores, which is the shape the feature is
    actually for; two hubs cannot show a picker switching between stores. Each step
    is a real run, not a plausible one:
    * The forwarder starts itself from config at boot — no manual run_once() —
    so the recipe is now three ordinary `python app.py` invocations.
    * scripts/simulate_prob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
2026-08-04 ingest: stop /ingest_csv double-logging a breach the alert engine already sees
    /ingest_csv records the worst threshold excursion in a batch, because the alert
    engine only ever evaluates a probe's LATEST reading — a freezer that thawed
    entirely during an outage would otherwise be stored and never logged. That is
    the single most important thing not to miss, and the backfill is right.
    It was also unconditional. While /ingest_csv only served probes draining a
    buffer that was nearly always correct, since a drained backlog's newest row is
    old news too. Forwarding changed the traffic: a store hub sends EVERY batch
    through this endpoint, live, seconds old. So on an HQ hub the backfill fired for
    r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
2026-08-04 db: the site picker was full-scanning the readings table every 5 seconds
    Two defects found reviewing the multi-site work before hardware testing.
    1. sites() was SELECT DISTINCT over a low-cardinality column, which SQLite can
    only answer with a full table scan plus a temp b-tree. The dashboard's picker
    re-reads it on every 5 s refresh tick, on the callback thread. Measured on a
    six-store HQ with 1.5M rows: 883 ms, every tick, growing linearly with
    history. A chain running for a couple of years would stall the dashboard.
    Fixed with a PARTIAL index and a loose index scan. The partial predicate
    `WHERE site != ''` is doing two jobs: it makes the index EMPTY on a hub nobody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
2026-08-04 settings: configure multi-site from the UI, and make "Save" tell the truth
    Forwarding worked but could only be reached by hand-editing config.json, and the
    pump thread was only started at boot — so enabling it meant editing a file AND
    restarting. That is not a feature a customer can use; it is a feature you have to
    be talked through on the phone.
    Adds a Multi-site card to Settings, built to the same shape as the MQTT one so a
    single-site customer — nearly everyone — sees exactly one line they can ignore.
    Off by default, every field behind the switch.
    The pump now runs unconditionally and no-ops while disabled (one dict lookup per
    30 s), so switching it on in Settings works immediatel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
2026-08-04 docs: warn that two hubs on one LAN steal each other's probes
    Hit this immediately in a real two-machine test. Every hub runs an
    auto-provisioner (on by default) that discovers probes over mDNS every 10 s
    and, seeing one pointed at a different server_url, re-points it at itself. Put
    a head-office hub and a store hub on the same network and they take turns
    claiming the same probes; readings land in whichever provisioned them last, and
    it presents as "forwarding is broken".
    It never happens in a real deployment — stores sit on their own networks, and
    mDNS is link-local — but it happens every time someone tests across two
    machines at home, which is the normal way to try this feature out.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
2026-08-04 scripts: a read-only per-site report, replacing a one-liner that made junk files
    The command in the docs for "is head office receiving my store's readings?" was
    sqlite3.connect('temperature_log.db') in a python -c. Run it from the wrong
    directory — which is the normal outcome, since the path is relative and the DB
    lives beside app.py — and sqlite3 CREATES an empty database, so the answer comes
    back "no such table: readings" and a junk file is left in the user's home
    directory. The diagnostic tool was itself a small footgun.
    scripts/site_report.py opens the store with mode=ro so it cannot create or
    change anything, finds the database the same way the rest of the tooling does
    (DATA_DIR, D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
2026-08-04 settings: a switch for automatic probe configuration, which had none
    devices_panel.py already told users "Automatic provisioning is switched off ...
    Turn it on in Settings" when a probe save could not be delivered. There was no
    such control in Settings, or anywhere else in the UI — auto_provision was
    config-file-only, so the guidance pointed at nothing.
    Found it while diagnosing a real two-machine test where a head-office hub and a
    store hub on the same network took turns claiming the same probes. That is the
    setting you need to reach, and reaching it meant hand-editing JSON.
    Adds one switch to Settings (on by default, matching current behaviour) with the
    note explaining when to turn it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
2026-08-04 scripts: name the likely cause when site_report finds no database
    "Could not find temperature_log.db" plus a list of paths is accurate and
    unhelpful — it reads as a broken path when the real answer is almost always
    that the hub has not been started since the file was created or deleted, which
    is exactly the state you are in right after clearing a hub to start a clean
    test. Say that first, keep the path list as the fallback.
    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
2026-08-04 settings: say that the auto-detected head-office address may be the wrong one
    The "what my sites need" helper prints an address derived from the default
    route. On a hub reached over a VPN — which is the correct topology for stores on
    their own networks, and the one this feature is for — that is the physical NIC's
    private address: right for the same LAN, useless from another network, and wrong
    in a way that looks entirely right when you copy it into a store's settings.
    PUBLIC_BASE already overrides it and flows through to both /api/health and this
    helper. Nothing in the UI said so, and this table is precisely where someone
    copies the value from, so the note belongs here rather than only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
2026-08-04 db: put site in the dedup key — two stores could silently overwrite each other
    UNIQUE(probe_id, epoch) is what makes ingest idempotent, and it is the property
    the whole forwarding design leans on: a batch re-sent after a dropped response
    cannot duplicate rows, so the forwarder never has to solve exactly-once.
    It also had no notion of site. Probe ids are operator-visible strings, not only
    MAC-derived ones, so two managers both calling their cooler "walkin" is the
    expected case rather than a pathological one — and at head office the second
    store's reading hit INSERT OR IGNORE and was dropped. Silently, from both ends:
    the store shows it sent, HQ shows a plausible series, and the row is si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
2026-08-04 refactor: collapse the site-filter duplication the multi-site work spread around
    Adding a site filter to five database queries and six dashboard call sites left
    the same two incantations copy-pasted at each. Both had already gone wrong once:
    two of the five db methods used a truthiness test instead of `is not None`, so
    site='' meant "no filter" in some and "this hub's own probes" in others — the
    inconsistency that makes a chart show six stores while the cards beside it
    correctly show one.
    * core/db.py gains _reading_filters()/_where(). Five hand-rolled clause
    builders become two lines each, and the rule about '' lives in one docstring
    instead of one comment repeated three times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
2026-08-04 multi-site: forward the store's alert log, not just its readings
    Head office had the temperatures but not the verdicts. Its "Recent events" for a
    store was HQ's own alert engine re-evaluating forwarded readings against HQ's
    thresholds — a different answer from the one the store's staff actually acted on,
    and the store's is the one an auditor asks for. Two records, and only one of them
    travelled.
    Events now ride the same request as the readings: an optional `events` array on a
    JSON /api/ingest_csv body, with the same token and X-Site header. One round trip,
    two cursors, and either the batch lands or neither cursor moves. An events-only
    batch is normal and works — an offline event fires p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
2026-08-04 Dashboard & Settings: fold the complexity away, infer what can be inferred
    The Settings page was six always-open forms stacked vertically — around ninety
    controls visible at once — and the Dashboard put its gauge and chart below five
    stacked sections of numbers. Both are now progressive: the surface answers "what
    is this doing?" and the detail is one click away.
    Settings is a collapsed index. Each area is a card with a one-line description
    and a live badge saying what it is set to right now ("Off", "Email + Webhook",
    "Keep 90 days", "Sending as atlanta"). Badges reflect SAVED config and read
    "On · no channel" / "Email not finished" rather than green, so a half-configured
    section can ne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
2026-08-04 docs: reorder MULTI_SITE, and correct 11 comments the key change left stale
    The doc grew by accretion over the feature's life and ended up explaining what
    the HQ dashboard does AFTER telling you how to test it. Moved that section above
    the test recipe: what the feature is should precede how to exercise it.
    Widening the dedup key to (probe_id, epoch, site) left eleven comments across
    five files still describing the two-column version — including the one in
    /ingest_csv explaining why bulk rows are spread a millisecond apart, which is
    exactly the comment someone reads before touching that code. This codebase's
    comments are load-bearing, so a stale one is worse than none. Corrected the ones
    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
2026-08-04 Sweep: four runtime bugs, one migration cost, and five copies of one rule
    Four defects that only show on the SECOND cycle — the case a start-it-once test
    never reaches:
    SSIDWatcher could not be restarted. It re-used one Event that start() never
    cleared, so after a stop() every restart spawned a thread that saw the flag
    already set and exited before its first scan: a watcher that looked running and
    reported nothing, forever. Now each thread owns the event it closes over, so a
    retired thread cannot be revived by a later clear() and a new one cannot race a
    stale flag. stop() also interrupts the sleep instead of letting it run out —
    previously up to a full interval of further shelling out t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
2026-08-04 firmware 2.9.0: let the probe transmit when it crosses a limit, not when the clock says so
    A probe reporting every 15 minutes can sit on a thawing freezer for 15 minutes.
    The v2.5.0 disturbance burst does not cover it: that fires on a sudden CHANGE,
    a slow thaw has none, and above BURST_MAX_INTERVAL_MS bursting is off entirely
    — which is exactly the long interval where a silent excursion costs most.
    The asymmetry this exploits is the one that makes it affordable: reading the
    sensor is a conversion, associating and POSTing is seconds of radio. So decouple
    them. Given limits by the hub and a sample cadence shorter than its report
    interval, a deep-sleeping probe now wakes every cfg_sample_ms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
    [esp32_temp_probe.ino, watch_logic_test.cpp]
2026-08-04 forwarder: bound a batch by bytes, not just rows
    Takes the problem codex/update-upstreamforwarder-to-handle-batch-limits found,
    which is real and worse than it looks, without its implementation.
    /api/ingest_csv refuses a body over MAX_INGEST_BYTES (64 KB), and a row limit
    cannot honour a byte budget. Measured against the real payload shaper: a bare
    reading encodes to 122 bytes, so the shipped default of 500 rows is 62 KB of a
    63.5 KB budget — 2.4% of margin. Add humidity and battery, which the grow
    variant reports, and the same 500 rows are ~92 KB. So the DEFAULT already 413s
    forever for the probes that report most, and upstream.batch=1000 (allowed by the
    schema) is 124 KB and 413s for ev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
2026-08-04 assets: stop the vendored theme fetching a font from Google
    Bootstrap is vendored specifically so the hub renders with no internet — the
    comment in app.py says so, citing offline homelabs and air-gapped networks. The
    vendored file then opened with an @import for Google Fonts, so every page load
    reached out anyway. Caught by watching the browser's network log while checking
    the merge, not by anything in the suite.
    Three costs, none of them cosmetic. On an offline hub it is a render-blocking
    request that has to time out. On any hub it is a food-safety appliance
    announcing itself to a third party on every page view, from a product whose
    pitch is that none of it goes through anyone. And it is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
2026-08-04 Review sweep: a 110x dashboard query, unattributable exports, two duplications
    latest_per_probe was scanning the whole window on every dashboard tick. Its
    docstring claimed O(probes x log N) and the per-probe seeks delivered that, but
    the SELECT DISTINCT that fed them did not: deduplicating a low-cardinality
    column visits every row in the window. Measured on a 2M-row store, 8 probes,
    7-day window: 78 ms per call, 64 ms of it the DISTINCT. It runs from four
    dashboard callbacks and the alert monitor, every five seconds, and grows with
    history. Same fix as sites(): a loose index scan over probe_id, which
    idx_readings_probe_epoch_site_uniq leads with. 78 ms -> 0.7 ms.
    Dropping the window from t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
2026-08-04 Surface duplicate probe ids at HQ, drop a dead local
    The unique index carries the site, so two stores using the same probe id
    lose no rows on disk. Everything the hub keys by probe id alone still
    collapses them: thresholds, friendly names, calibration offsets, and
    latest_per_probe. The newest reading wins, so a walk-in at 30 C in one
    store sits invisible behind an in-range reading from another store's
    walk-in. The store's own hub still alerts on its own probes -- it is head
    office's second copy that goes quiet.
    Making every surface site-aware would mean re-keying the threshold,
    name and calibration config, plus the held-breach registry and the event
    log, to (site, probe_id). The config mode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
2026-08-04 Give temperature conversion and config subtrees one home each
    Two duplications that had grown past the point of being harmless.
    core/units.py: `(t_c * 9.0 / 5.0) + 32.0` was written out in seven modules
    -- live ingest, bulk ingest, storage, the CSV migration, alert formatting,
    the demo generator -- and `_unit_symbol` existed twice in two component
    files with two quote styles. None were wrong, which is the problem: seven
    correct copies are seven places to check when something about temperature
    changes. The module also pins the two distinctions callers rely on --
    absolute vs delta (a -0.5 C calibration offset is -0.9 F, not 31.1 F) and
    who rounds (form fields want 2 dp, the dashboard wants fu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
2026-08-04 Sync the flash manifest to FW_VERSION, and enforce it
    flash/manifest.json said 2.8.2 and flash/index.html advertised v2.8.2
    while the firmware is 2.9.0. ESP Web Tools compares manifest.json's
    version against what a probe reports, so a stale value tells someone
    running old firmware they are already current -- and the installer page
    advertised a version nobody ships.
    flash/README.md and flash/build_merged_bin.sh both already said "keep
    manifest.json's version in sync with FW_VERSION". Prose does not enforce
    anything: CHANGELOG records this same drift being fixed once before, and
    it drifted again. tests/test_version_sync.py now checks it, and both
    notes point at the test rather than asking to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
2026-08-04 Document three live endpoints the API reference had never listed
    /api/readings/latest, /api/readings and /api/diagnostics are implemented,
    unauthenticated and useful -- /api/diagnostics is the one support asks a
    customer to paste into an email -- but the REST reference in
    docs/DEVELOPING.md listed neither. /api/audit/verify was described in
    prose further up the file and missing from the table too.
    Also notes that the version in the /api/health sample response is
    illustrative rather than a pin, so it stops reading as a third place the
    release number has to be kept current.
    Claude-Session: https://claude.ai/code/session_01WJr8fX1aDhqnaZXE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
2026-08-04 Make CI catch what only manual runs were catching
    Three settings that looked applied and were not -- the same failure mode
    as the flash manifest and the file map earlier in this sweep.
    pytest was configured twice. pytest.ini takes precedence over
    pyproject.toml, so the [tool.pytest.ini_options] block was dead in full,
    including a filterwarnings = ["ignore::DeprecationWarning"] that had
    never once taken effect. Removed, with pytest.ini saying why so nobody
    adds it back there. Deliberately did NOT switch the filter on: the suite
    is clean without it, and silencing DeprecationWarnings would hide the
    pandas/dash upgrade signals most worth seeing. That is a decision to make
    on purpose, not to inh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
2026-08-05 site: stop offering to sell the loaner, and fix the ROI calculator
    Two defects on the two pages the navigation rebuild is about to send more
    traffic to.
    pilot.html step 04 read "If you want to keep it we quote a buy-once price
    for the probes" -- an offer to sell an assembled unit, twelve lines above
    its own fineprint saying pilot units are "supplied as loaner evaluation
    equipment... they are not sold". site/README.md rule 1 prohibits exactly
    this until the FCC Part 15B SDoC completes. docs/PILOT_OFFER.md carried
    the same offer, so rule 2 held (the two agreed with each other) while the
    policy broke. Both now say the probes come back and why, and describe
    buy-once as the model when units beco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
2026-08-05 site: one navigation for the product, and wire /pilot into it
    The site grew by accretion over eleven days -- index+services, then
    about, replacement-parts, freezer-alarm, walk-in-cooler+field-test+
    roi-calculator, then pilot -- and each new page copied whichever page was
    nearest. Four nav link-sets ended up in circulation, and /pilot, added
    last and described in site/README.md as "the highest-value offer
    available today", never got wired into any of them.
    Measured before: /pilot appeared in NO <nav> on any page, including its
    own, and was linked from two files. Seven of ten pages had no path to it
    at all, footer included -- while sitemap.xml gave it priority 1.0, tied
    with the homepage. It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
2026-08-05 site: WCAG AA contrast, keyboard access, and the outage story
    Accessibility pass over all ten pages, plus the product-versions doc.
    Contrast. Every foreground token now passes AA 4.5:1 against that page's
    own backgrounds in BOTH themes -- verified by recomputing all 54
    token/background pairs, zero failures remaining. Replacement values were
    solved in HLS so hue and saturation are preserved exactly and the design
    is unchanged; only lightness moved. The worst offenders were --faint at
    2.88:1 (below even the 3:1 large-text floor) and --signal at 3.32:1.
    Darkening --signal fixed a second defect for free: white button text on
    it was 3.59:1, and is now 4.88:1.
    Also fixed: skip links (no page had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
2026-08-05 site: fix the CTA contrast regression I shipped, and finish the job
    The adversarial audit of the previous commit returned pass=false on all
    five page groups. It was right, and the worst finding was mine.
    REGRESSION I CAUSED. I told the fixing agents "the --signal change also
    fixes white button text, 3.59:1 -> 4.88:1". On index/pilot/walk-in-cooler/
    freezer-alarm .btn.signal is NOT white text -- it is #04222A. I had
    computed the white case and asserted it as fact without checking those
    pages. Darkening --signal therefore took the primary CTA on four pages
    from 4.61:1 (passing) to 3.39:1 (failing), and I committed it. Even pure
    black cannot reach 4.5:1 on that fill, so the fix is the --on-sig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
2026-08-05 site: the USB tier is an assembled unit too, so say it is not for sale
    "Setpoint Battery" carried "not yet for sale" while "Setpoint USB" -- the
    same Rev 2 board, mains-powered -- sat next to it priced at $59 with a
    bare "Fixed" badge and a Reserve button. site/README.md rule 1 covers
    both: no assembled unit may be offered for sale until the FCC Part 15B
    SDoC is complete. A test now checks every priced tier, with the DIY kit
    deliberately excluded because it genuinely is for sale.
    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
2026-08-05 hub UI: fix an onboarding dead end, a status light wired to nothing, and a health flag that cried wolf
    Found by running the app and looking at it rather than reading it.
    SETUP. The one command the dashboard offers a brand-new user returned
    {"error":"unauthorized"}. It hard-coded http://localhost:8088 (wrong on
    any other port) and omitted the device token, which a default install
    ALWAYS generates. It now renders this hub's real address and the X-Token
    header, and points at Settings -> Probes -> "Show token" rather than
    printing the token: Settings deliberately keeps it behind a click, and
    the dashboard is the page people screenshot for support.
    HEALTH. "healthy" required a successful write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
2026-08-05 Devices: make the page an operator can actually run a site from
    It showed a name, an id, "via readings" and "Online". Not the reading,
    not the range the probe is held to, not how often it reports. The page
    that exists to look after probes was the one page that could not tell you
    how a probe was doing, so every question sent the operator back to the
    Dashboard.
    A card now carries, in the order someone needs them:
    Chest Freezer [Edit]
    Setpoint-000092
    -8.0 °C ● ALARM
    Alarm range -22.0 to -15.0 °C
    Reports every 15 minutes
    127.0.0.1
    ● Online · 45 s ago
    - The reading, sized to be legible across a kitchen rather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
2026-08-05 Edit modal + alert legibility: say what was changed, and make warnings readable
    Driven by using the modal rather than reading it, since "NO ALARM SET" on
    a card now invites the click.
    WHAT WAS ALREADY RIGHT, and I checked before touching: the unit handling.
    The label tracks the unit, stored values convert on open (1 C -> 33.8 F),
    and a Fahrenheit round-trip is exact -- 35 to 40 F stores 1.67/4.44 C and
    reads back 35.0/40.0. Editing only the name creates no spurious interval
    override and leaves other probes' thresholds alone. I nearly "fixed" a
    population bug that did not exist: get_attribute does not reflect a
    React-controlled value, and input_value shows the fields populate fine.
    AN INVER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
2026-08-05 Two pages, one probe, opposite verdicts — and a launcher that gave up
    Verified this round by running the real thing: an SMTP catcher against live
    hubs confirmed the breach mail, the cooldown reminder, the recovery mail, the
    offline mail and the back-online mail all fire and read correctly, and 47,520
    Dash callback invocations across every route x unit x range x probe filter
    came back clean. What follows is what did not.
    The Dashboard and the Devices grid each worked out probe condition on their
    own and reached opposite answers for the same probe. Given one that breached
    its limit and then went silent, the Dashboard tested staleness first and drew
    a calm grey "stale" — dropping the alarm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
2026-08-05 Ingest: stop storing readings where nobody can see them
    Two silent-loss paths on the endpoint every probe and integration talks to,
    found by driving the API the way an integrator would.
    POST /api/ingest with no X-Probe-ID and no body probe_id answered {"ok": true}
    and filed the row under the empty string. Every UI surface skips a blank id by
    design (`if not str(pid).strip(): continue`), "remove device" refuses to touch
    one, and the CSV export writes it with a blank column — so the reading existed,
    counted toward the readings total, and appeared on no screen, with no way to
    delete it. Someone whose integration forgot the header watched the counter
    climb and no probe ever appear. The readin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
2026-08-05 Setup helper: stop claiming the probe isn't there on machines that can't look
    "Set up a new probe" watches for the probe's Setpoint-XXXXXX SoftAP. When it
    saw nothing it said "Setpoint-XXXXXX: not found — power the probe with no saved
    Wi-Fi so it starts the setup network."
    But a hub with no way to scan returns exactly the same empty set as one that
    scanned and found nothing, and that is not a rare configuration:
    * the hub is meant to live on an always-on mini-PC, which is usually wired,
    so there is no Wi-Fi radio to scan with;
    * macOS 14.4 removed the `airport` binary the mac path shells out to, so
    every newer Mac scans nothing (the old code ran the hardcoded path anyway,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
2026-08-06 Test on 3.9 the way CI does, instead of finding out from CI
    test_packaging_version_matches_the_hub_version did `import tomllib`, which is
    stdlib only from 3.11. pyproject.toml says requires-python >=3.9, the launchers
    hunt for 3.9+, and CI runs a 3.9 leg — so the guard passed on the development
    interpreter and turned that leg red, 700 tests deep in the log.
    The version check now reads `version` out of pyproject's [project] table
    directly, and a companion test asserts that shortcut agrees with tomllib
    wherever tomllib exists — so the 3.12 leg keeps the hand parser honest and the
    3.9 leg still gets the drift guard. No new dev dependency for one lookup.
    The class of bug is the interesting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
2026-08-06 Discovery: a probe with a friendly name could never leave the grid
    probe_discovery.py was the least-tested module in the repo at 35%, and the only
    one that parses bytes it did not produce, arriving from any host on the LAN,
    before they reach the Devices grid, /api/probes, Diagnostics and the
    auto-provisioner — which then POSTs the hub's device token to what it finds.
    Writing the tests found this.
    A ServiceStateChange.Removed event was matched against ProbeInfo.name. That
    field is the TXT `name` key, which PROTOCOL.md §3 defines as "friendly name,
    else probe_id" — a human label, equal to the id only by convention. The
    shipping firmware sets them equal (g_instanceName = g_probeId), so re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
2026-08-06 Keep the device token on the LAN
    api/routes.py refuses a body-supplied hostname on the ingest path, and says why:
    A body-supplied hostname lands in the discovery registry, and the
    auto-provisioner then resolves it and POSTs the hub's device token to
    whatever it points at, which would let any client that can reach
    /api/ingest exfiltrate the token to an off-LAN address.
    That closed the ingest route into the registry. The mDNS route it came from was
    left open. _info_to_probe took a service record's `server` field verbatim and
    handed it to getaddrinfo, which falls through to unicast DNS for anything
    outside .local — so a _temps-probe._tcp.local. record advertising
    collector.e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
2026-08-06 Dashboard and Diagnostics: stop showing confidence the hub does not have
    Rendered the real pages against realistic data and looked at them, rather than
    reading the code. Four things a demo would show.
    The gauge — the largest element on the page — kept drawing a probe's last
    reading as a confident green bar after that probe stopped reporting. It sat
    directly beside a "NO DATA" badge saying the opposite, and above per-probe cards
    that had correctly greyed themselves out. It now mutes and its caption reads
    "· last known". The value stays: the last known reading is the most useful thing
    the hub still has, it just must not be dressed as current.
    The Max tile was painted alarm red for every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
2026-08-06 Say it when limits are set but nothing can tell you
    The Settings index renders one badge per section. "Alerts & notifications: Off"
    sat in neutral grey, in a row beside "Keep forever" and "Single site" — two
    defaults that are genuinely fine as they are. So the single setting that decides
    whether this product does its job looked exactly like the ones that were already
    right.
    The belief forms earlier than that, though. Entering a min/max on the Devices
    page is the operator saying "tell me if this goes wrong", and the save
    confirmation is the moment they think they are covered. With the master switch
    off nothing ever reaches them: the dashboard shows the breach, and the 2am
    freezer failure t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
2026-08-06 Exports: ask whether THIS file has humidity, not whether the hub does
    export_friendly_csv's docstring promises "unused humidity/VPD dropped", and the
    gate in front of those columns asked has_humidity() — of the whole table. So one
    grow probe anywhere in the building put a permanently blank humidity_pct and
    vpd_kpa on every other export: the single-freezer file a restaurant hands to an
    inspector, and any date range from before the grow probe was installed.
    The question an export needs answered is about the file being written. The gate
    now takes the export's own filters (window, probe, date range) — the same ones
    _export_where already builds. Called with no arguments it is the identical
    s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
2026-08-06 Three places the hub knew something and did not say it
    Broad review pass over the modules the earlier sweeps had not reached:
    notifications, the audit chain, and the multi-site forwarder's configuration.
    send_email promises (ok, reason) and can raise instead. The EmailMessage
    construction sat outside its own try block, and Python's email package refuses a
    header containing a line break — correctly; that is header injection — by
    raising ValueError. Neither Notifier.dispatch nor the Settings "Send test"
    callback wraps the call, so one malformed recipient in config.json turned the
    test button into an unhandled callback error and every real alert into a bare
    "notification dispatch error" in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
2026-08-06 Provisioner: resolve the probe's name once, not twice
    The LAN gate in front of the device token resolved the probe's hostname to
    decide whether the target was safe — and then provision_probe resolved it again
    to decide where to actually send. Two independent answers to one question, and a
    hostile mDNS responder only has to make them differ: answer with a LAN address
    while being checked, and a public one a moment later.
    core.netaddr.checked_lan_target now returns the verified ADDRESS instead of a
    verdict, and the provisioner sends to that. One lookup, no window.
    token_safe_target stays as the yes/no form, so the multi-site cleartext check
    and the existing tests are unaffected.
    Verified by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
2026-08-06 Stop a busy hub burying its own log, and check the threading model under load
    Stress-tested the running hub: 19 concurrent client threads — twelve writers,
    four readers, two config writers, an exporter — against a hub with all five
    background threads running, for 45 seconds. 13,396 requests, zero failures.
    105,874 rows written with zero write failures and zero rejects, SQLite
    integrity_check ok, zero UNIQUE(probe_id, epoch, site) violations under twelve
    concurrent writers, and config.json still parsing after 369 concurrent writes
    from two threads. The threading model holds.
    What it did surface was the log. Waitress logs a WARNING for every queued
    request while its worker pool is saturat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
2026-08-06 Firmware 2.9.1: a watch-armed report could land a full sample gap late
    Reviewed the firmware while it is on the bench. Found this in the deep-sleep
    duration, which had no test at all — the watch predicates are covered on the
    host, the arithmetic that decides battery life and report punctuality was not.
    With the threshold watch armed the probe sleeps to the next SAMPLE rather than
    the next report, clamped to whatever is left before the report is due so the
    report is not delayed:
    gap = min(cfg_sample_ms, untilReport);
    if (gap < WATCH_SAMPLE_MIN_MS) gap = cfg_sample_ms; // report just fired
    That guard is for untilReport == 0, as its own comment says. Its condition
    instead fires f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
2026-08-06 Replay is only free for stamped rows — and my own throttle had a boot bug
    Two findings, one from reviewing the firmware's buffer drain and one from the
    test container catching my own mistake.
    Three places claimed a re-sent buffer chunk after a dropped ACK is always
    deduped: bufferFlush()'s comment, the firmware's v2.8.1 header note, and
    PROTOCOL.md §7. It holds for STAMPED rows — measured on a live hub, five sent
    three times store five. It does not hold for rows the hub receipt-stamps on
    arrival, which since firmware 2.8.2 means any reading buffered by a probe whose
    clock never synced: the local-first, no-internet deployment this product is sold
    for. A replay gets new stamps, new epoch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
    [esp32_temp_probe.ino]
2026-08-06 Firmware 2.9.2: the deep-sleep clock lost the shutdown tail every wake
    enterDeepSleep() checkpointed the pre-sleep instant at the TOP of the function,
    then flushed Serial, tore down HTTP and mDNS, called WiFi.disconnect() and
    waited 20 ms — all of it after the recorded instant and before the wake timer
    started. The wake-side reconstruction is
    rtc_epochMsAtSleep + rtc_sleepMs + millis()
    which never adds that interval back, so the clock ran slow by the shutdown tail
    on every single wake. One-directional, so it accumulated rather than averaging
    out. The checkpoint is now taken last, immediately before the timer is armed.
    ntpService() still runs before it, which was the reason the checkp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
2026-08-06 Notice when alerting stops
    You asked what is critical. This was: if the alert monitor thread dies, nothing
    in the hub noticed, and no alarm is ever raised again.
    Every other signal keeps looking correct while it is happening. Readings are
    written on the REQUEST thread, not the monitor, so rows_written climbs and
    last_write_age_sec stays small. The dashboard draws live cards and a moving
    chart. /api/health reported healthy: true. setpoint_healthy stayed at 1, so a
    Grafana alert wired to it stayed quiet. The Diagnostics page said "Healthy".
    HealthState's own docstring already reasons about this class of failure — "a
    silently-undelivered alert is its worst failure" — but its counters can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
2026-08-06 Release 2.7.0 — and fix the runbook that was pointing at the wrong files
    The hub was still on 2.6.2 with 95 unreleased changelog entries behind it. Bumped
    to 2.7.0: additive by SemVer — new capability (multi-site roll-up, threshold
    watch, the Settings redesign, worker liveness) with nothing breaking a documented
    contract. Firmware stays on its own track at 2.9.2; they are separate artifacts
    and a dashboard fix does not reflash anybody's probes.
    While bumping, found the version number had drifted a third time.
    firmware/src/protocol.h said 2.8.2 against an .ino on 2.9.2, under a comment
    reading "== FW_VERSION in the .ino". Nothing compared them.
    The cause is in RELEASE.md step 1, which i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
    [protocol.h]
2026-08-06 site: answer the question the pricing section provokes, and stop truncating every search snippet
    Two presentation fixes on a site that was already in good shape.
    The pricing cards showed "$59 · NOT YET FOR SALE · [Reserve]" and gave no
    reason. The reason existed — FCC Part 15B testing — but only in the dark CTA
    band about 2000px further down the page, so anyone reading the prices met a
    restriction with no cause and had to go looking. The two assembled cards also
    carried ~350px of blank space down to their buttons, because only the DIY card
    has a product photo, which read as content missing rather than content absent.
    One change fixes both: the explanation now sits in the card, where t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
2026-08-07 Fix the two things that made the dashboard look like it forgets
    Both reported from real use, both the same underlying mistake: assuming a
    callback fires (or doesn't) when dash-renderer says otherwise.
    Blank dashboard after visiting Devices. DevicesLayout carried its own
    dcc.Store(id='temp-unit-store'), left from when that store lived on the
    dashboard and only one page mounted it at a time. The store later moved to the
    app shell, which mounts it on every page, so the copy became a second live
    component sharing one id. Dash keys components by id: opening Devices pointed
    that id at the copy inside page-content, and navigating away tore the subtree
    down and deleted the entry with it, leaving th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
2026-08-07 Give the reporting interval its real name, and the sample cadence a control
    A probe has two cadences. interval_ms is how often it TRANSMITS; sample_ms is how
    often it READS the sensor in between, radio off, sending early only when a reading
    crosses a limit. That split is the whole reason a probe reporting every 15 minutes
    still catches a thawing freezer in one check.
    The app showed one of them, under the other one's name. The Devices field was
    labelled "Read Interval" and set the reporting interval. The actual read cadence,
    probe_sample_sec, had no control anywhere -- config.json only -- so the threshold
    watch could not be switched on from the app at all. And the defaults switch it
    off: a 6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
2026-08-07 Per-probe check cadence, and an hour of firmware wakes on the host
    One number for the fleet forces the slowest acceptable cadence onto everything.
    A walk-in on mains can afford to look every 10 s; a battery probe in a remote
    freezer on a 15-minute report cannot, and every extra wake is run time it does
    not get back. probe_samples overrides probe_sample_sec per probe, in the same
    shape as probe_intervals and probe_resolutions -- Devices -> Edit, blank inherits,
    and blank is stored by REMOVING the entry so an inheriting probe keeps following
    later fleet-wide changes.
    No firmware change was needed: the probe is already told its own sample_ms and
    persists it in NVS. What did need fixing is the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
2026-08-07 Make the spec and the labels match the wire
    Review pass. Four findings, all of them a document or a label describing
    something the code stopped doing.
    PROTOCOL.md said the /api/ingest config reply was "deliberately limited to
    interval_ms and resolution_bits". The hub has sent alert_min_c, alert_max_c and
    sample_ms in it since 2.6.2, and those three ARE the threshold watch. GET
    /status's watch fields -- which the auto-provisioner reads to decide whether a
    probe needs re-provisioning -- were undocumented entirely, and the /provision push
    body was three fields short. Someone writing a second firmware against that text
    would have produced a probe that looked correct and watched nothing.
    Fixed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
    [esp32_temp_probe.ino]
2026-08-07 Correct a wrong reason in the firmware note
    The first version claimed the merged binary is built outside the repo, so
    bumping flash/manifest.json ahead of a build would advertise an update and then
    install the older image. deploy-flasher.yml rebuilds the binary in CI from the
    .ino on every push touching esp32_temp_probe/ or flash/, and copies manifest.json
    through verbatim -- so the reverse happened: the binary moved and the version did
    not, and 2.9.2 now names two builds that differ by one setup-portal string.
    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
2026-08-07 Firmware 2.9.3 — close the version that named two binaries
    The portal-label change pushed earlier touched esp32_temp_probe/, which triggers
    deploy-flasher.yml. That workflow rebuilds the merged image in CI from this .ino
    and copies flash/manifest.json through verbatim, so the flasher was already
    serving a new binary still advertised as 2.9.2. Nothing behavioural differed --
    one string on the setup portal -- but one version named two builds, which is what
    tests/test_version_sync.py exists to prevent.
    All four declarations moved together (.ino, protocol.h, flash/manifest.json,
    flash/index.html); the next deploy-flasher run republishes with a matching
    manifest. Probes in the field will see a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
    [esp32_temp_probe.ino, protocol.h]
2026-08-07 Alert on excursions that came and went while nobody was looking
    The alert engine judges one reading per probe per cycle -- the latest. A breach
    that starts and clears in between is written to the database, drawn on the chart,
    and never alerted, logged, or shown as an event. On a monitoring product that is
    the worst shape a bug can take: the evidence sits right there and nobody was told.
    Verified before changing anything: a 13-minute excursion, fully recorded, raised
    zero events.
    And the threshold watch made it the NORMAL shape of a hub outage rather than a
    corner case. A watching probe buffers every sample to flash while it cannot reach
    the hub, then flushes the lot on reconnect, so a free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
2026-08-07 Key the backfill sweep on arrival, and give it one owner
    Two bugs, found by replaying a real outage through the HTTP API instead of
    trusting the unit tests.
    First, mine. The sweep keyed its watermark on the newest reading TIMESTAMP, and a
    backlog is old by timestamp and new by arrival -- so "nothing newer than last
    time" is exactly what a flush looks like. Worse, seeding was per probe on first
    sight, and a freshly started hub has never seen any probe, so the flush arriving
    moments after a restart was seeded past and skipped. That is the single scenario
    the feature exists for: the restart that ends an outage is followed immediately by
    the flush that outage caused. It now sweeps on readings.i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
2026-08-08 Stop head office alarming about other hubs' probes
    Found by forwarding a batch into an HQ hub the way the forwarder actually does,
    then asking what it did with it.
    A multi-site hub holds every store's readings and none of their configuration.
    Thresholds, reporting intervals and calibration are per hub; the forwarder sends
    readings and the store's own alert events, not config, and there is nowhere for
    config to go if it did. The hub re-derived alarms from forwarded readings anyway,
    which applies its own settings to somebody else's probes -- confidently, and
    wrongly, three different ways:
    - an HQ running fridges (0..8 C) mailed a LOW alarm for every healthy store
    freezer at -19 C, and drew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
2026-08-08 Show head office the verdict the store actually sent it
    Found by running the real two-hub flow -- a store hub forwarding to an HQ hub --
    rather than simulating the receive half.
    Having stopped head office re-judging forwarded probes with its own thresholds,
    it had nothing left to say about them. So it drew a store freezer sitting in a
    live breach as "no alarm set", while the store's own screen showed "HIGH", for
    the same probe at the same moment. Strictly better than the false "LOW" it showed
    before the scoping fix, and still two hubs disagreeing about one freezer.
    The store owns the thresholds, reaches a verdict, and forwards it; head office
    holds that event and was ignoring it. The card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
2026-08-08 Say it plainly, and stop offering a check that cannot run
    Two things, from the same screenshots.
    The bug first. The between-sends check saves battery by skipping the radio on a
    check wake, and the firmware only decides a wake is check-only when it woke FROM
    deep sleep -- g_sampleOnlyWake is set inside `if (fromDeepSleep)` and nowhere
    else. A probe only deep-sleeps when its send interval is at least
    DEEP_SLEEP_MIN_MS (10 s); below that it stays always-on and transmits every
    reading it takes.
    The hub never knew that. It armed the check whenever a limit was set and the
    cadence was shorter than the send interval, so a probe sending every 6 s with a
    5 s check was told to check between sends, an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
2026-08-10 Carry the instant a reading claims, instead of re-deriving one
    Four bugs, one root: an epoch nobody carried, so somebody re-derived one --
    and re-derivation is only right when the deriver shares the writer's clock
    and timezone. All four are silent, and all four corrupt the ORDERING column
    that every read path in core/db.py filters and sorts on.
    /api/ingest clamped a drifted probe's future timestamp into `ts` and then
    stored that probe's UN-clamped epoch beside it. normalize_payload's clamp
    was therefore decorative on the live path: the row went in with ts=now and
    epoch=2030. One such row pinned `latest` forever, could never be judged
    offline (now - epoch is negative, so the age never exceed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
2026-08-10 Judge every probe on the dashboard by the rule that already exists
    core.status.limits_for is the one place that answers "which limits may THIS
    hub judge this probe by?", and for a forwarded probe the answer is none --
    thresholds are per hub and are not forwarded, so head office re-deriving them
    is not a near miss, it is a different question. build_probe_cards was migrated
    to it. Four other verdicts in the same file were not, and each disagreed with
    the card sitting beside it on the same screen:
    * the alert banner raised a red "below threshold" for every healthy store
    freezer at -19 C on an HQ hub configured for fridges, while that probe's
    own card correctly read "no alarm set";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
2026-08-10 Close six gaps in the API and the background threads
    GET /api/readings served the whole reading history with no auth of its own AND
    was exempt from the dashboard login. The gate exempted the entire `/api/`
    prefix on the stated rationale that those routes have "its own device-token
    auth" -- untrue for /api/readings and /api/readings/latest, neither of which
    calls _check_auth. So switching on the login that SECURITY.md says covers
    "every /download/* route", naming the CSV export specifically, left the same
    data readable one path over: `?from=&to=` walks the entire log. The gate now
    exempts the four operational endpoints SECURITY.md actually ratifies plus the
    five token-authenticated ones a pro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
2026-08-10 Fix the first thing a customer runs, and the numbers on the label
    Start.sh aborted silently on any machine whose `python3` exits non-zero. Under
    `set -e` a BARE assignment from a command substitution takes the command's exit
    status, so a Microsoft Store stub, a dangling pyenv shim or a half-removed
    install killed the launcher INSIDE the discovery loop -- before it could try
    python3.12, and before the "Python 3.9 or newer is required" banner that exists
    to explain exactly this. The customer double-clicks and the window closes with
    nothing on it. The same shape was already handled deliberately further down the
    same file, for the same reason. Two more bare assignments had it: the version
    readou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
    [factory_flash.py]
2026-08-10 Firmware 2.9.4 — four silent faults in the probe
    POST /provision parsed server_url, token, interval_ms and resolution_bits and
    DROPPED alert_min_c, alert_max_c and sample_ms -- the three threshold-watch
    fields PROTOCOL.md §4.1 requires it to persist. The hub's push path sends them
    and the auto-provisioner records the push as delivered, so the Devices dialog
    and Settings both reported the watch as armed while only the PULL path (the
    /api/ingest reply) ever armed it. They are honoured now, with applyHubConfig's
    explicit-null-clears semantics, so deleting a limit on the dashboard actually
    disarms the probe.
    Its parse buffer was 256 bytes against a body that costs about 260 with a real
    hub U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
2026-08-10 Fix what the fixes broke
    An adversarial pass over the eight preceding commits, on the principle that a
    review sweep's own diff is the least-reviewed code in the tree. Nine findings;
    the full suite was green throughout, so none of these would have surfaced on
    their own.
    The bad one first. Conditioning the backfill sweep's suppression on "this run
    was carried in from the previous batch" LOSES REAL INCIDENTS. Backfilled
    readings are old by timestamp, so the monitor's freshness filter keeps them out
    of evaluate() entirely -- which means an excursion long enough to span two
    sweeps was suppressed here having never been reported anywhere. That is the
    precise case the whole missed-excursion feature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
2026-08-10 Five the firmware and packaging reviewers caught
    Routing the DS18B20 fault exit through nextSleepMs was right for a TRANSIENT
    fault and wrong for a persistent one. rtc_msSinceReport is only reset by a
    successful post, so on a dead sensor it sits past cfg_interval forever; every
    wake then looks report-due, which means g_sampleOnlyWake is false and the radio
    comes up for a full association -- every sample gap, indefinitely, on a probe
    whose only problem is an unplugged sensor. The Wi-Fi fail-streak backoff never
    engages because Wi-Fi is fine. nextSleepMs now takes a floor and an
    overdue policy: the fault exit asks for the report cadence once the deadline
    has passed, so a dead sensor costs one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
    [esp32_temp_probe.ino, watch_logic_test.cpp]
2026-08-11 Firmware 2.9.5 — measure the JSON buffers instead of reasoning about them
    Every claim I made about ArduinoJson sizing in 2.9.4 was hand arithmetic. Two
    of those estimates were wrong, in both directions, and re-deriving them a third
    time would not have found that. So this compiles the actual documents against
    ArduinoJson 6.21.6, reads memoryUsage(), and composes the ESP32 figure from the
    slot count (platform-independent) and the copied-string bytes at a 32-bit
    target's 16-byte VariantSlot.
    The measurement found a live bug in a handler nobody had looked at. /whoami
    needs 349 B against its declared 320 with the 128-character server_url the
    captive portal accepts -- P_SERVER_LEN, not a hypoth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
    [esp32_temp_probe.ino, protocol.h]
2026-10-25 Hub 2.8.0 and every doc that states the current version
    The review fixes had shipped under hub 2.7.2 for 39 commits, so a dashboard
    footer could not tell a pre-review hub from a post-review one. 2.8.0 cuts them
    as a release: core/version.py, pyproject.toml, the README badge and
    DEVELOPING.md move together, and CHANGELOG's Unreleased block becomes [2.8.0].
    Docs that state the current version as a present-tense fact had rotted while
    the badges were enforced: firmware/README.md said 2.7.0; the BOM, the user
    manual and the label mock-up the factory prints from said 2.8.2; DEVELOPING's
    /api/health example and the go-to-market "keep in sync" list said hub 2.6.2.
    All now name firmware 2.9.5 / hub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
2026-10-27 Make the hub safe to walk away from: heartbeat, keep-awake, login, phone alerts
    Every alarm Setpoint raises is raised by the hub, so a hub PC that crashed, lost
    power, idled to sleep or was restarted by Windows Update went silent with
    nobody told. That is the failure that loses a freezer, and nothing covered it.
    Heartbeat (core/heartbeat.py): an optional check-in to healthchecks.io or an
    Uptime Kuma push monitor, which alerts when the check-ins stop. It is ticked
    from the alert monitor's own loop only after a clean cycle, and withheld while
    database writes are failing, so a wedged monitor or a full disk stops it the
    same way a dead PC does. Each request runs off-thread so a black-holed host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
